IITB-Rocket-Team-Avionics/FLYTE/README.md

# FLYTE
Flight Computer for the IIT Bombay Rocket Team
