IITB-Rocket-Team-Avionics/FLYTE/Software_v2/PAYLOAD/README

# This folder has the libraries for the sensors used in the payload.
