IITB-Rocket-Team-Avionics/FLYTE/Eagle files/FLYTE 2.0/main/FLYTE-v2-obt.png

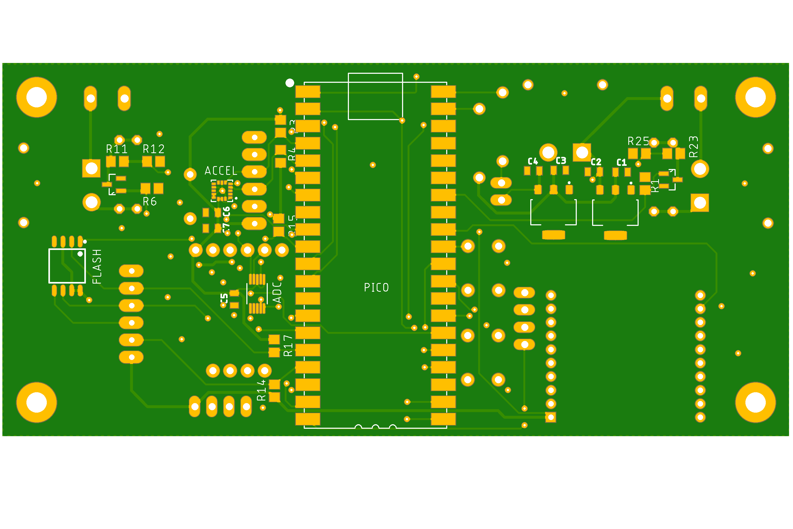
Eagle files/FLYTE 2.0/main/FLYTE-v2-obt.png
