IITB-Rocket-Team-Avionics/FLYTE/Eagle files/FLYTE 2.0/main/FLYTE-v2.png

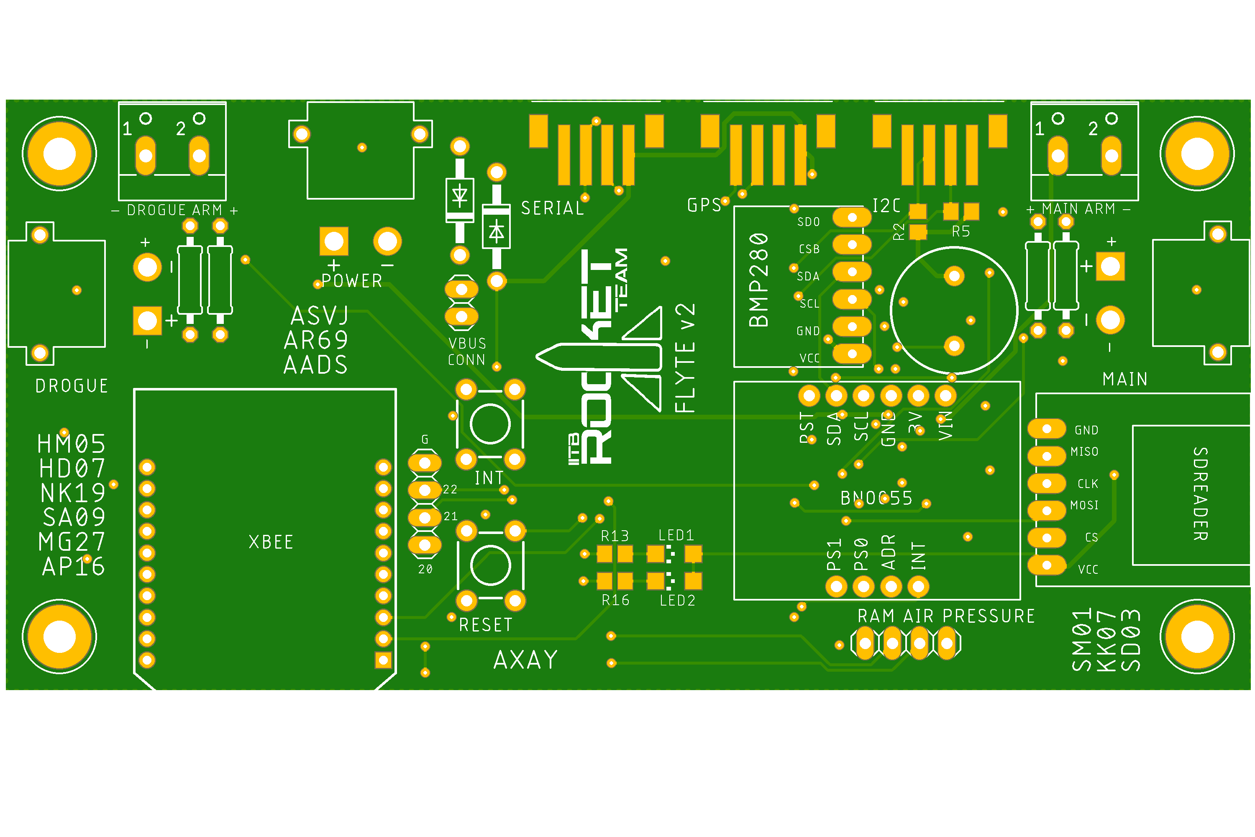
Eagle files/FLYTE 2.0/main/FLYTE-v2.png
