IITB-Rocket-Team-Avionics/FLYTE/Eagle files/FLYTE 2.0/main/motor_controller-BOT.png

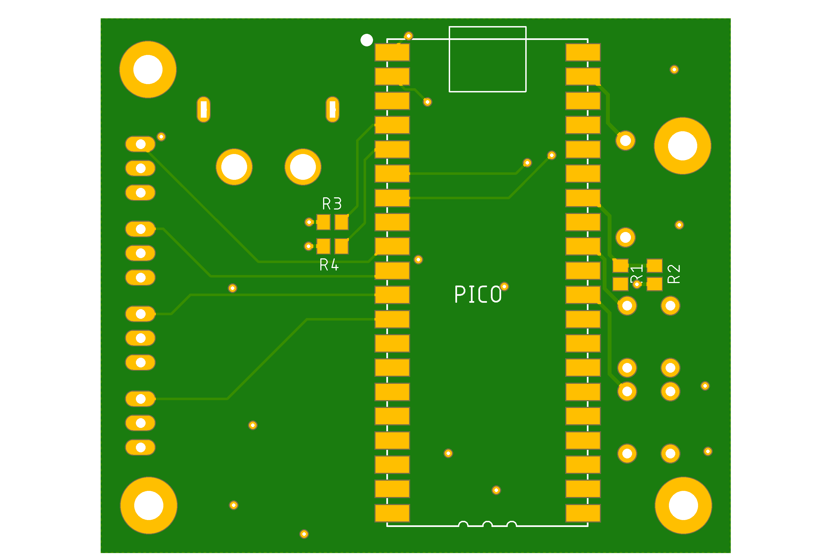
Eagle files/FLYTE 2.0/main/motor_controller-BOT.png
