IITB-Rocket-Team-Avionics/FLYTE/Eagle files/FLYTE 2.0/main/motor_controller.png

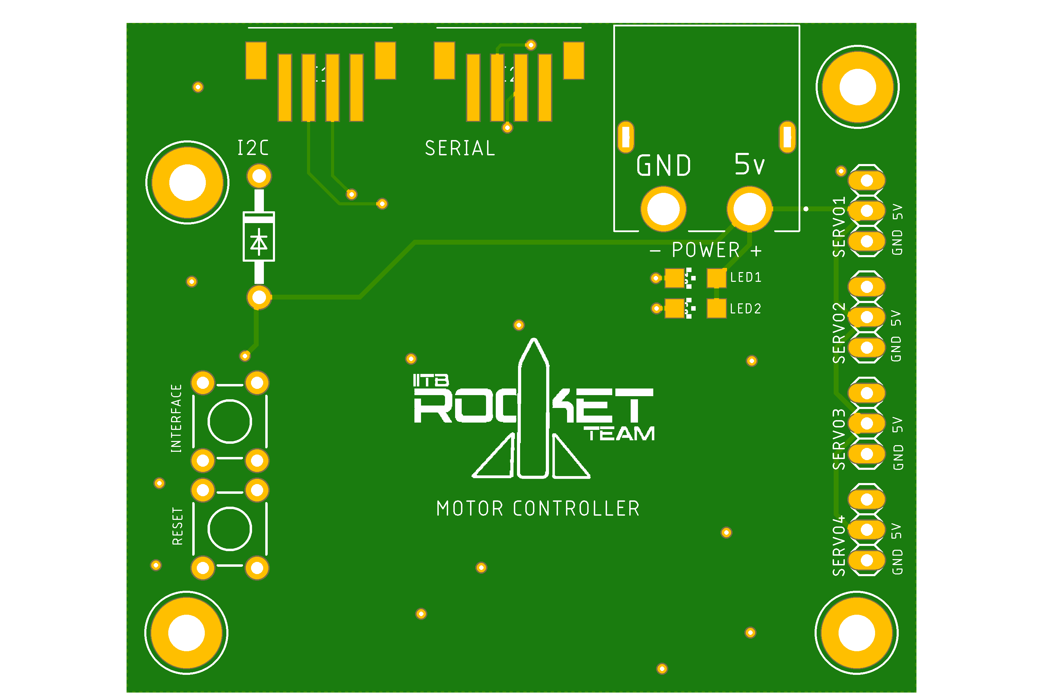
Eagle files/FLYTE 2.0/main/motor_controller.png
