IITB-Rocket-Team-Avionics/FLYTE/Eagle files/FLYTE 2.0/main/reefingBrd-BOT.png

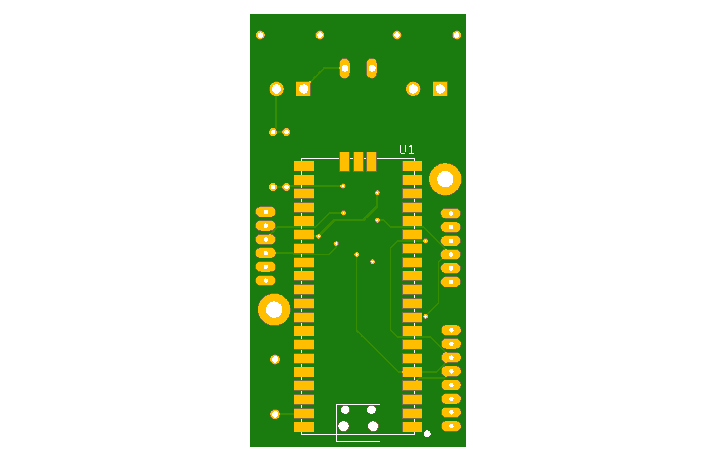
Eagle files/FLYTE 2.0/main/reefingBrd-BOT.png
