IITB-Rocket-Team-Avionics/FLYTE/Eagle files/FLYTE 2.0/Screenshot 2023-12-10 035226.png

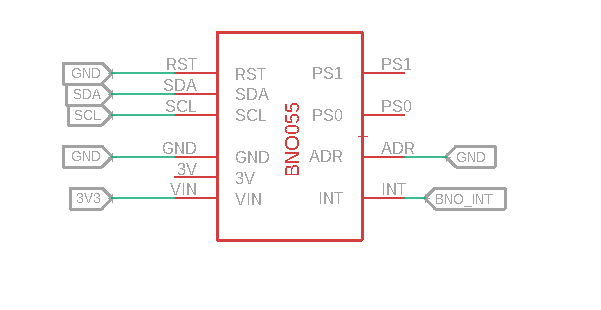
Eagle files/FLYTE 2.0/Screenshot 2023-12-10 035226.png
