IITB-Rocket-Team-Avionics/FLYTE/Eagle files/FLYTE 2.1/images/motor_controller_2_1.png

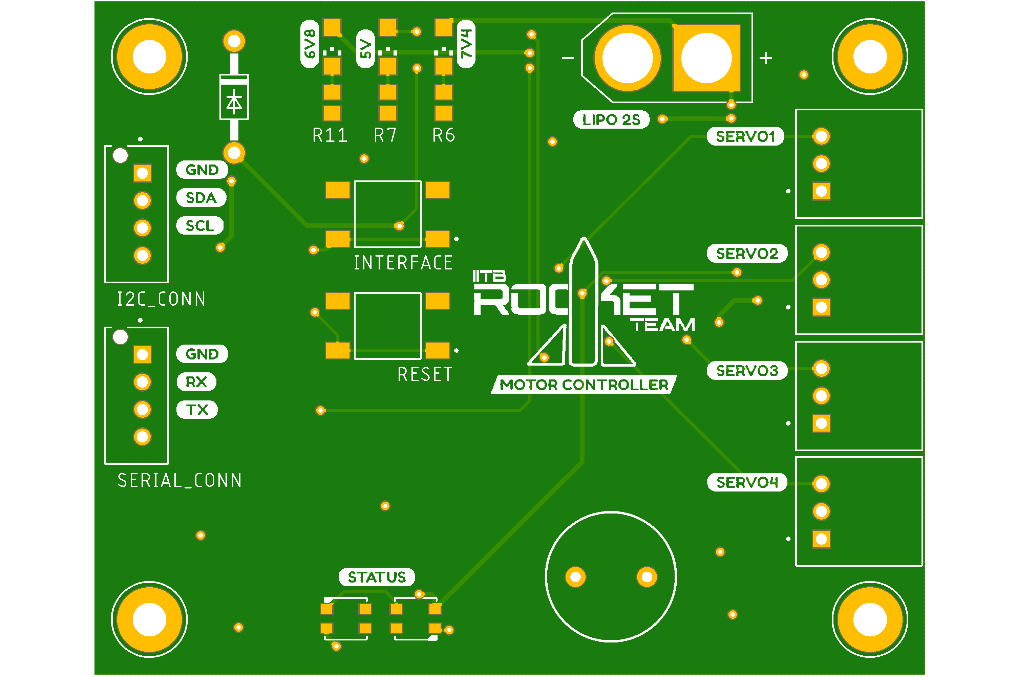
Eagle files/FLYTE 2.1/images/motor_controller_2_1.png
