IITB-Rocket-Team-Avionics/FLYTE/Eagle files/FLYTE 2.1/images/payload2.png

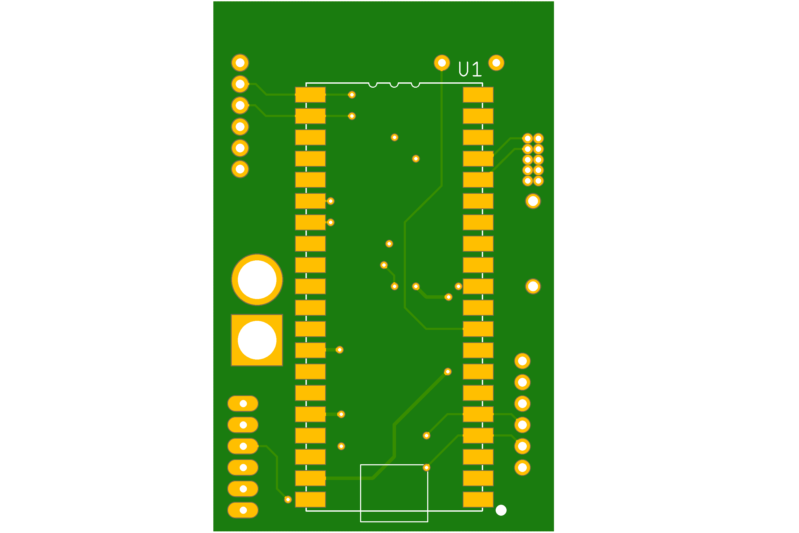
Eagle files/FLYTE 2.1/images/payload2.png
