IITB-Rocket-Team-Avionics/FLYTE/Eagle files/FLYTE 2.1/images/Payload.png

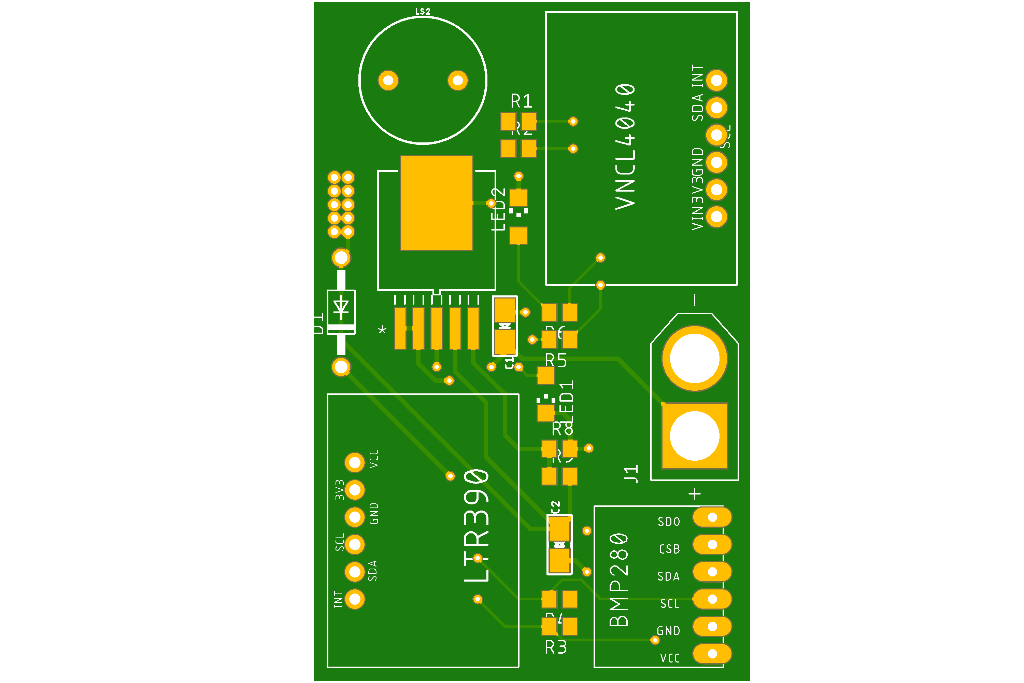
Eagle files/FLYTE 2.1/images/Payload.png
