IITB-Rocket-Team-Avionics/FLYTE/Eagle files/FLYTE 2.1/motor_controller_2_2.png

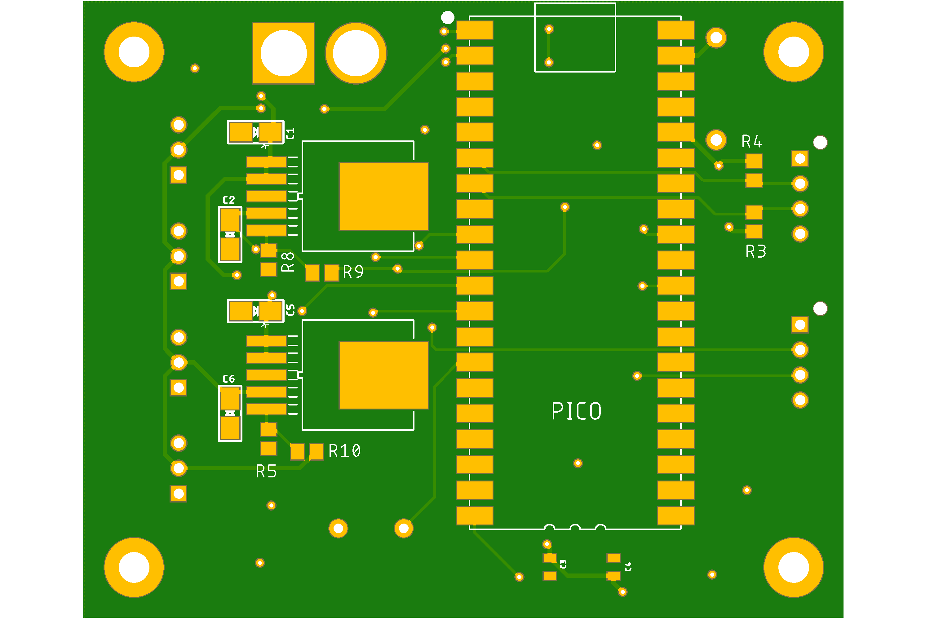
Eagle files/FLYTE 2.1/motor_controller_2_2.png
