IITB-Rocket-Team-Avionics/FLYTE/3D models/pressure_sensor_assy_HX710B.STEP

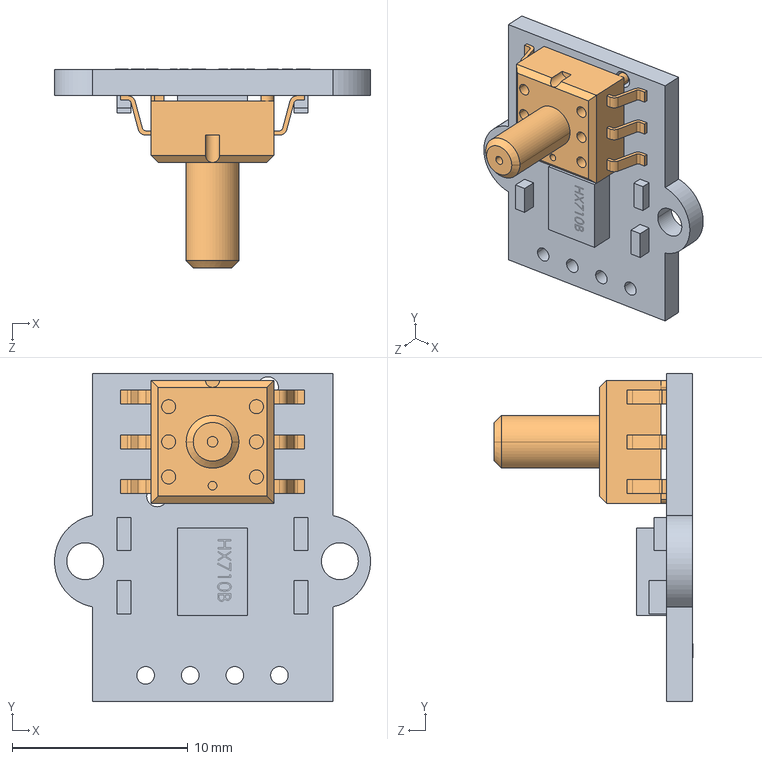
[picture p11: CAD file, 2024-01-20]
3D models/pressure_sensor_assy_HX710B.STEP
18.0 x 18.7 x 11.3 mm
pressure_sensor_pcb_HX710B
MPS-3117_По умолчанию
