IITB-Rocket-Team-Avionics/FLYTE/3D models/B5B-XH-A-LF--SN---3DModel-STEP-418109.STEP

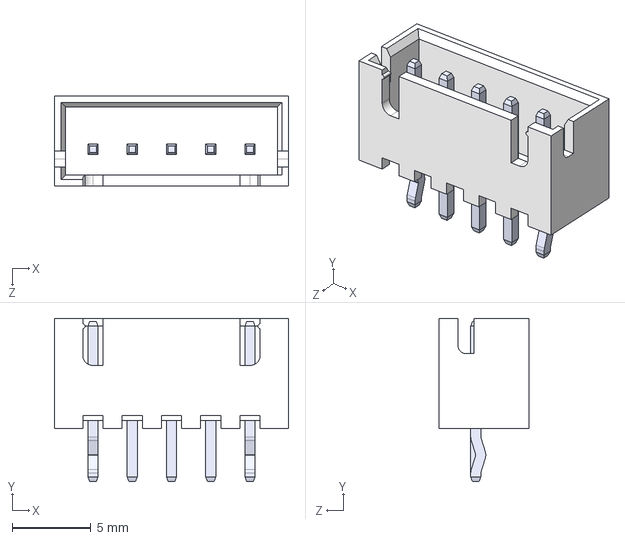
[picture p12: CAD file, 2024-05-10]
3D models/B5B-XH-A-LF--SN---3DModel-STEP-418109.STEP
14.9 x 10.4 x 5.75 mm
