IITB-Rocket-Team-Avionics/FLYTE/Eagle files/Ground-station/nuclear breifcase v4.dxf

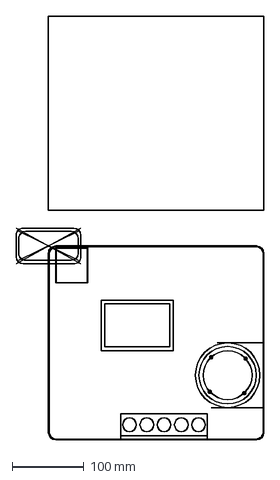
[picture p14: CAD file, 2025-03-29]
Eagle files/Ground-station/nuclear breifcase v4.dxf
345.0 x 590.0 mm
