IITB-Rocket-Team-Avionics/FLYTE/3D models/TAJA_AVX.step

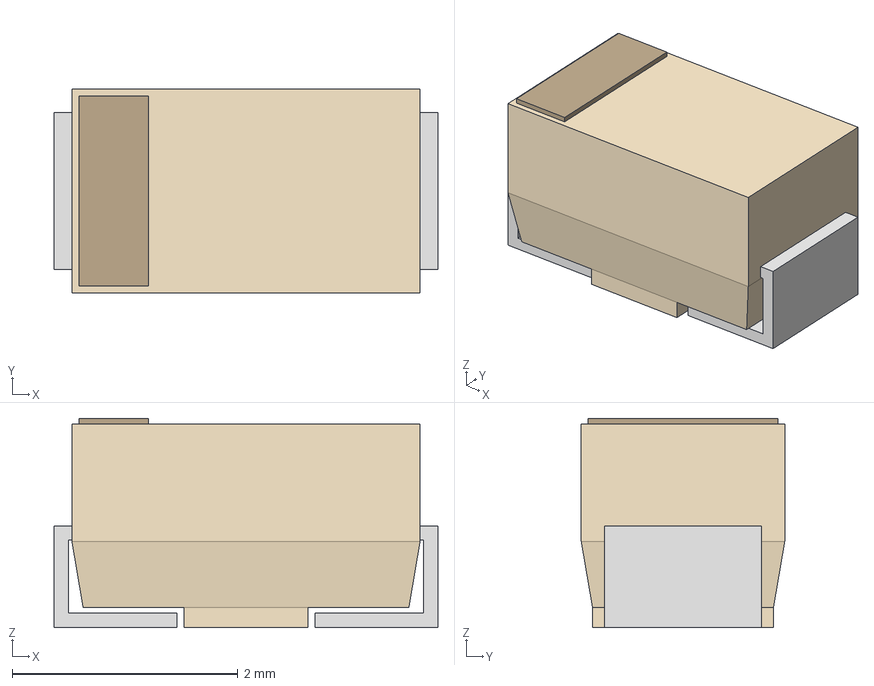
[picture p15: CAD file, 2024-05-10]
3D models/TAJA_AVX.step
3.40 x 1.80 x 1.85 mm
