IITB-Rocket-Team-Avionics/FLYTE/3D models/TO-263-5_MCH.step

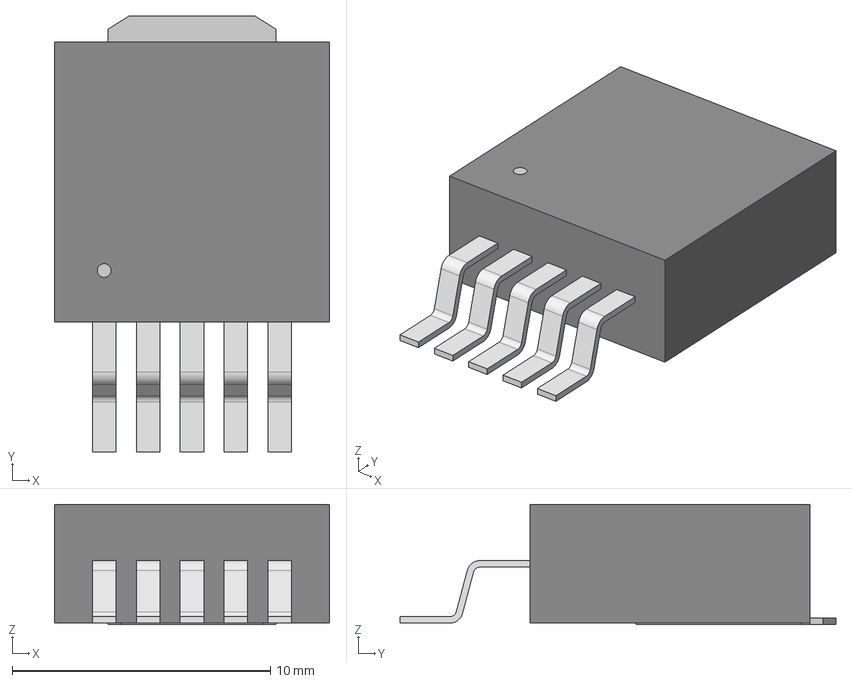
[picture p16: CAD file, 2024-05-10]
3D models/TO-263-5_MCH.step
10.7 x 16.9 x 4.65 mm
