IITB-Rocket-Team-Avionics/FLYTE/3D models/B6B-XH-A-LF--SN---3DModel-STEP-418109.STEP

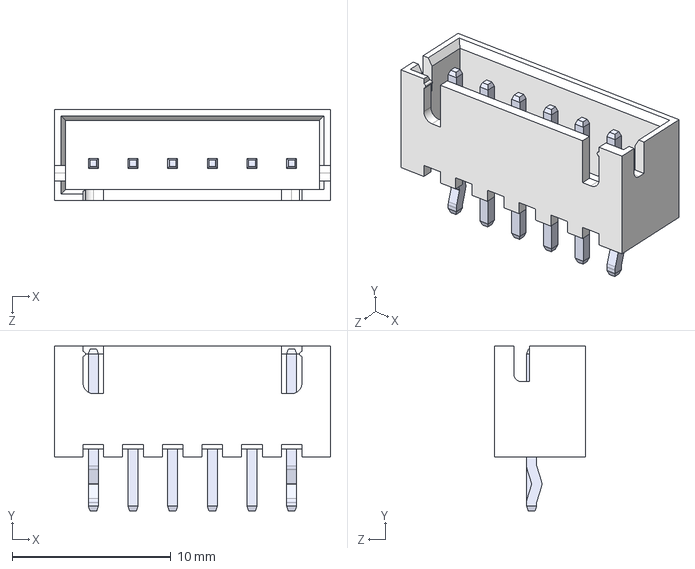
[picture p17: CAD file, 2024-05-09]
3D models/B6B-XH-A-LF--SN---3DModel-STEP-418109.STEP
17.4 x 10.4 x 5.75 mm
