IITB-Rocket-Team-Avionics/FLYTE/3D models/WS2812B--3DModel-STEP-510211.STEP

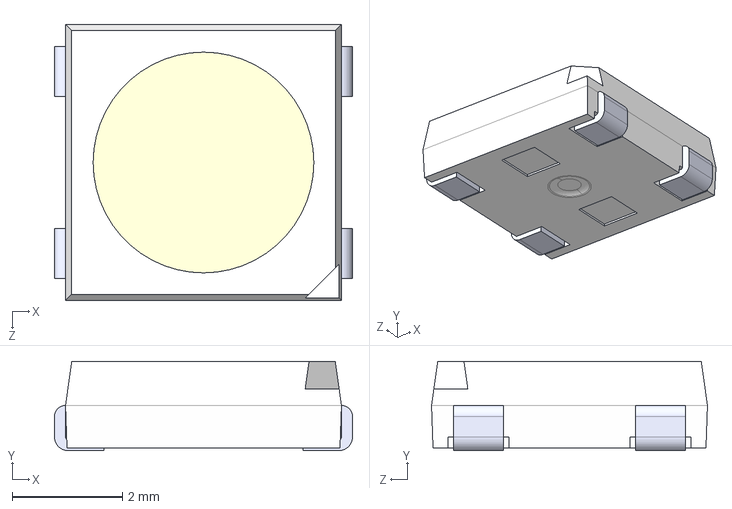
[picture p18: CAD file, 2024-05-08]
3D models/WS2812B--3DModel-STEP-510211.STEP
5.40 x 1.62 x 5.00 mm
