IITB-Rocket-Team-Avionics/FLYTE/3D models/TS04-66-95-BK-100-SMT--3DModel-STEP-56544.STEP

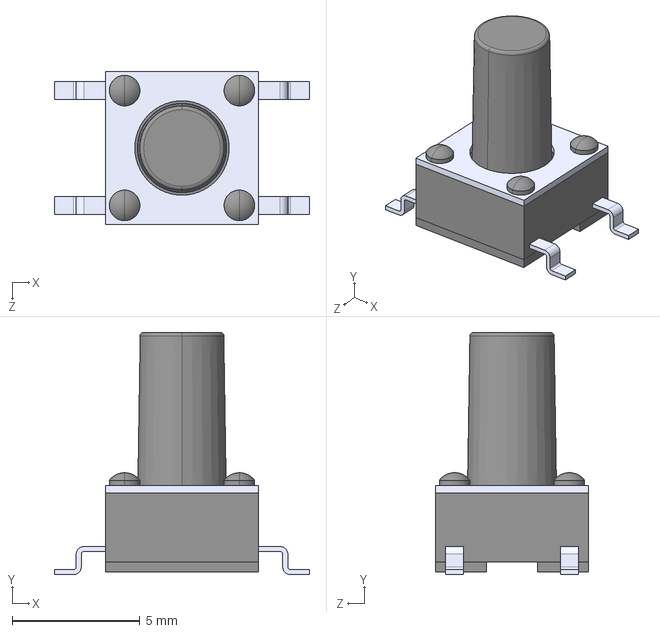
[picture p19: CAD file, 2024-05-08]
3D models/TS04-66-95-BK-100-SMT--3DModel-STEP-56544.STEP
10.0 x 9.50 x 6.00 mm
