IITB-Rocket-Team-Avionics/FLYTE/3D models/B4B-XH-AM -LF--SN---3DModel-STEP-56544.STEP

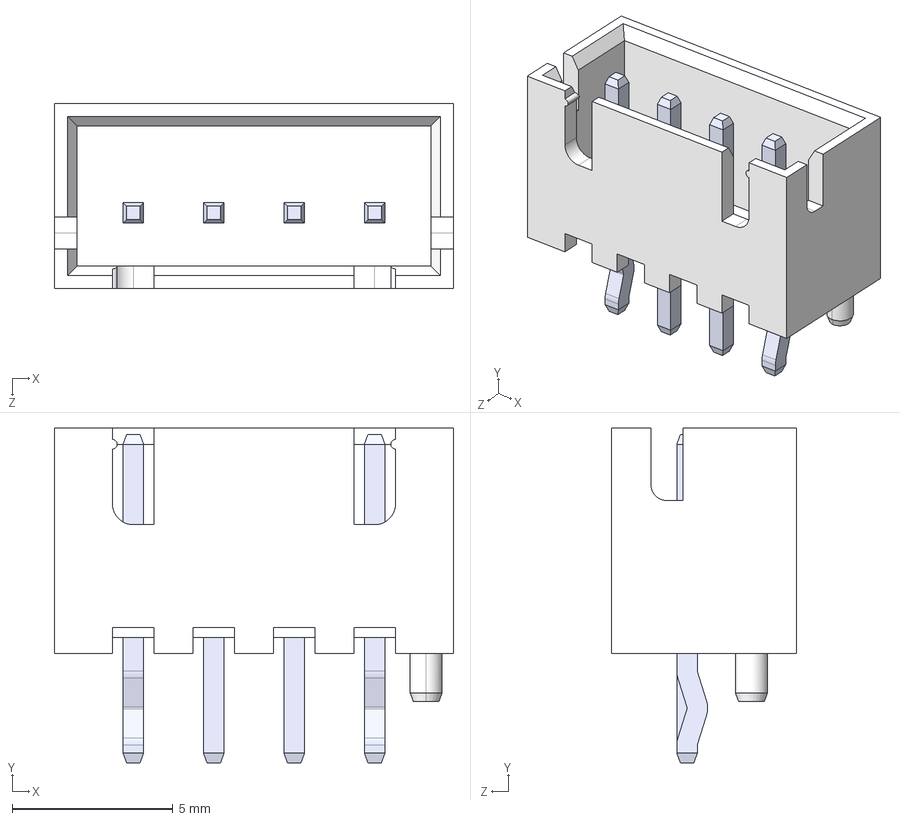
[picture p20: CAD file, 2024-05-08]
3D models/B4B-XH-AM -LF--SN---3DModel-STEP-56544.STEP
12.4 x 10.4 x 5.75 mm
