IITB-Rocket-Team-Avionics/FLYTE/3D models/S3B-XH-A-LF--SN---3DModel-STEP-56544.STEP

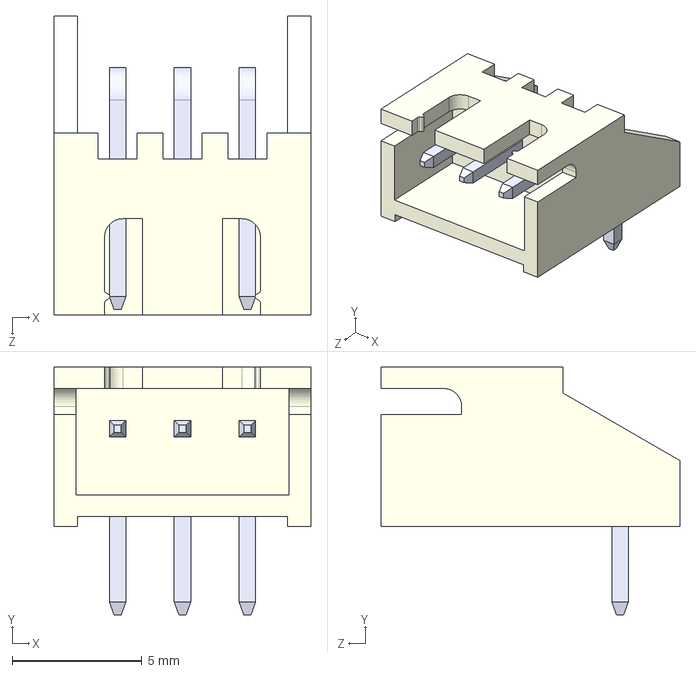
[picture p21: CAD file, 2024-05-08]
3D models/S3B-XH-A-LF--SN---3DModel-STEP-56544.STEP
9.90 x 9.55 x 11.5 mm
