IITB-Rocket-Team-Avionics/FLYTE/3D models/ITG-MPU.STEP

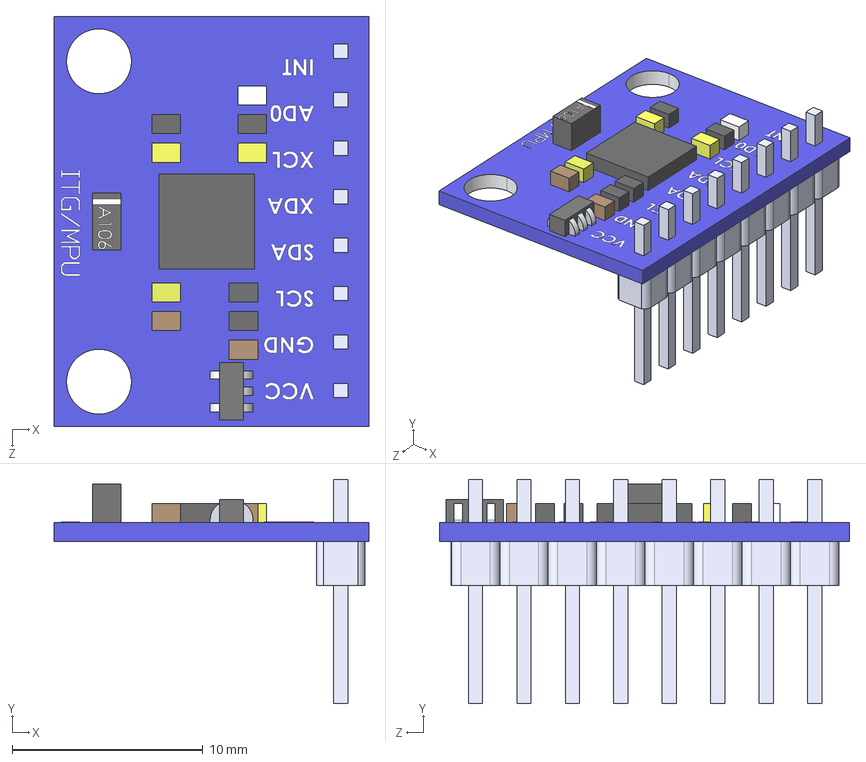
[picture p22: CAD file, 2024-01-25]
3D models/ITG-MPU.STEP
16.5 x 11.8 x 21.5 mm
8 Header-Pin
Placa_Base
