IITB-Rocket-Team-Avionics/FLYTE/3D models/XT60PW-F--3DModel-STEP-510211.STEP

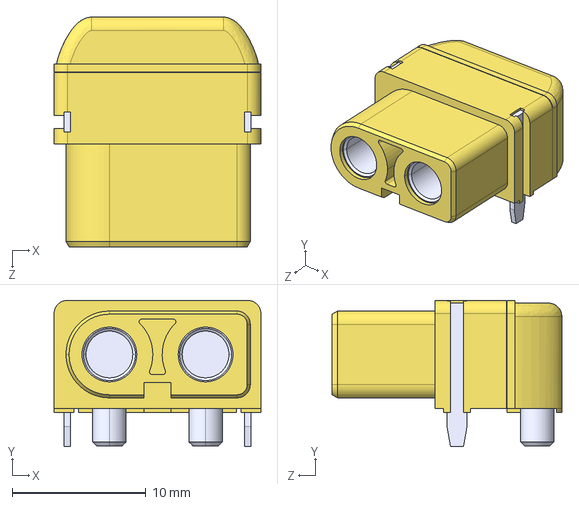
[picture p23: CAD file, 2024-01-20]
3D models/XT60PW-F--3DModel-STEP-510211.STEP
15.5 x 10.9 x 17.2 mm
