IITB-Rocket-Team-Avionics/FLYTE/3D models/XT30PW-M--3DModel-STEP-1.STEP

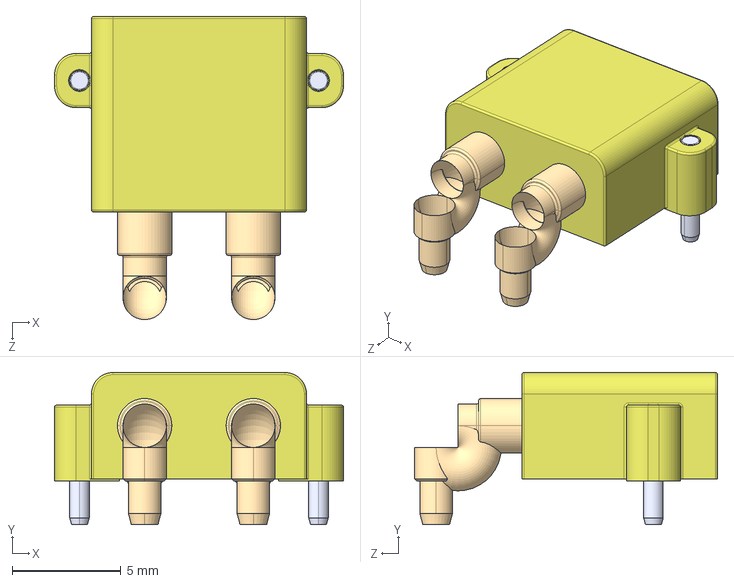
[picture p24: CAD file, 2024-01-20]
3D models/XT30PW-M--3DModel-STEP-1.STEP
13.3 x 7.00 x 14.0 mm
