IITB-Rocket-Team-Avionics/FLYTE/3D models/XBP24BZ7SIT-004-radio.STEP

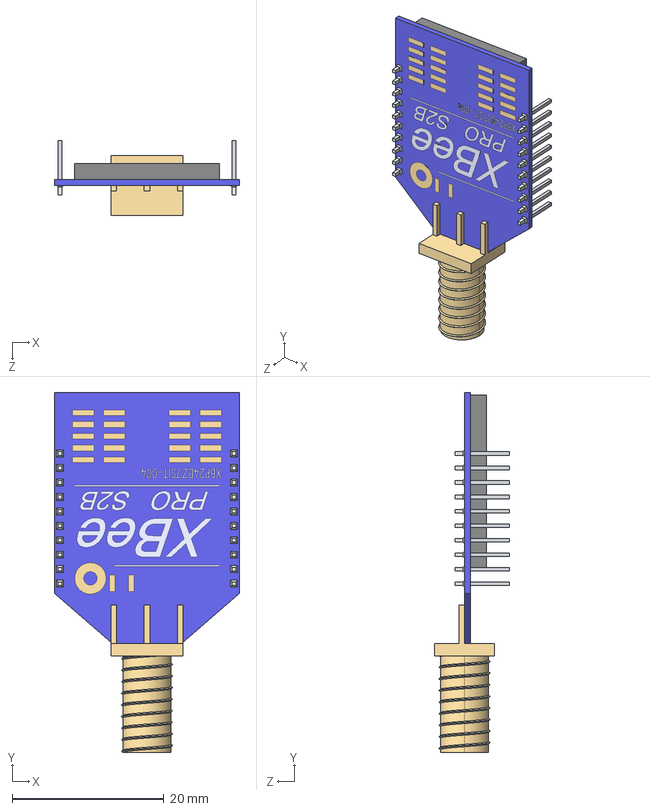
[picture p25: CAD file, 2024-01-20]
3D models/XBP24BZ7SIT-004-radio.STEP
24.4 x 47.4 x 9.88 mm
