IITB-Rocket-Team-Avionics/FLYTE/3D models/XbeePro-SMA.STEP

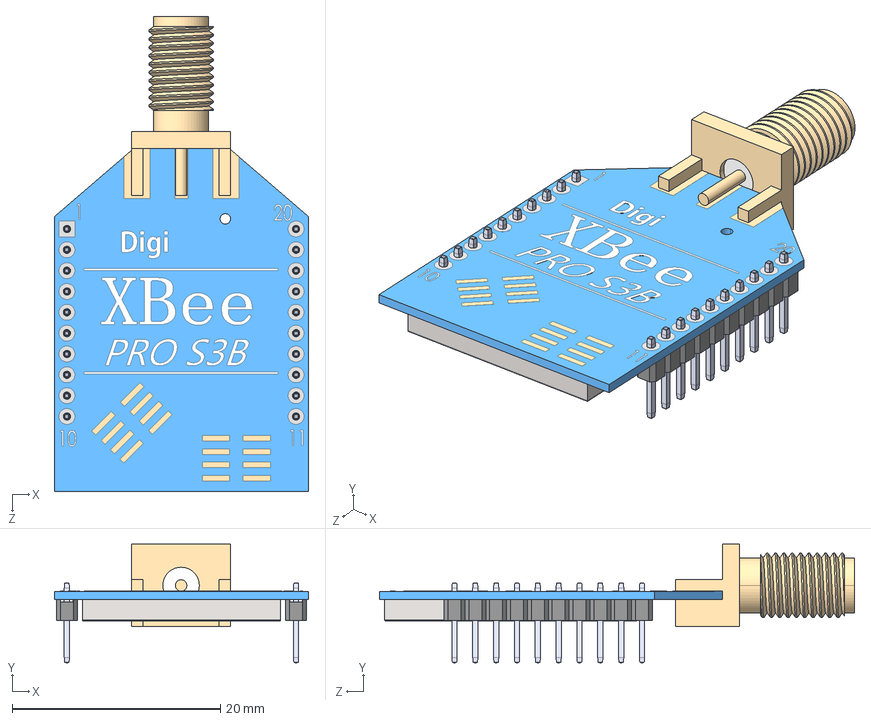
[picture p26: CAD file, 2024-01-20]
3D models/XbeePro-SMA.STEP
24.4 x 11.4 x 45.6 mm
XBP24_with_Pads.STEP
2mmHeaderPin_straight.STEP x 20
XBPro_shield.STEP
SMA-Z.STEP
