IITB-Rocket-Team-Avionics/FLYTE/3D models/Adafruit_BNO055_AP214.STEP

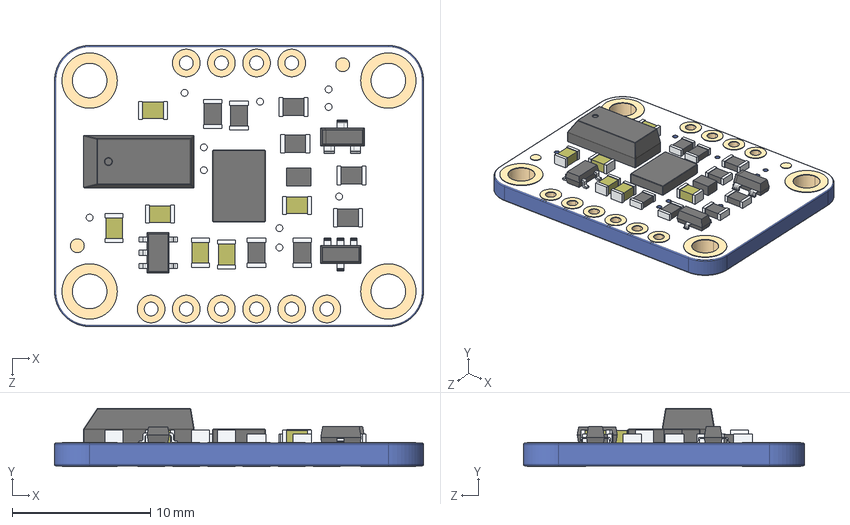
[picture p27: CAD file, 2024-01-20]
3D models/Adafruit_BNO055_AP214.STEP
26.7 x 4.20 x 20.3 mm
