IITB-Rocket-Team-Avionics/FLYTE/3D models/H3LIS200DLTR.STEP

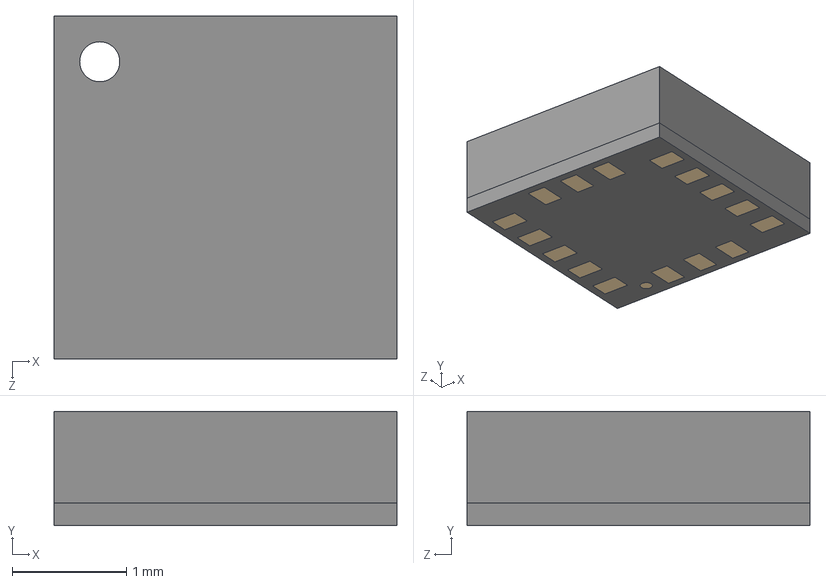
[picture p28: CAD file, 2024-01-20]
3D models/H3LIS200DLTR.STEP
3.00 x 1.00 x 3.00 mm
