IITB-Rocket-Team-Avionics/FLYTE/3D models/S4B-PH-SM4-TB.stp

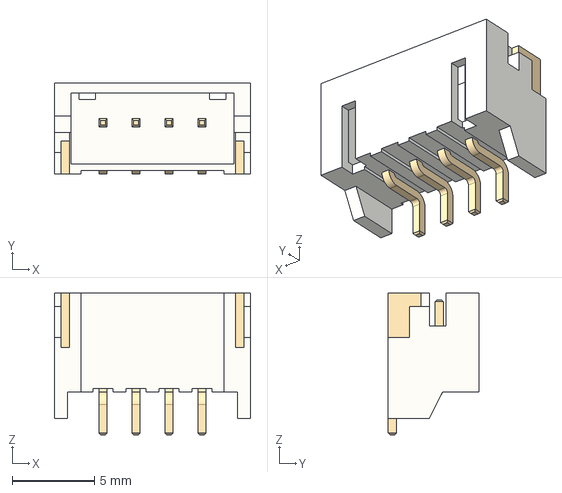
[picture p29: CAD file, 2024-01-20]
3D models/S4B-PH-SM4-TB.stp
11.9 x 5.50 x 8.60 mm
