IITB-Rocket-Team-Avionics/FLYTE/3D models/ADS1115IDGSR.STEP

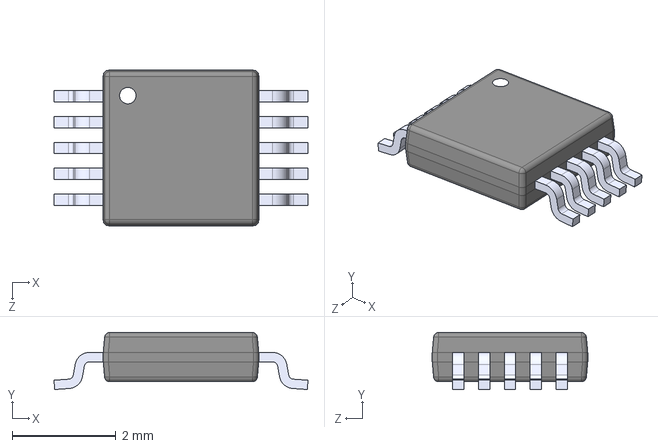
[picture p30: CAD file, 2024-01-20]
3D models/ADS1115IDGSR.STEP
4.90 x 1.10 x 3.00 mm
