IITB-Rocket-Team-Avionics/FLYTE/3D models/SMBJ40CA-HR.stp

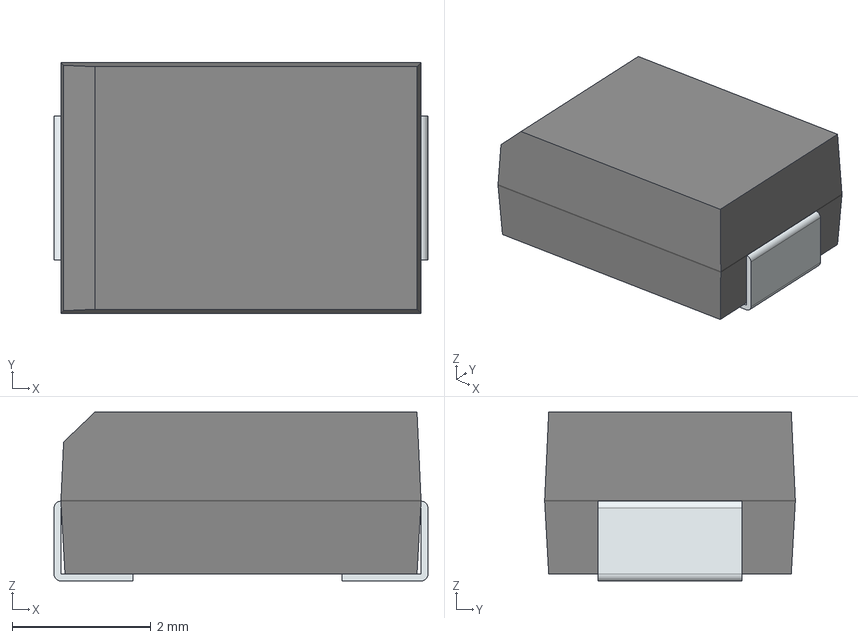
[picture p31: CAD file, 2023-12-21]
3D models/SMBJ40CA-HR.stp
5.40 x 3.62 x 2.44 mm
FilletPin1
FilletPin2
