IITB-Rocket-Team-Avionics/FLYTE/3D models/toggle.STEP

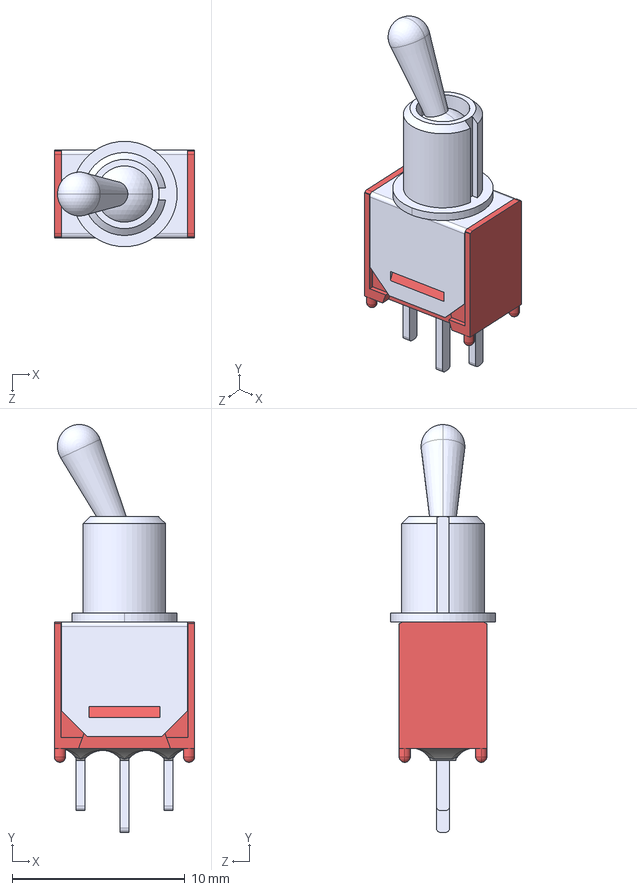
[picture p32: CAD file, 2023-05-24]
3D models/toggle.STEP
8.13 x 23.6 x 6.10 mm
