IITB-Rocket-Team-Avionics/FLYTE/3D models/HX711.step

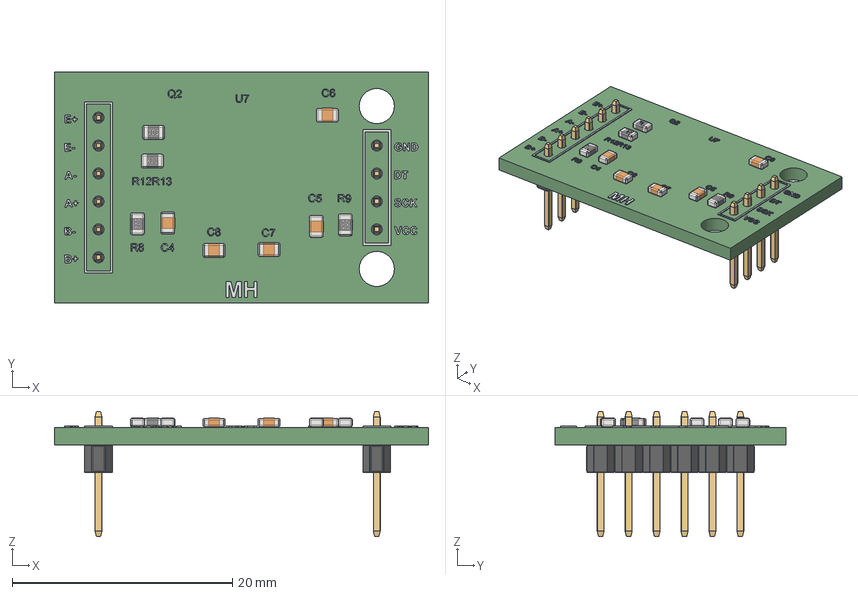
[picture p33: CAD file, 2023-05-24]
3D models/HX711.step
34.0 x 21.0 x 11.4 mm
Valor predeterminado
Valor predeterminado_1
Valor predeterminado_2 x 2
base_HX711-1
pino_HX711-1
pino_HX711-2
pino_HX711-3
pino_HX711-4
pino_HX711-5
pino_HX711-6
pino_HX711-7
pino_HX711-8
pino_HX711-9
pino_HX711-10
pino_HX711-11
pino_HX711-12
pino_HX711-13
pino_HX711-14
pino_HX711-15
pino_HX711-16
TRANSISTOR_SOT23-1
PINO_SOT23-1
PINO_SOT23-2
PINO_SOT23-3
Valor predeterminado_5 x 5
Male Pin Header x 4
Male Pin Header_1 x 6
