IITB-Rocket-Team-Avionics/FLYTE/3D models/XT30-female.stl

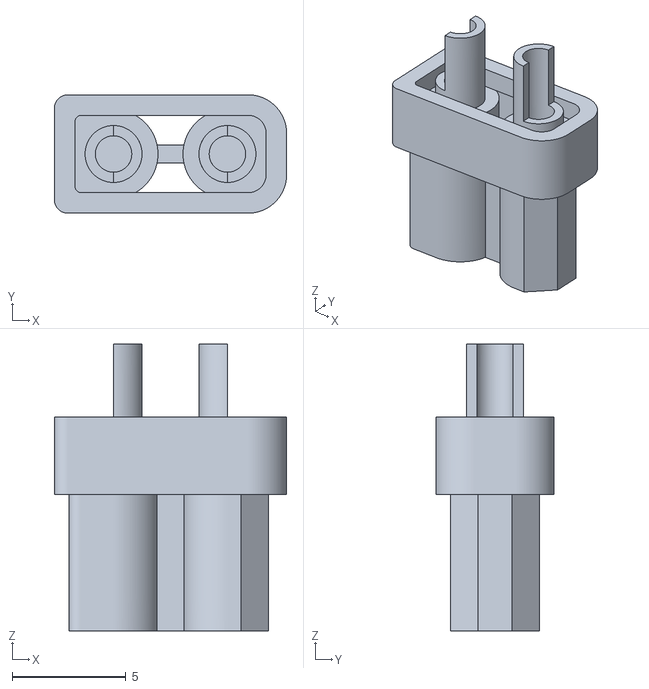
[picture p34: CAD file, 2023-05-14]
3D models/XT30-female.stl
10.2 x 5.20 x 12.6
