IITB-Rocket-Team-Avionics/FLYTE/3D models/MicroSD Card Module - 1.stp

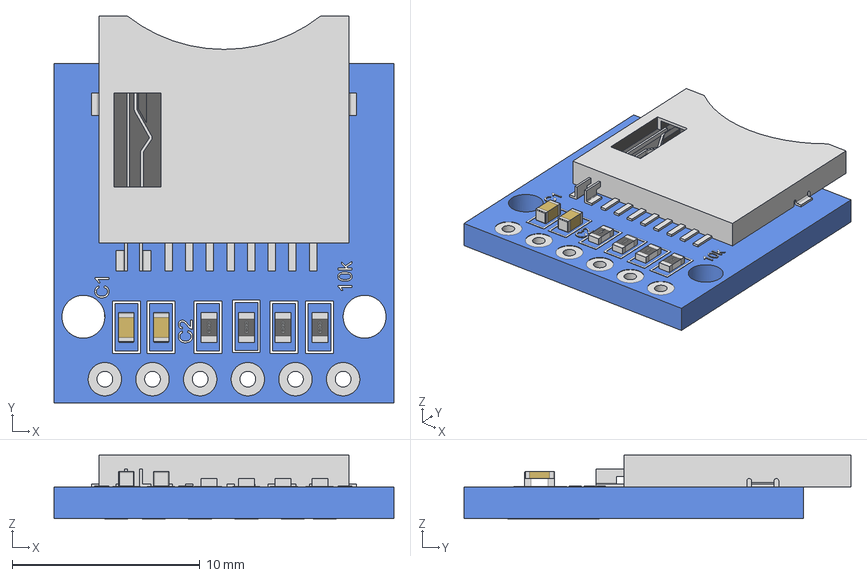
[picture p35: CAD file, 2023-05-14]
3D models/MicroSD Card Module - 1.stp
18.1 x 20.6 x 3.40 mm
Micro SD Module - 1
MicroSD
0603 Capacitor x 2
0603 Resistor x 4
