IITB-Rocket-Team-Avionics/FLYTE/3D models/PLS2-3.step

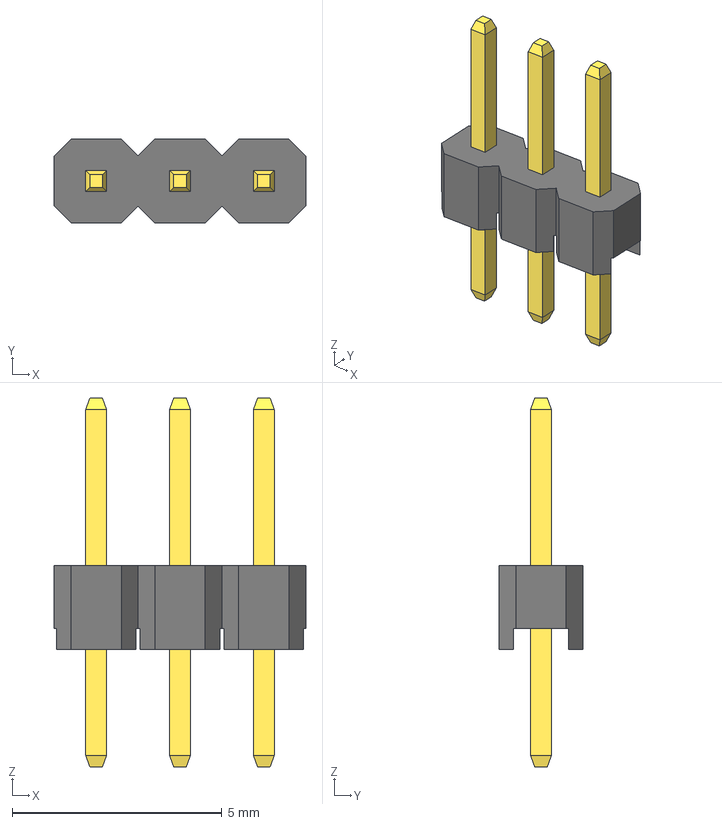
[picture p36: CAD file, 2023-05-14]
3D models/PLS2-3.step
6.00 x 2.00 x 8.80 mm
