IITB-Rocket-Team-Avionics/FLYTE/3D models/XT30-male.stp

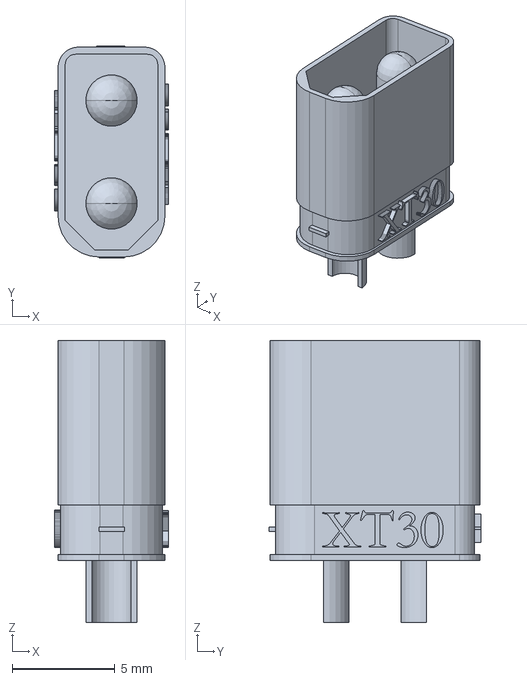
[picture p37: CAD file, 2023-05-14]
3D models/XT30-male.stp
5.54 x 10.3 x 13.7 mm
