IITB-Rocket-Team-Avionics/FLYTE/3D models/GPS_18x18_ant.stp

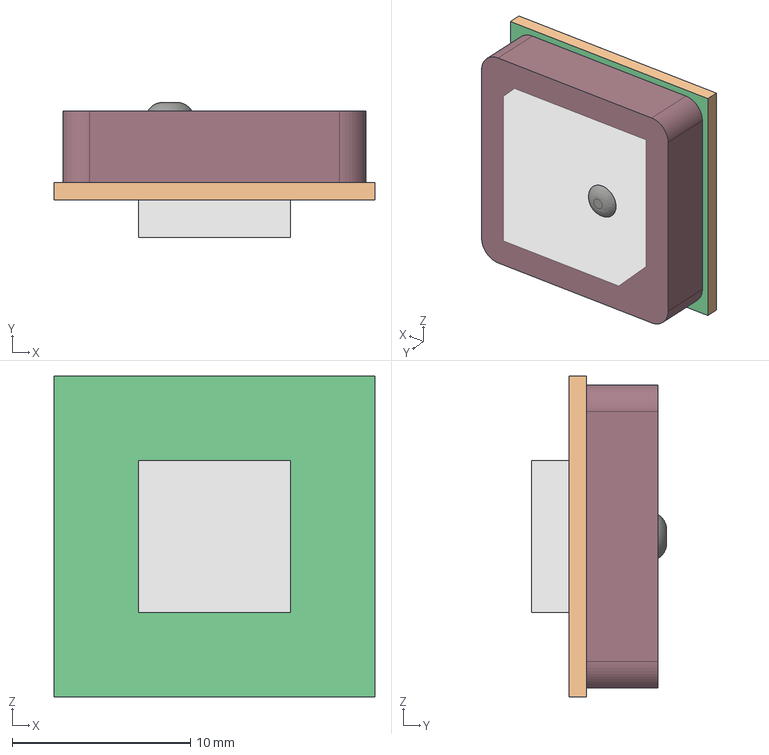
[picture p38: CAD file, 2023-05-13]
3D models/GPS_18x18_ant.stp
18.0 x 7.59 x 18.0 mm
