IITB-Rocket-Team-Avionics/FLYTE/3D models/W25Q32JVSSIQ--3DModel-STEP-269445.STEP

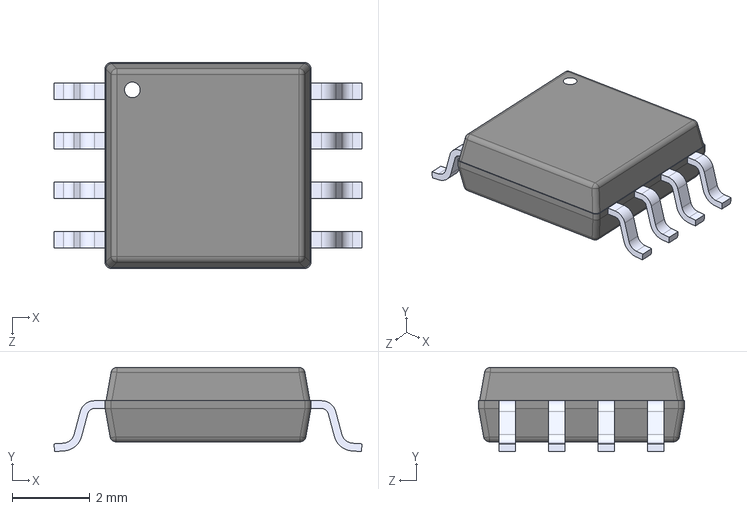
[picture p39: CAD file, 2023-05-13]
3D models/W25Q32JVSSIQ--3DModel-STEP-269445.STEP
7.90 x 2.16 x 5.28 mm
