IITB-Rocket-Team-Avionics/FLYTE/3D models/CONSMA002--3DModel-STEP-1.STEP

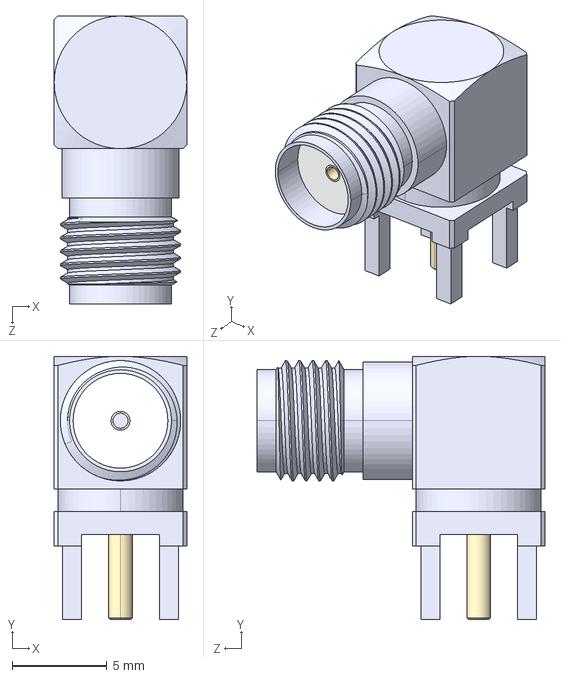
[picture p40: CAD file, 2023-05-13]
3D models/CONSMA002--3DModel-STEP-1.STEP
7.00 x 13.9 x 15.2 mm
