IITB-Rocket-Team-Avionics/FLYTE/3D models/TL1105F160Q--3DModel-STEP-56544.STEP

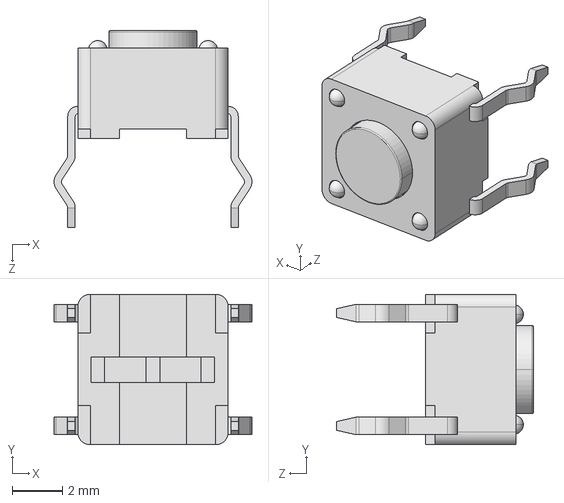
[picture p41: CAD file, 2023-05-13]
3D models/TL1105F160Q--3DModel-STEP-56544.STEP
7.89 x 6.00 x 7.85 mm
