IITB-Rocket-Team-Avionics/FLYTE/3D models/SC0915--3DModel-STEP-56544.STEP

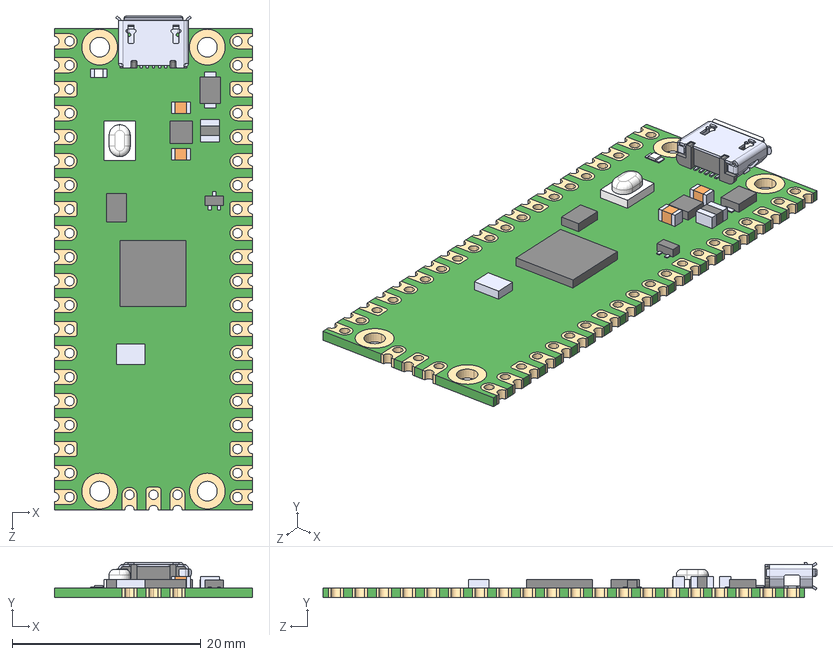
[picture p42: CAD file, 2023-05-13]
3D models/SC0915--3DModel-STEP-56544.STEP
21.0 x 3.73 x 52.3 mm
