IITB-Rocket-Team-Avionics/FLYTE/3D models/XT60-M--3DModel-STEP-56544.STEP

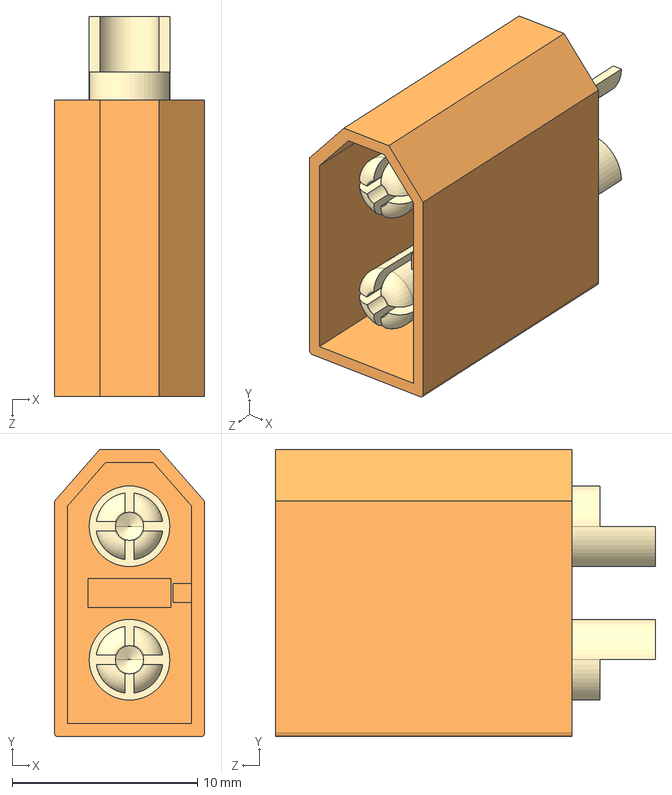
[picture p43: CAD file, 2023-05-10]
3D models/XT60-M--3DModel-STEP-56544.STEP
8.10 x 15.5 x 20.5 mm
