IITB-Rocket-Team-Avionics/FLYTE/3D models/IRF540NPBF.STEP

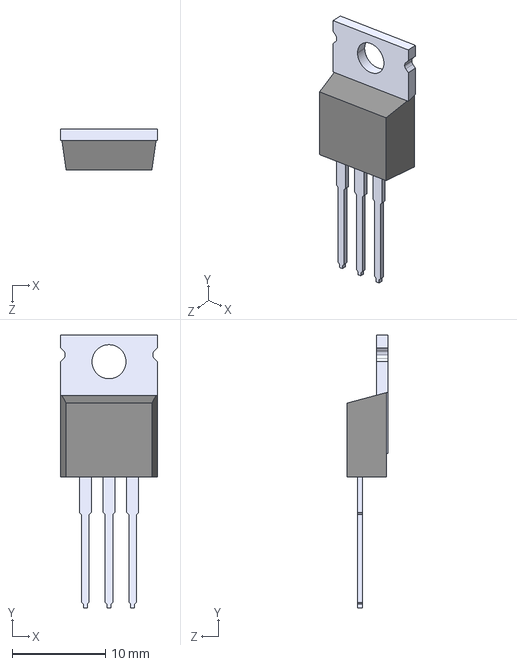
[picture p44: CAD file, 2023-05-10]
3D models/IRF540NPBF.STEP
10.4 x 29.3 x 4.45 mm
