IITB-Rocket-Team-Avionics/FLYTE/3D models/LD051A121KAB2A.STEP

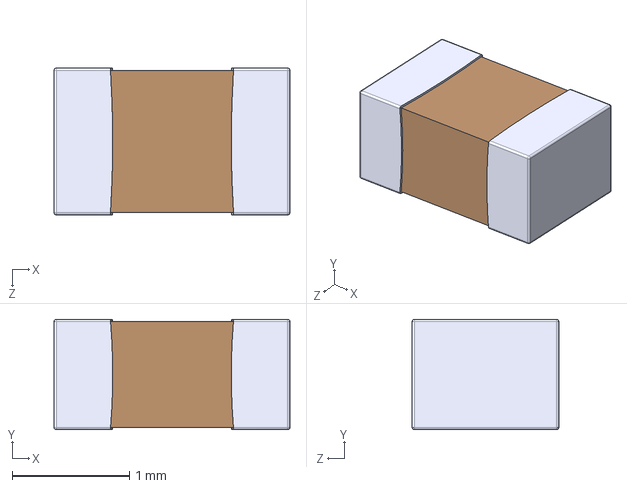
[picture p45: CAD file, 2023-05-10]
3D models/LD051A121KAB2A.STEP
2.01 x 0.94 x 1.25 mm
