IITB-Rocket-Team-Avionics/FLYTE/3D models/ublox NEO-6M.STEP

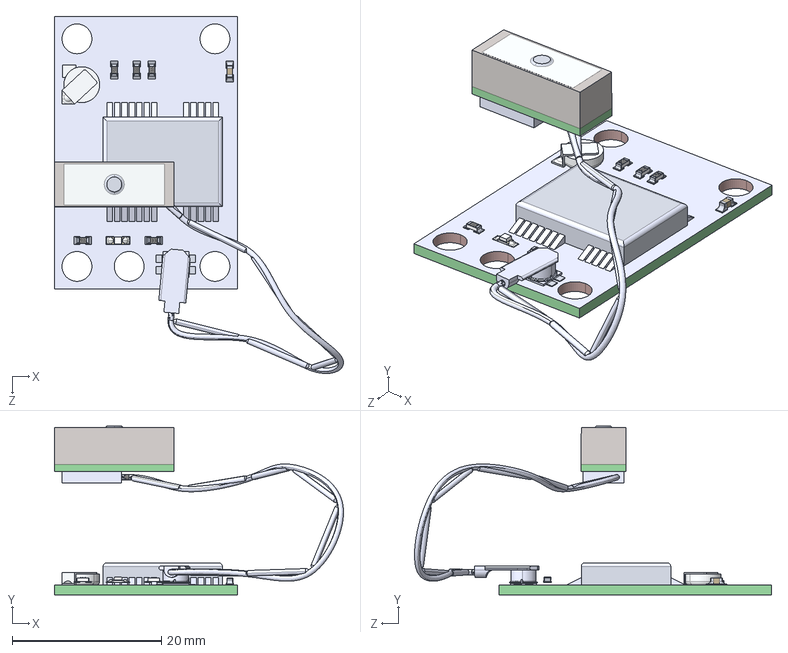
[picture p46: CAD file, 2023-05-07]
3D models/ublox NEO-6M.STEP
38.7 x 22.6 x 47.9 mm
GPS_pcb
GPS_cap
GPS_res221 x 2
GPS_res472 x 2
GPS_battery
GPS_res100
GPS_led
GPS_connector
Antenna_connector
Antenna
Rod x 7
cable
