IITB-Rocket-Team-Avionics/FLYTE/(list of files, cad)

Other CAD files:
3D models/1825159-1.stp
3D models/SIP 100-3 v2.f3d
3D models/Screw Terminal Block 5mm 2-way.step
3D models/SparkFun_IMU_Breakout_ICM-20948 v4.f3d
3D models/m3-washer.STEP
3D models/pressure_sensor_assy_HX710B.IGS
