IITB-Rocket-Team-Avionics/FLYTE/Eagle files/Prototypes/RF Test/SX1272/SX1272 Reference Schematic.pdf

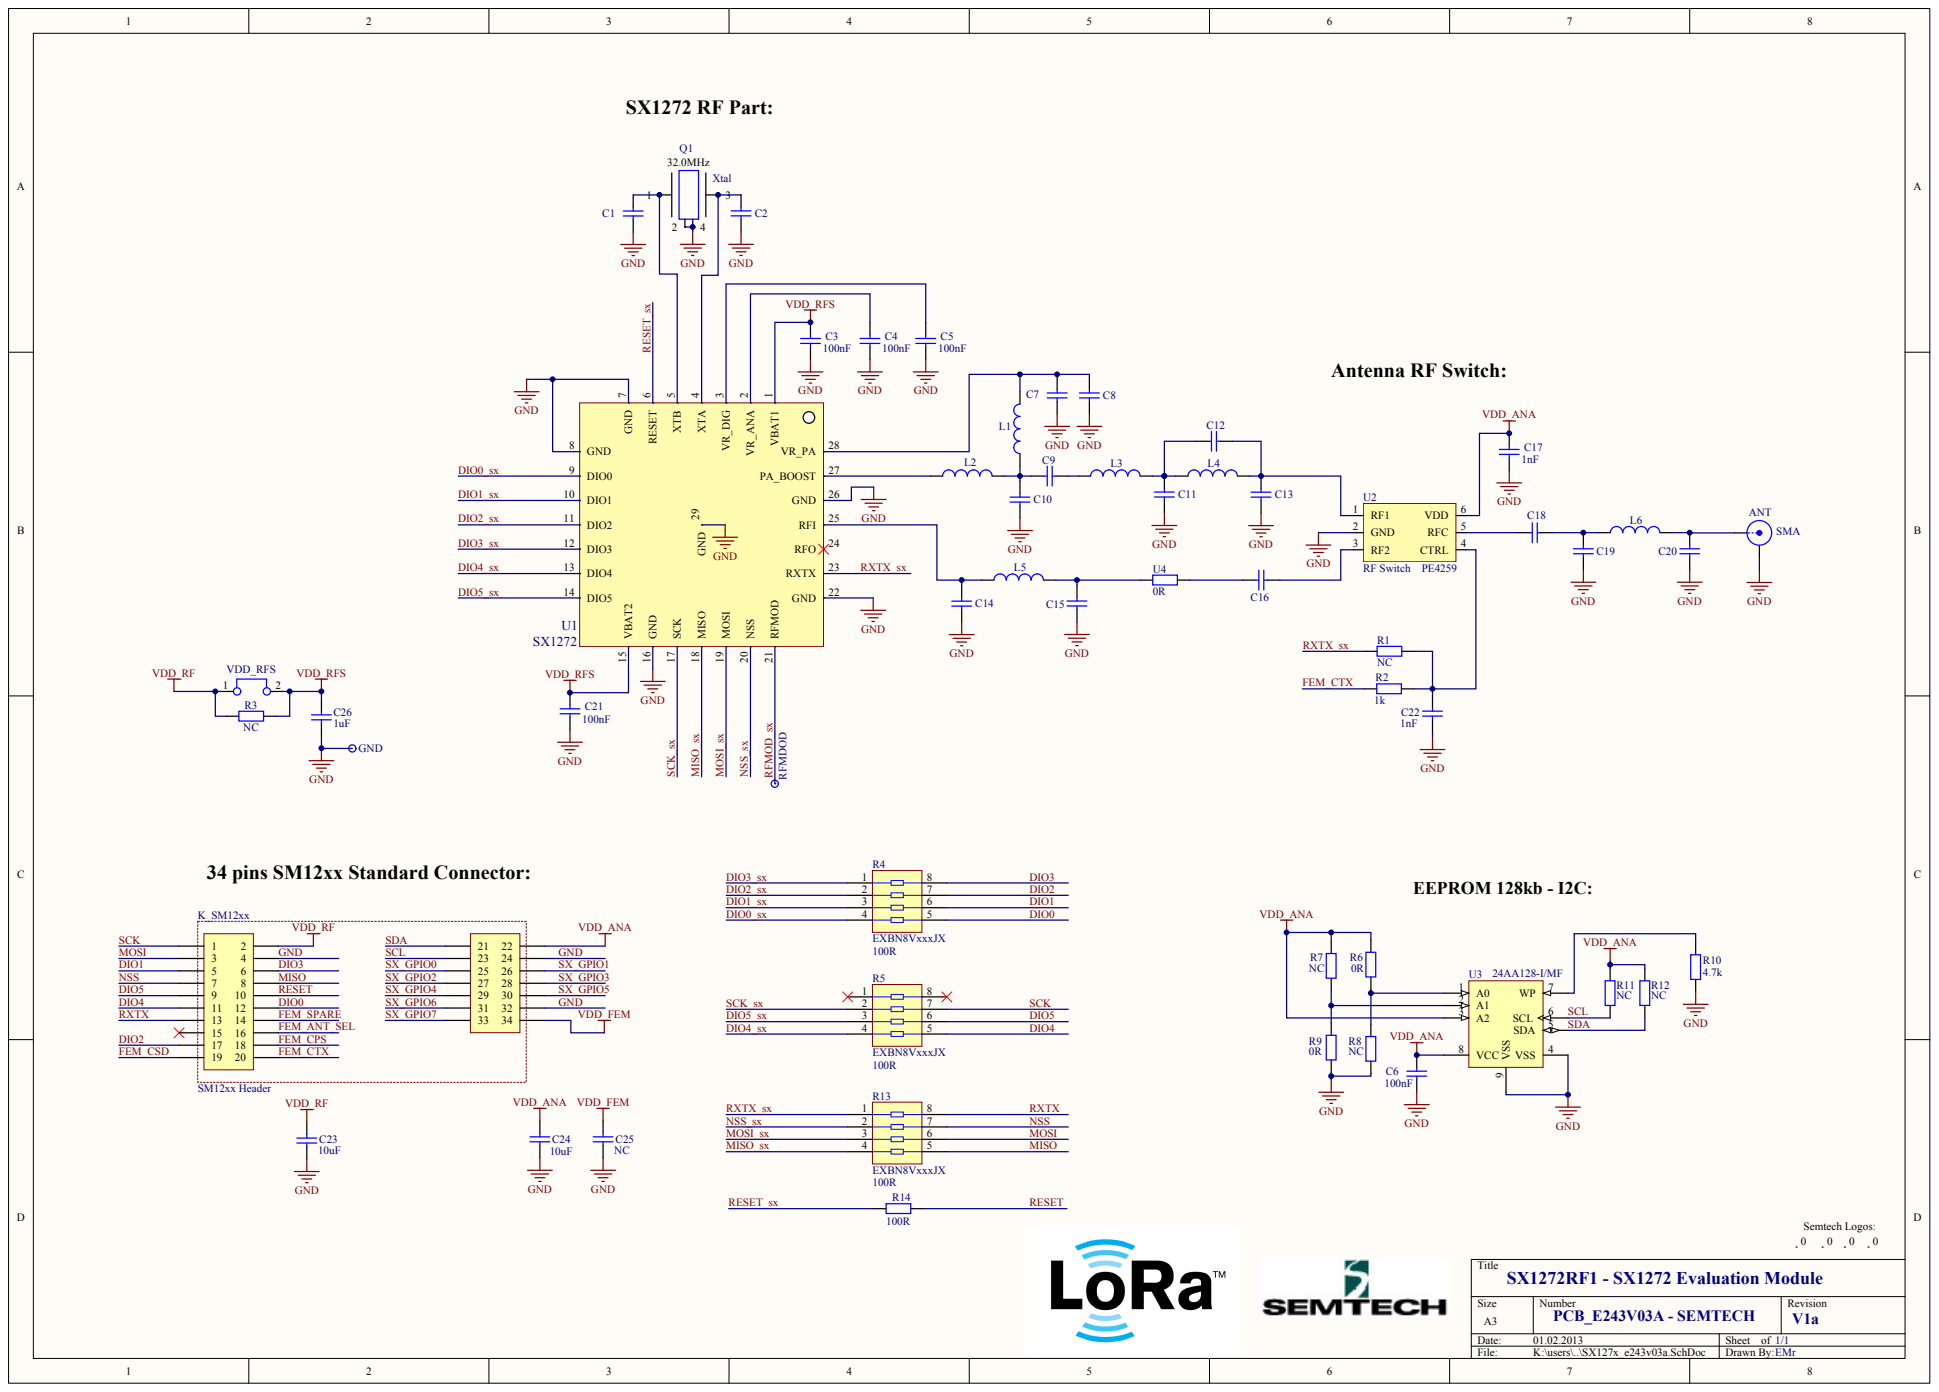
[picture p47: page 1]
