IITB-Rocket-Team-Avionics/FLYTE/Eagle files/Ground-station/GND_STN.brd

## EAGLE design Eagle files/Ground-station/GND_STN.brd (2025-05-17)

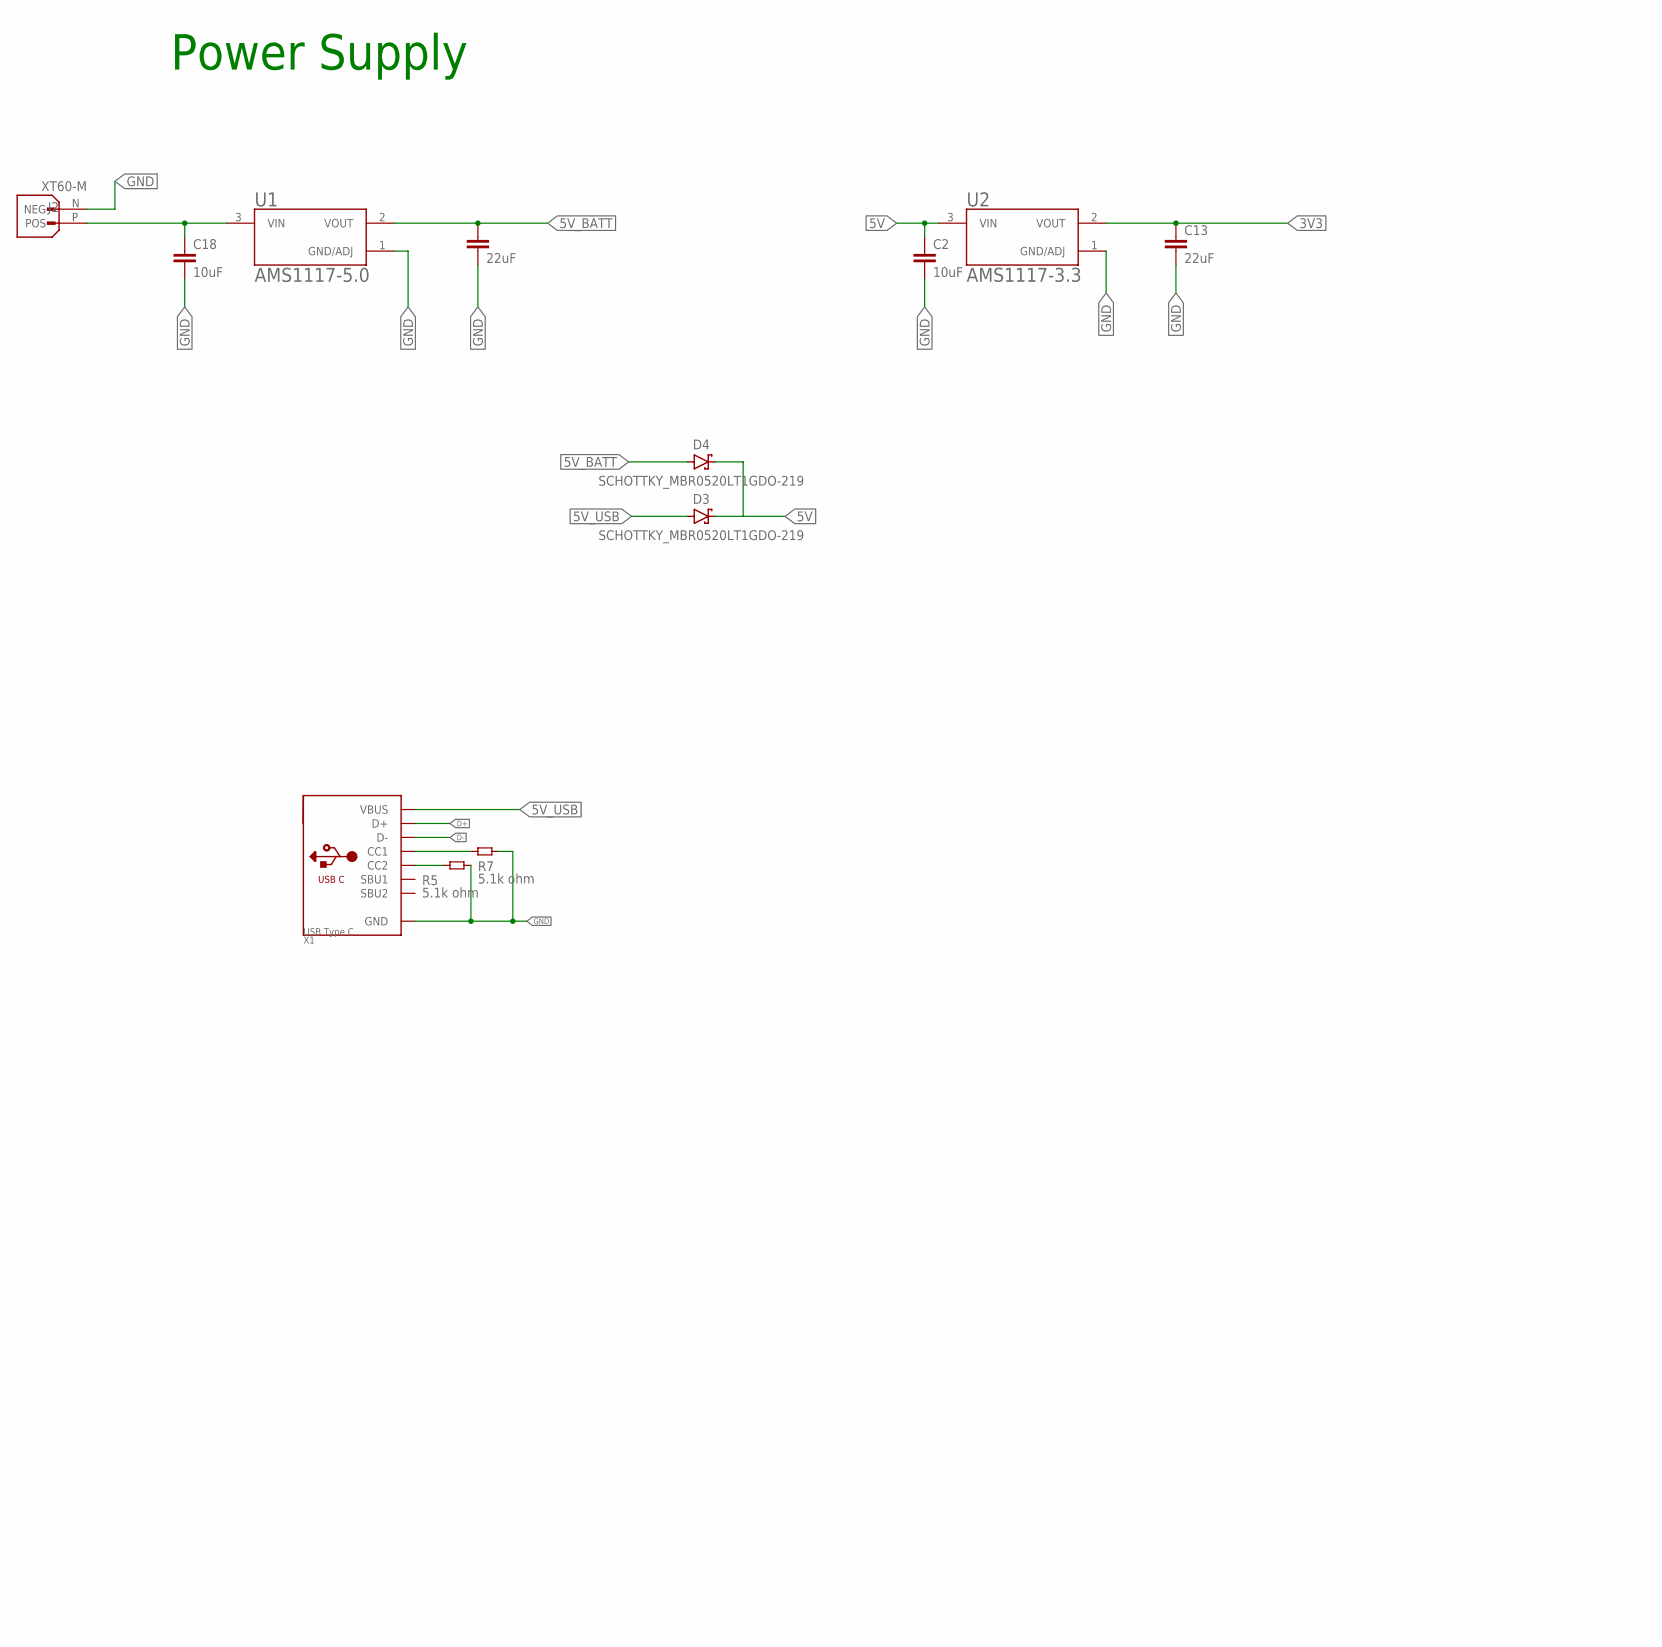
[picture p48: schematic GND_STN.sch, part in row 1, column 1]

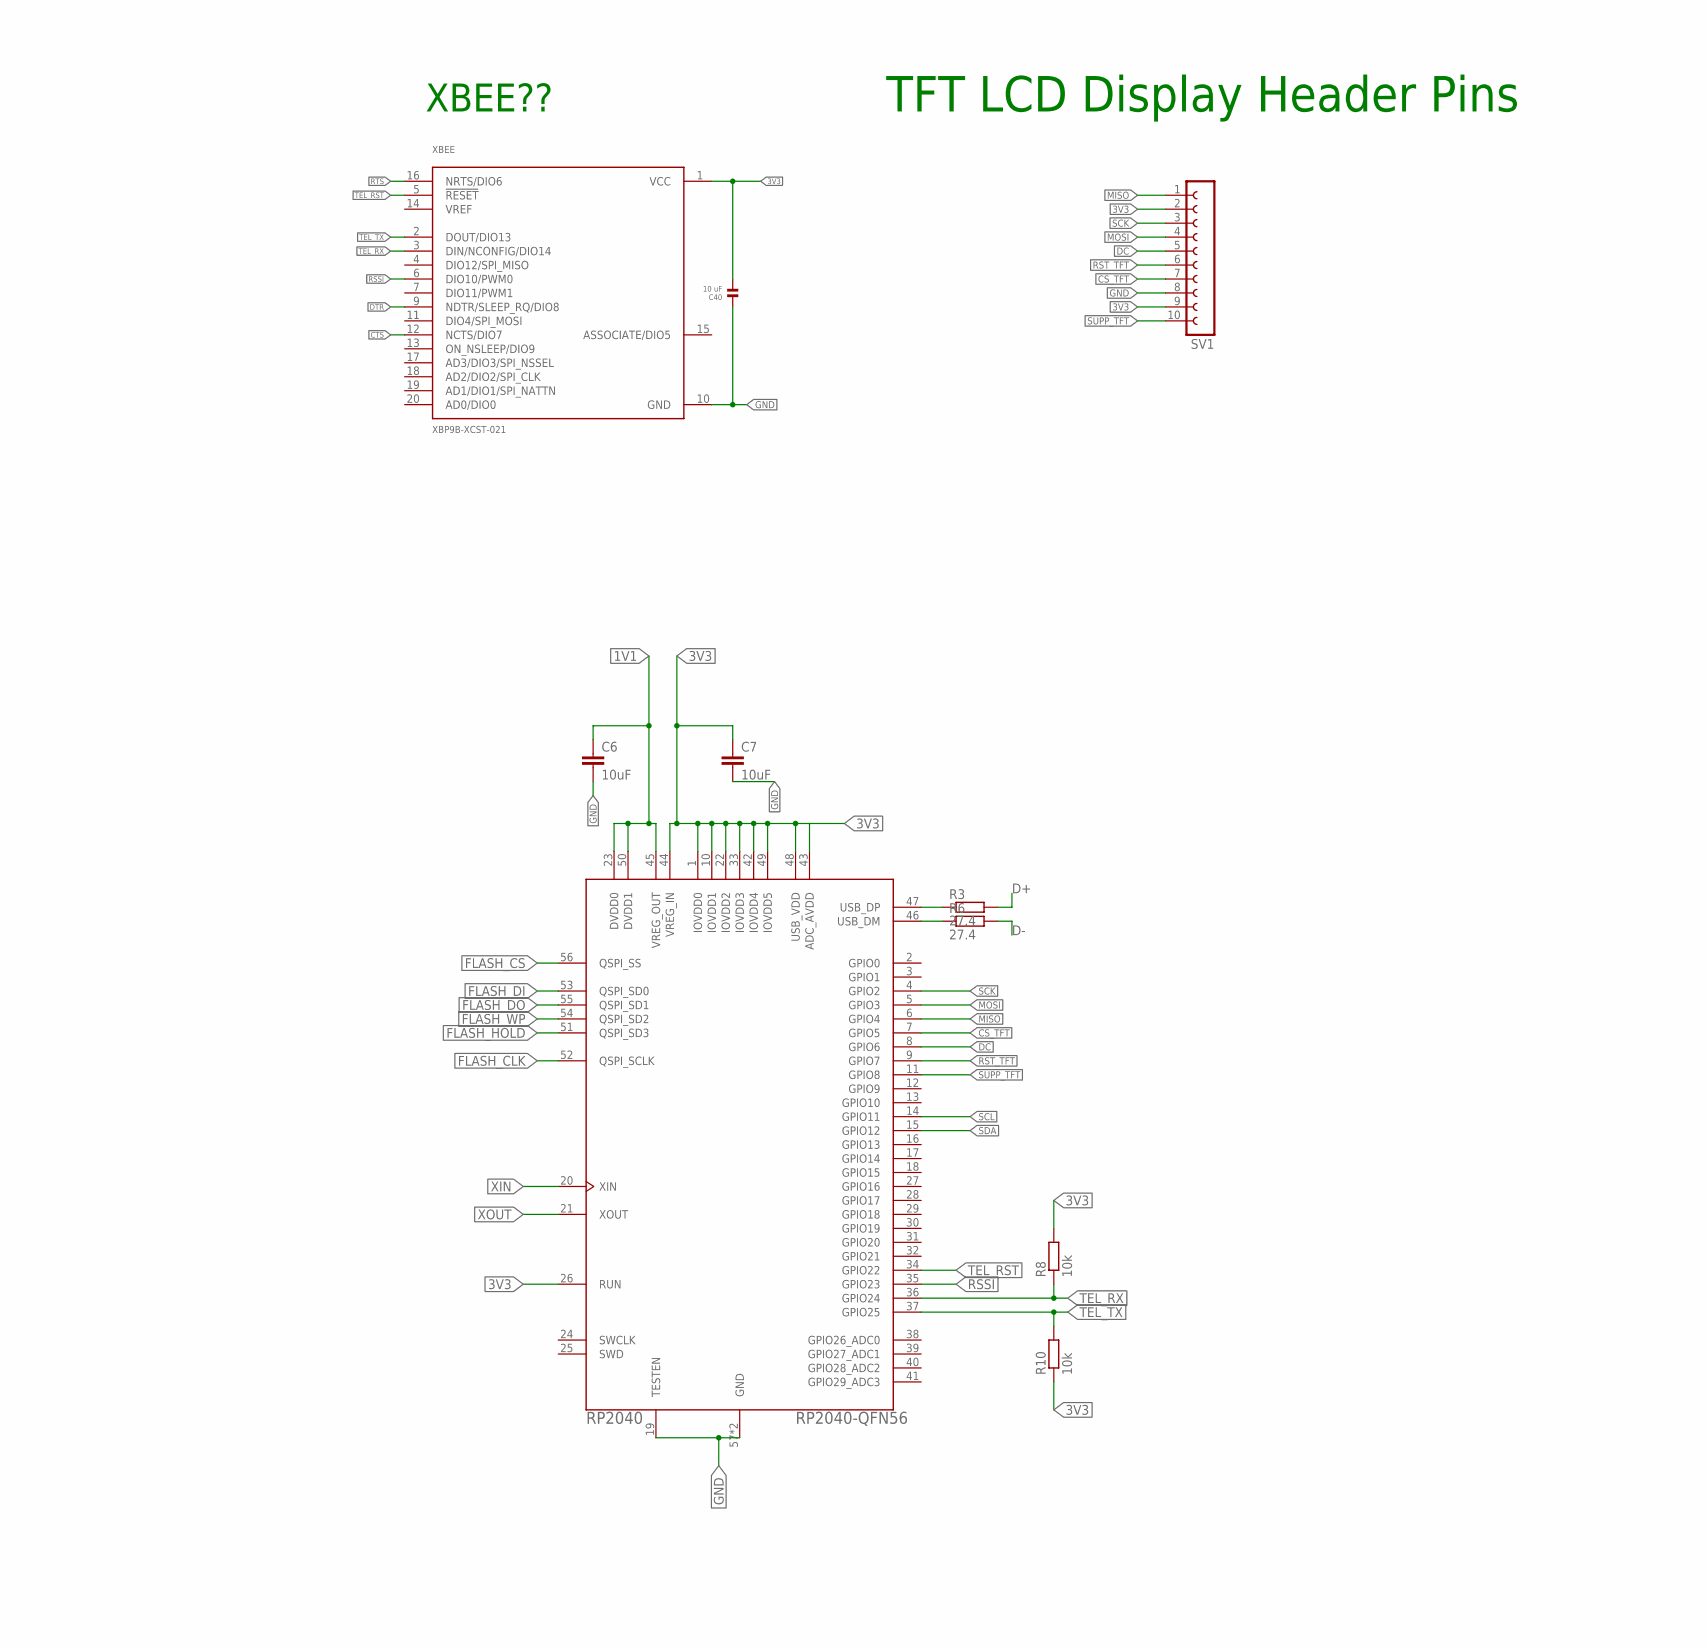
[picture p49: schematic GND_STN.sch, part in row 1, column 2]

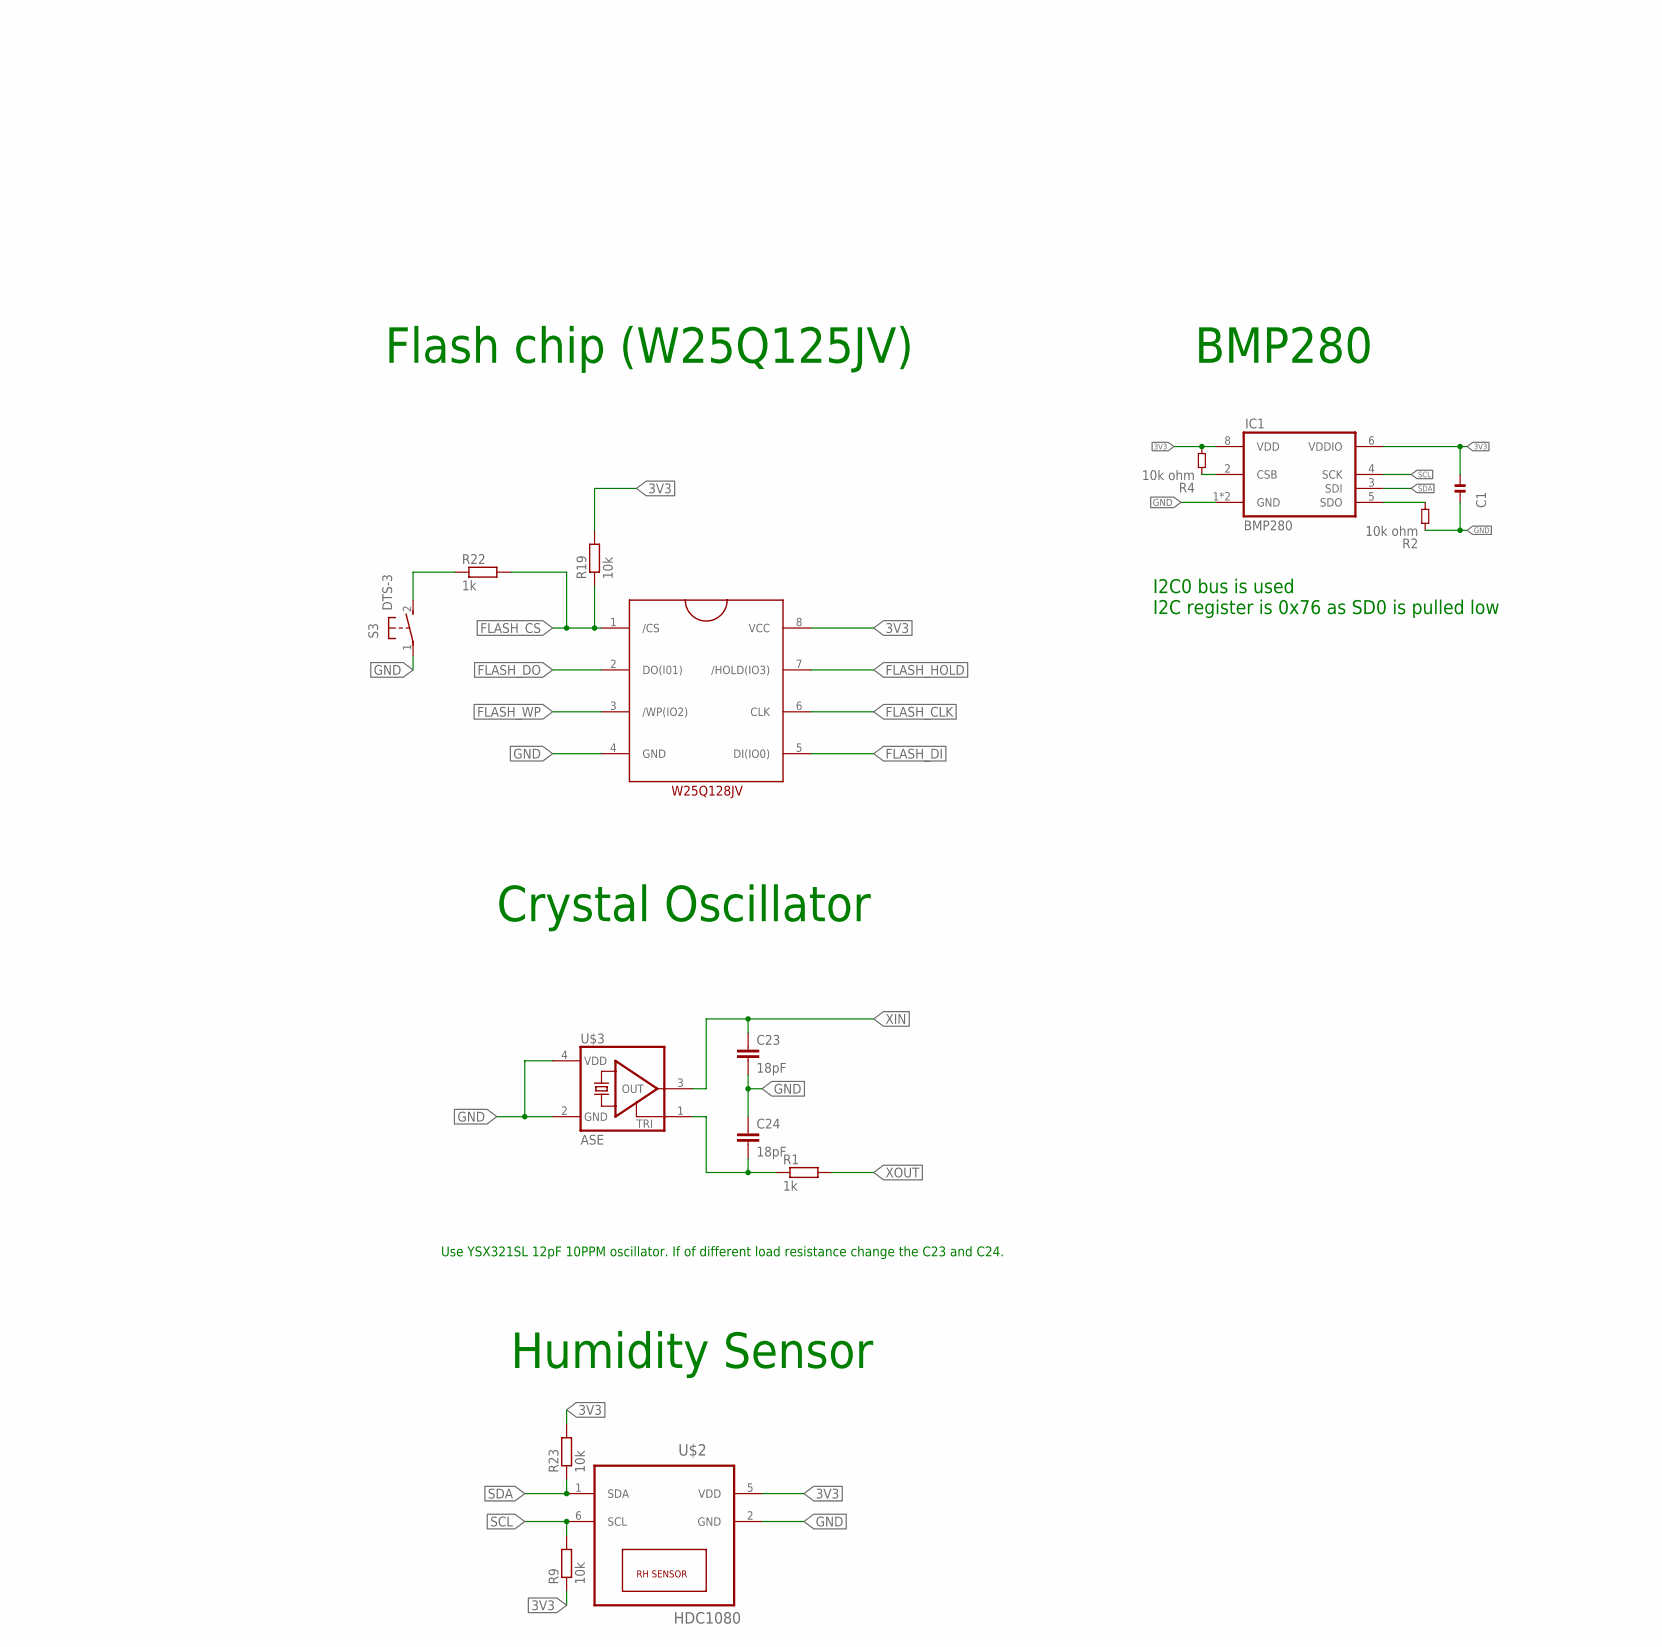
[picture p50: schematic GND_STN.sch, part in row 1, column 3]

Parts:
C1, C40: 10 uF; 0603
C2, C6, C7, C18: 10uF; C0603
C3, C13: 22uF; C0603
C23, C24: 18pF; C0805
D3, D4: SCHOTTKY_MBR0520LT1GDO-219; SODFL3718X115
IC1: BMP280
J2: XT60-M; AMASS_XT60-M
R1: 1k; R0805
R2, R4: 10k ohm; 0603
R3, R6: 27.4; R0603
R5, R7: 5.1k ohm; 0603
R8, R9, R10, R19, R23: 10k; R0603
R22: 1k; R0603
RP2040: RP2040-QFN56; RP2040-QFN-56
S3: DTS-3
SV1: FE10-1; FE10
U1: AMS1117-5.0; SOT229P700X180-4N
U2: AMS1117-3.3; SOT229P700X180-4N
U4: SOIC127P790X216-8NW25Q128JVJSQ; SOIC127P790X216-8N
U$2: HDC1080; TI-S-PWSON-N6
U$3: ASE
X1: USB Type C; USB_C_CUSB31-CFM2AX-01-X
XBEE: XBP9B-XCST-021; DIP2200W51P200L3294H279Q20P

Connections:
1V1: C6.1, RP2040.23 (DVDD0), RP2040.45 (VREG_OUT), RP2040.50 (DVDD1)
3V3: C1.2, C7.1, C13.1, C40.2, IC1.6 (VDDIO), IC1.8 (VDD), R4.2, R8.2, R9.1, R10.1, R19.2, R23.2, RP2040.1 (IOVDD0), RP2040.10 (IOVDD1), RP2040.22 (IOVDD2), RP2040.26 (RUN), RP2040.33 (IOVDD3), RP2040.42 (IOVDD4), RP2040.43 (ADC_AVDD), RP2040.44 (VREG_IN), RP2040.48 (USB_VDD), RP2040.49 (IOVDD5), SV1.2, SV1.9, U2.2 (VOUT), U4.8 (VCC), U$2.5 (VDD), XBEE.1 (VCC)
5V: C2.1, D3.1 (C), D4.1 (C), U2.3 (VIN)
5V_BATT: C3.1, D4.2 (A), U1.2 (VOUT)
5V_USB: D3.2 (A), X1.A4B9 (VBUS), X1.B4A9 (VBUS)
CC3: R5.1, X1.B5 (CC2)
CC4: R7.1, X1.A5 (CC1)
CSB: IC1.2 (CSB), R4.1
CS_TFT: RP2040.7 (GPIO5), SV1.7
CTS: XBEE.12 (NCTS/DIO7)
D+: R3.2, X1.A6 (D+), X1.B6 (D+)
D-: R6.2, X1.A7 (D-), X1.B7 (D-)
DC: RP2040.8 (GPIO6), SV1.5
DTR: XBEE.9 (NDTR/SLEEP_RQ/DIO8)
FLASH_CLK: RP2040.52 (QSPI_SCLK), U4.6 (CLK)
FLASH_CS: R19.1, R22.2, RP2040.56 (QSPI_SS), U4.1 (/CS)
FLASH_DI: RP2040.53 (QSPI_SD0), U4.5 (DI(IO0))
FLASH_DO: RP2040.55 (QSPI_SD1), U4.2 (DO(I01))
FLASH_HOLD: RP2040.51 (QSPI_SD3), U4.7 (/HOLD(IO3))
FLASH_WP: RP2040.54 (QSPI_SD2), U4.3 (/WP(IO2))
GND: C1.1, C2.2, C3.2, C6.2, C7.2, C13.2, C18.2, C23.2, C24.1, C40.1, IC1.1 (GND), IC1.7 (GND), J2.N (NEG), R2.1, R5.2, R7.2, RP2040.19 (TESTEN), RP2040.57 (GND), RP2040.62 (GND), S3.1, SV1.8, U1.1 (GND/ADJ), U2.1 (GND/ADJ), U4.4 (GND), U$2.2 (GND), U$3.2 (GND), U$3.4 (VDD), X1.A1B12 (GND), X1.B1A12 (GND), XBEE.10 (GND)
MISO: RP2040.6 (GPIO4), SV1.1
MOSI: RP2040.5 (GPIO3), SV1.4
unnamed: R22.1, S3.2
unnamed: R3.1, RP2040.47 (USB_DP)
unnamed: R6.1, RP2040.46 (USB_DM)
unnamed: C24.2, R1.1, U$3.1 (TRI)
unnamed: C18.1, J2.P (POS), U1.3 (VIN)
RSSI: RP2040.35 (GPIO23), XBEE.6 (DIO10/PWM0)
RST_TFT: RP2040.9 (GPIO7), SV1.6
RTS: XBEE.16 (NRTS/DIO6)
SCK: RP2040.4 (GPIO2), SV1.3
SCL: IC1.4 (SCK), R9.2, RP2040.14 (GPIO11), U$2.6 (SCL)
SDA: IC1.3 (SDI), R23.1, RP2040.15 (GPIO12), U$2.1 (SDA)
SDO1: IC1.5 (SDO), R2.2
SUPP_TFT: RP2040.11 (GPIO8), SV1.10
TEL_RST: RP2040.34 (GPIO22), XBEE.5 (!RESET)
TEL_RX: R8.1, RP2040.36 (GPIO24), XBEE.3 (DIN/NCONFIG/DIO14)
TEL_TX: R10.2, RP2040.37 (GPIO25), XBEE.2 (DOUT/DIO13)
XIN: C23.1, RP2040.20 (XIN), U$3.3 (OUT)
XOUT: R1.2, RP2040.21 (XOUT)

Notes on the sheet:
Flash chip (W25Q125JV)
Power Supply
Crystal Oscillator
Use YSX321SL 12pF 10PPM oscillator. If of different load resistance change the C23 and C24.
I2C0 bus is used I2C register is 0x76 as SD0 is pulled low
BMP280
Humidity Sensor
TFT LCD Display Header Pins
XBEE??

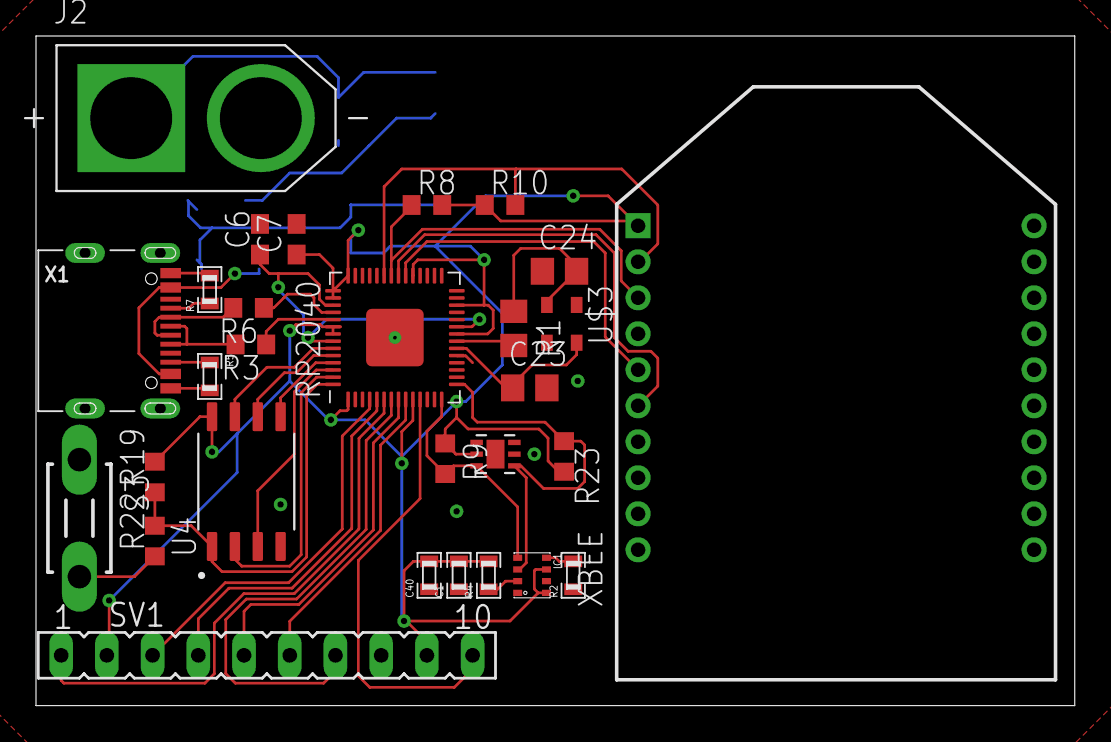
[picture p51: board GND_STN.brd from above]

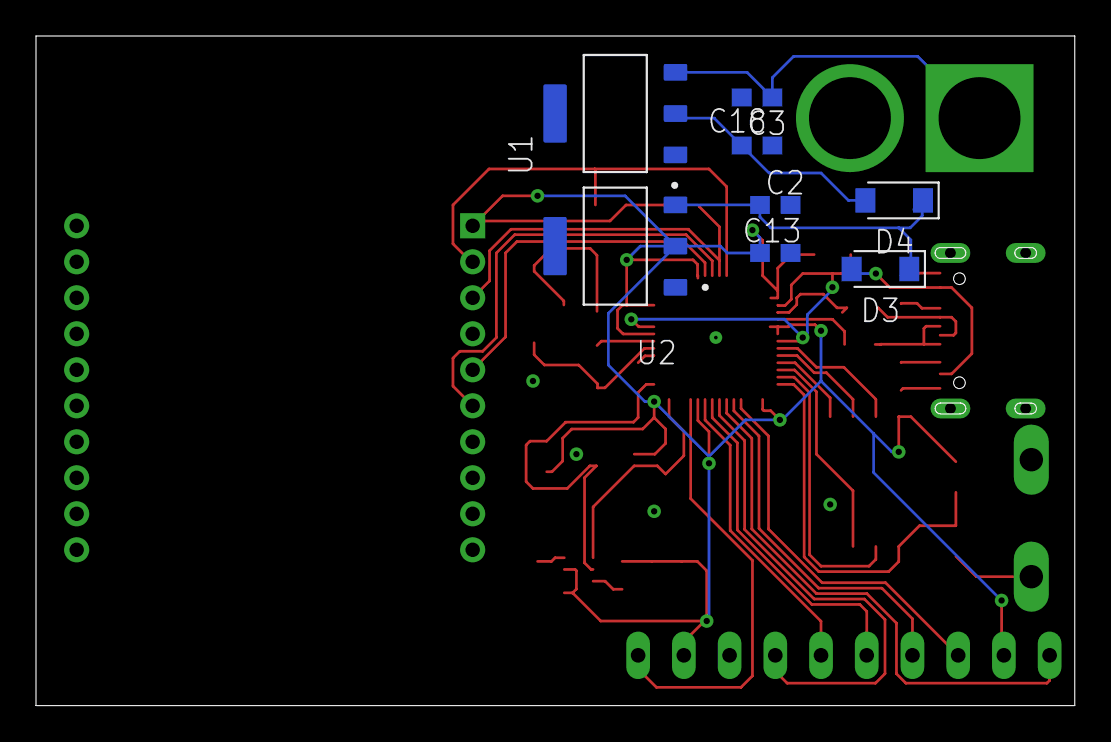
[picture p52: board GND_STN.brd from below]

Board: 2 copper layers, 57.7 x 37.2 mm, 37 parts (8 on the bottom side), 38 nets.
