IITB-Rocket-Team-Avionics/FLYTE/Eagle files/FLYTE 1.0/FLYTE-v1/FLYTE-v1.brd

## EAGLE design Eagle files/FLYTE 1.0/FLYTE-v1/FLYTE-v1.brd (2025-02-02)

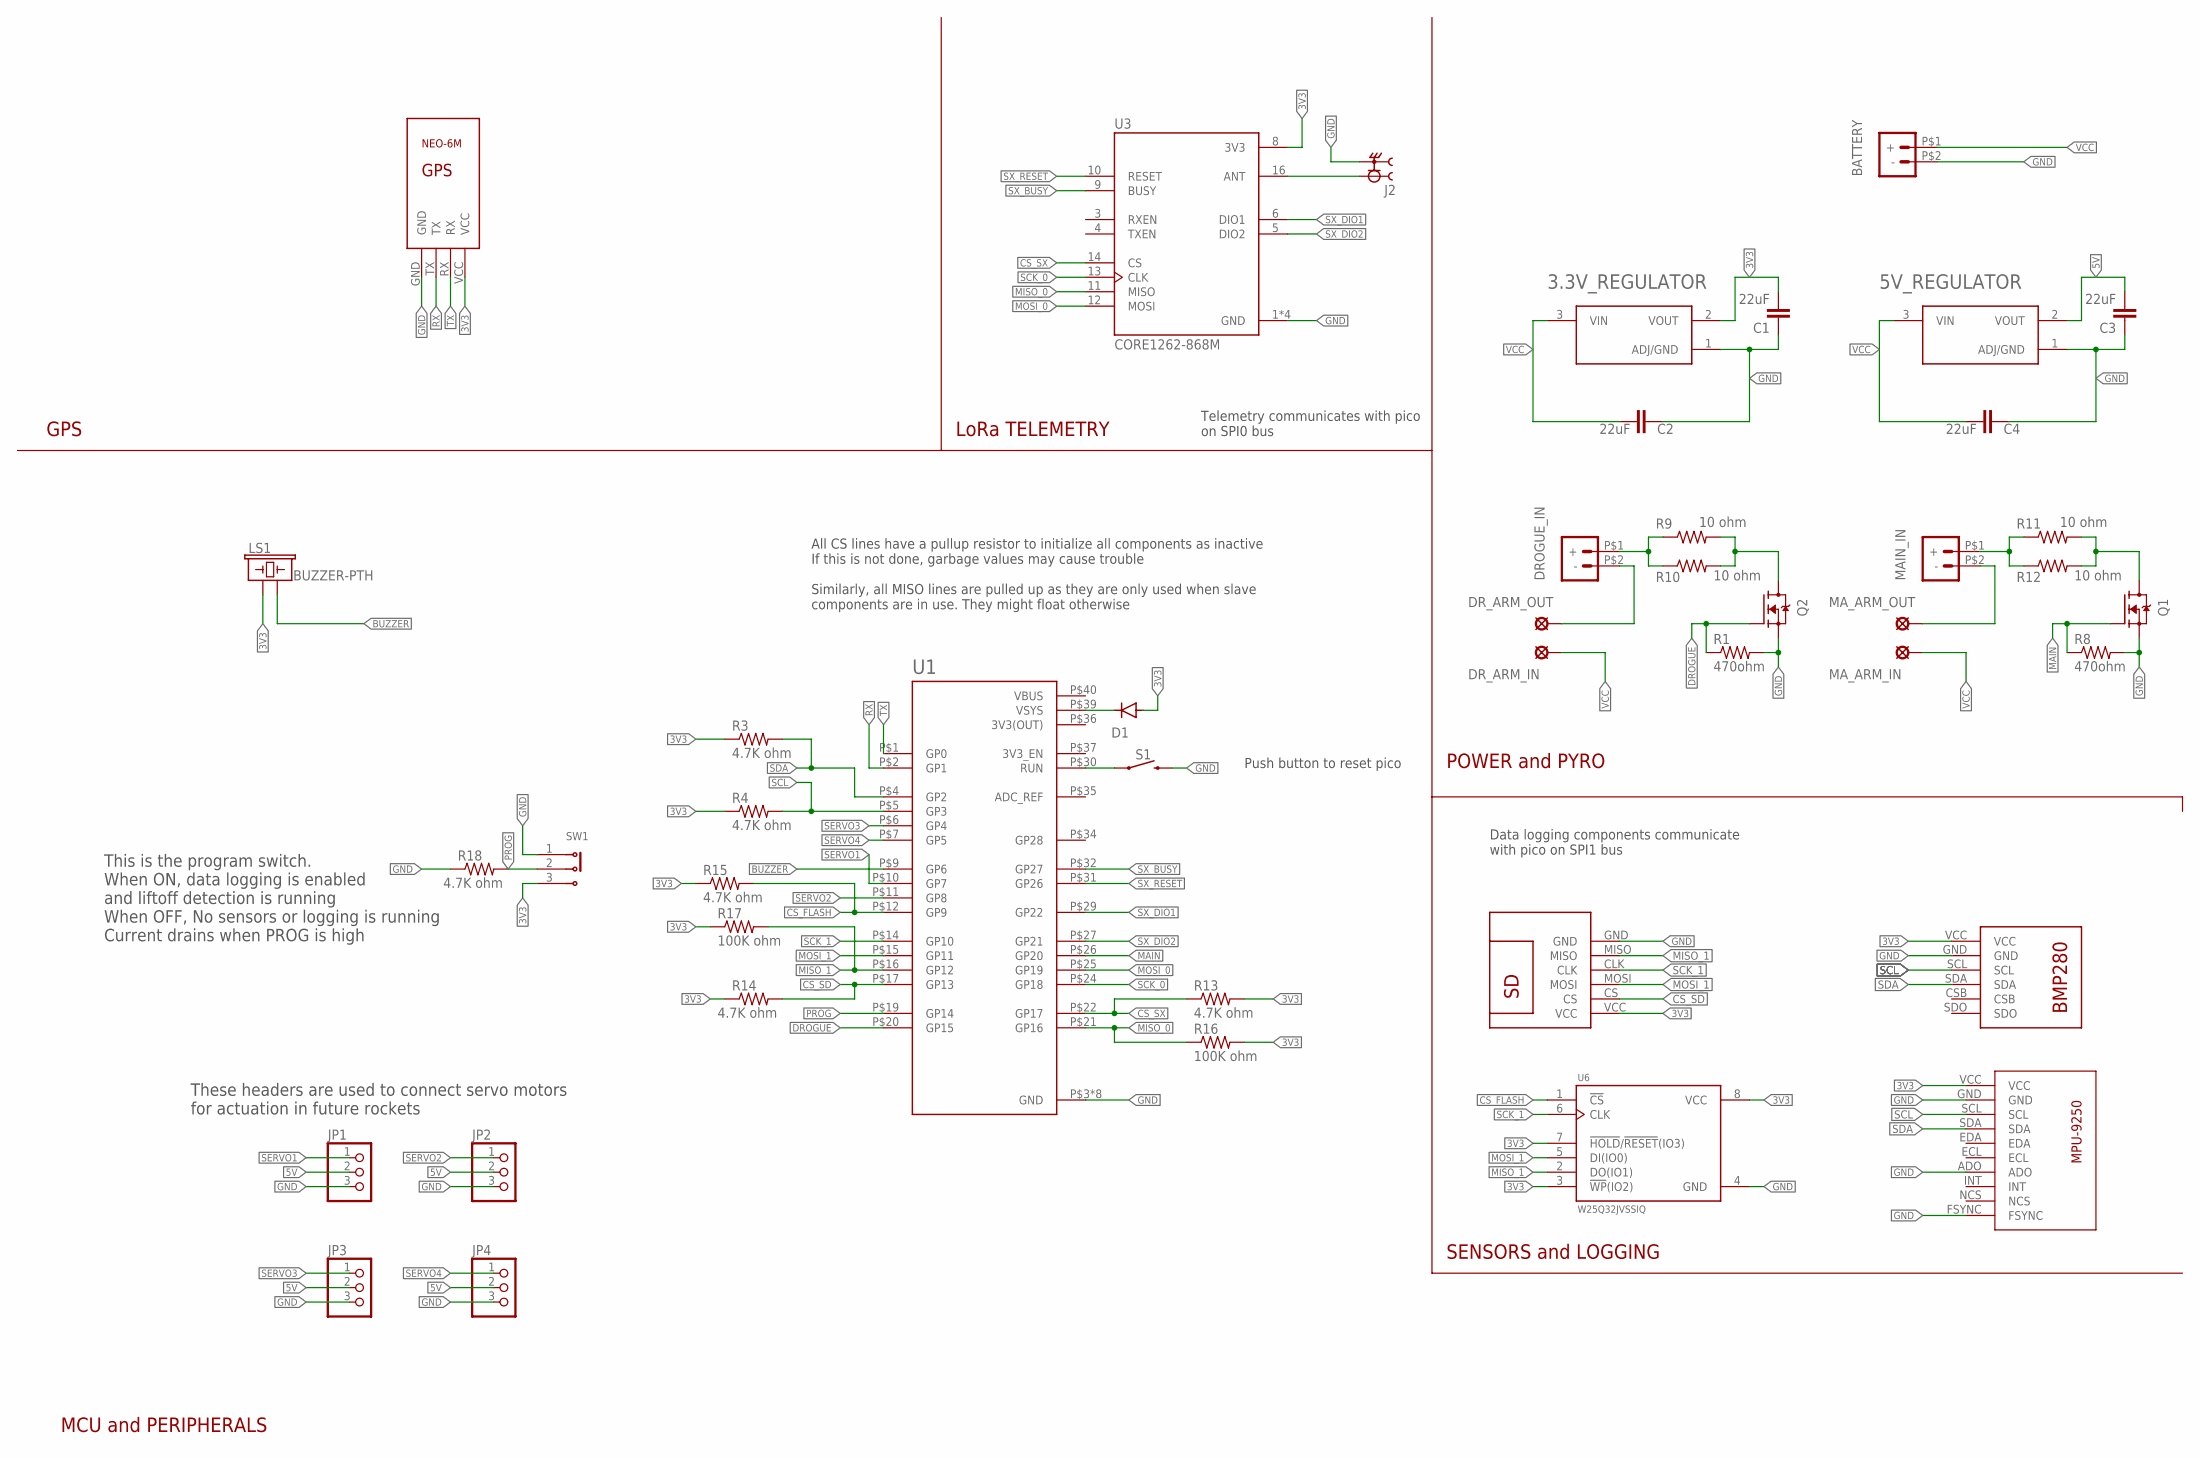
[picture p55: schematic FLYTE-v1.sch]

Parts:
3.3V_REGULATOR, 5V_REGULATOR: AMS1117-3.3; SOT229P700X180-4N
BATTERY: XT30UPB-M
C1, C2, C3, C4: 22uF; 0805
D1: 1N4004; DO41-10
DROGUE_IN: XT30UPB-M
DR_ARM_IN: LSP10
DR_ARM_OUT: LSP10
J2: CONSMA002; LINX_CONSMA002
JP1, JP2, JP3, JP4: PINHD-1X3; 1X03
LS1: BUZZER-PTH; BUZZER-12MM
MAIN_IN: XT30UPB-M
MA_ARM_IN: LSP10
MA_ARM_OUT: LSP10
Q1, Q2: IRF540NPBF; TO254P1054X469X1930-3
R1, R8: 470ohm; R0805
R3, R4, R13, R14, R15, R18: 4.7K ohm; R0805
R9, R10, R11, R12: 10 ohm; 0207/10
R16, R17: 100K ohm; R0805
S1: MOMENTARY-SWITCH-SPST-PTH-6.0MM; TACTILE_SWITCH_PTH_6.0MM
SW1: 1825159-1; SW_1825159-1
U1: RASPBERRY_PICO-NO_DEBUG; PICO-PKG-NO_DEBUG
U3: CORE1262-868M; XCVR_CORE1262-868M
U6: W25Q32JVSSIQ; SOIC127P790X216-8N
U$1: BMP280
U$2: GY-9250
U$3: SDREADER
U$4: NEO-6M

Connections:
3V3: 3.3V_REGULATOR.2 (VOUT), C1.2, D1.A, LS1.+ (1), R3.1, R4.1, R13.2, R14.1, R15.1, R16.2, R17.1, SW1.3, U3.8 (3V3), U6.3 (!WP!(IO2)), U6.7 (!HOLD!/!RESET!(IO3)), U6.8 (VCC), U$1.VCC, U$2.VCC, U$3.VCC, U$4.VCC
3V3(OUT): U1.P$36 (3V3(OUT))
5V: 5V_REGULATOR.2 (VOUT), C3.2, JP1.2, JP2.2, JP3.2, JP4.2
ANT: J2.1, U3.16 (ANT)
BUZZER: LS1.- (2), U1.P$9 (GP6)
CS_FLASH: R15.2, U1.P$12 (GP9), U6.1 (!CS)
CS_SD: R14.2, U1.P$17 (GP13), U$3.CS
CS_SX: R13.1, U1.P$22 (GP17), U3.14 (CS)
DROGUE: Q2.1 (G), R1.1, U1.P$20 (GP15)
GND: 3.3V_REGULATOR.1 (ADJ/GND), 5V_REGULATOR.1 (ADJ/GND), BATTERY.P$2 (-), C1.1, C2.1, C3.1, C4.1, J2.S1 (2), J2.S2 (2), J2.S3 (2), J2.S4 (2), JP1.3, JP2.3, JP3.3, JP4.3, Q1.3 (S), Q2.3 (S), R1.2, R8.2, R18.1, S1.3 (2), SW1.1, U1.P$3 (GND), U1.P$8 (GND), U1.P$13 (GND), U1.P$18 (GND), U1.P$23 (GND), U1.P$28 (GND), U1.P$33 (GND), U1.P$38 (GND), U3.1 (GND), U3.2 (GND), U3.7 (GND), U3.15 (GND), U6.4 (GND), U$1.GND, U$2.ADO, U$2.FSYNC, U$2.GND, U$3.GND, U$4.GND
MAIN: Q1.1 (G), R8.1, U1.P$26 (GP20)
MISO_0: R16.1, U1.P$21 (GP16), U3.11 (MISO)
MISO_1: R17.2, U1.P$16 (GP12), U6.2 (DO(IO1)), U$3.MISO
MOSI_0: U1.P$25 (GP19), U3.12 (MOSI)
MOSI_1: U1.P$15 (GP11), U6.5 (DI(IO0)), U$3.MOSI
unnamed: D1.C, U1.P$39 (VSYS)
unnamed: DROGUE_IN.P$2 (-), DR_ARM_OUT.MP
unnamed: MAIN_IN.P$1 (+), R11.1, R12.1
unnamed: DROGUE_IN.P$1 (+), R9.1, R10.1
unnamed: S1.1, U1.P$30 (RUN)
unnamed: Q2.2 (D), R9.2, R10.2
unnamed: Q1.2 (D), R11.2, R12.2
unnamed: MAIN_IN.P$2 (-), MA_ARM_OUT.MP
PROG: R18.2, SW1.2, U1.P$19 (GP14)
RX: U1.P$2 (GP1), U$4.TX
SCK_0: U1.P$24 (GP18), U3.13 (CLK)
SCK_1: U1.P$14 (GP10), U6.6 (CLK), U$3.CLK
SCL: R4.2, U1.P$5 (GP3), U$1.SCL, U$2.SCL
SDA: R3.2, U1.P$4 (GP2), U$1.SDA, U$2.SDA
SERVO1: JP1.1, U1.P$10 (GP7)
SERVO2: JP2.1, U1.P$11 (GP8)
SERVO3: JP3.1, U1.P$6 (GP4)
SERVO4: JP4.1, U1.P$7 (GP5)
SX_BUSY: U1.P$32 (GP27), U3.9 (BUSY)
SX_DIO1: U1.P$29 (GP22), U3.6 (DIO1)
SX_DIO2: U1.P$27 (GP21), U3.5 (DIO2)
SX_RESET: U1.P$31 (GP26), U3.10 (RESET)
TX: U1.P$1 (GP0), U$4.RX
VBUS: U1.P$40 (VBUS)
VCC: 3.3V_REGULATOR.3 (VIN), 5V_REGULATOR.3 (VIN), BATTERY.P$1 (+), C2.2, C4.2, DR_ARM_IN.MP, MA_ARM_IN.MP

Notes on the sheet:
POWER and PYRO
LoRa TELEMETRY
GPS
SENSORS and LOGGING
This is the program switch. When ON, data logging is enabled and liftoff detection is running When OFF, No sensors or logging is running Current drains when PROG is high
Telemetry communicates with pico on SPI0 bus
Data logging components communicate with pico on SPI1 bus
All CS lines have a pullup resistor to initialize all components as inactive If this is not done, garbage values may cause trouble Similarly, all MISO lines are pulled up as they are only used when slave components are in use. They might float otherwise
Push button to reset pico
These headers are used to connect servo motors for actuation in future rockets
MCU and PERIPHERALS

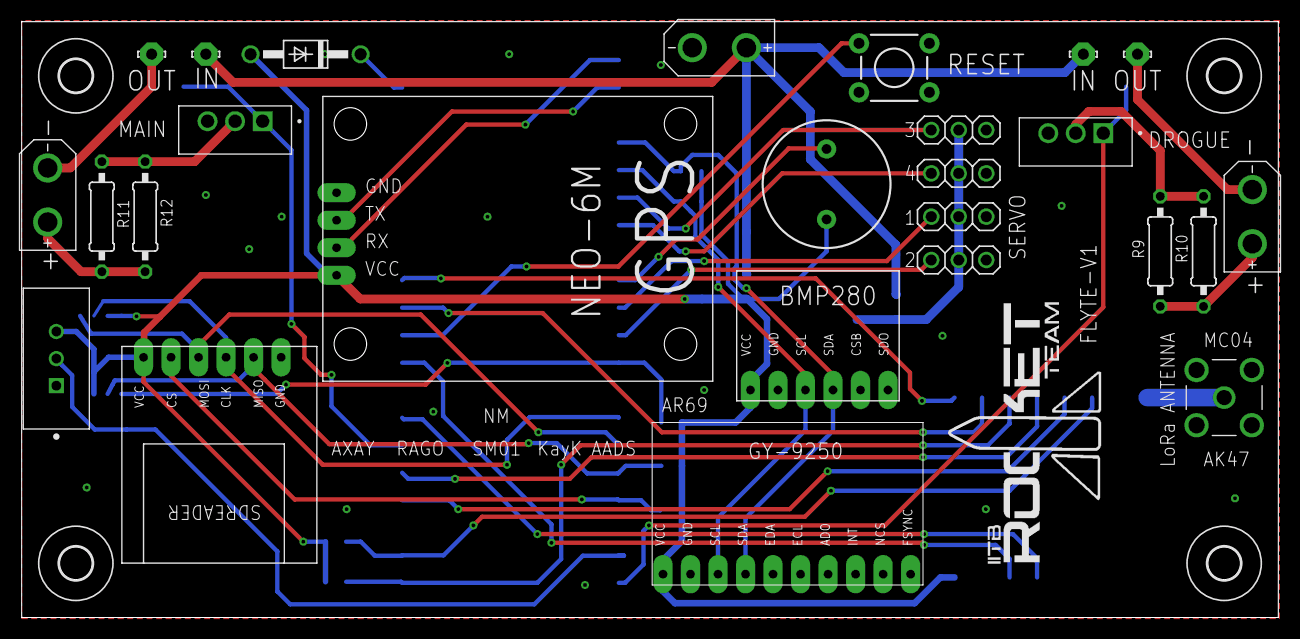
[picture p56: board FLYTE-v1.brd from above]

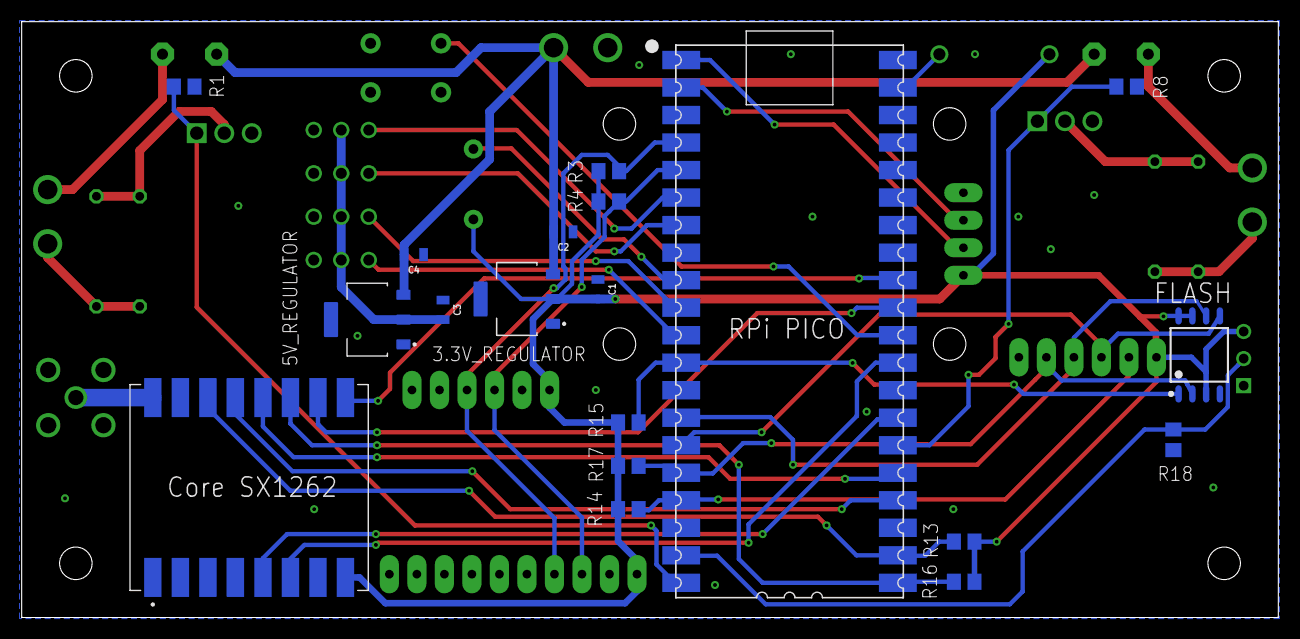
[picture p57: board FLYTE-v1.brd from below]

Board: 2 copper layers, 116.0 x 55.0 mm, 49 parts (19 on the bottom side), 38 nets.

Other parts of the board:
U$5, U$6, U$7, U$8: 3,0
