IITB-Rocket-Team-Avionics/FLYTE/Eagle files/FLYTE 3/FLYTE 3.01/FLYTE 3.01.brd

## EAGLE design Eagle files/FLYTE 3/FLYTE 3.01/FLYTE 3.01.brd (2025-02-02)

Schematic: FLYTE 3.01.sch

Parts:
AC1: KX134-1211; KX1341211
BOOT: DTSM-3
BUZZER: BUZZER; CUI_CMT-8530S-SMT
C1, C4, C35, C38: CAPACITOR.0603; 0603
C2, C3: 24 pF; 0603
C5, C6, C7, C9, C11, C12, C13, C14, C15, C16, C19, C20, C21, C22, C25, C61: 100 nF; 0603
C8, C10, C26, C53, C55, C56, C59, C63, C115: 1 uF; 0603
C17, C29, C30, C31, C50, C51, C101: 0.1 uF; 0603
C18, C41, C43, C45, C47, C99, C100: 10uF; EIA3216-18/A-W
C23, C24: 25 pF; 0603
C27, C32: 10 nF; 0603
C28: 470 pF; 0603
C33, C37: 120 pF; 0603
C34: 47pF; 0603
C36: 1 nF; 0603
C39: 1uF; 0603
C40: 10uF; 0603
C42, C44, C46, C48, C49: 10 uF; EIA3216-18/A-W
C52, C58, C60: 100 uF; 1206
C54: 10 pF; 0603
C57, C62: 4.7 uF; 0603
CHIP_ANT: W3010; XCVR_W3010
D1, D2, D10, D13: RSX501LAM20TR; SODFL4725X105N
D4, D5, D6, D7, D11, D12: LED.0603; 0603.LED
FIN_1, FIN_2, FIN_3, FIN_4: 03-JST-B3B-XH-A; B3B-XH
FLASH: W25Q128JVSIQ; SOIC127P790X216-8N
GNSS: TESEO-LIV3F; SON110P970X1010X230-18N
H2, H3, H4: MOUNT-PAD-ROUND3.0; 3,0-PAD
IC1: BMP280
IC2: MPXV5100DP
IC3: AS179-92LF; SOT65P220X100-6N
IC6: MAX8574EUT+T; SOT95P280X145-6N
IC9: MCP73844-840I_MS; SOP65P490X110-8N
J1, J2, J3, J4, J5, J9, J13: 282834-2; TE_282834-2
J6: 503182-1852; 5031821852
J7: XT60-M; AMASS_XT60-M
J8: SMA_CONNECTOR; LPRS_SMA_CONNECTOR
J10, J11: B2B-XH-A(LF)(SN); JST_B2B-XH-A(LF)(SN)
L1: 33 uH; INDP125125X600N
L6: 27 nH; 0603
L7: 5.6 nH; 0603
L8: 22 uH; 0603
LED: LED.0603; 0603.LED
LNA: BGA725L6; AMP_BGA725L6E6327FTSA1
MOTOR: 03-JST-B3B-XH-A; B3B-XH
Q1: SI7625DN-T1-GE3; SIS862DNT1GE3
Q2, Q3, Q4, Q5: MOSFET-PWIDE; SOT23-WIDE
R0, R9, R10, R13, R15, R20, R21, R26, R36, R43, R70, R72, R73, R80, R81, R82, R83, R84, R85, R93, R94, R95, R96, R101: 10k ohm; 0603
R1, R5: 1k ohm; 0603
R2, R19, R58: 60 ohm; 0603
R3, R4: 27.4 ohm; 0603
R6, R7: 5.1k ohm; 0603
R8: 100 ohm; 0603
R11, R14: 10 kohm; 0603
R12, R18, R22, R28, R31, R33, R53, R55, R57, R61, R65, R66, R68, R71, R75, R77, R79, R87, R89, R91: 100k ohm; 0603
R16: 365k ohm; 0603
R17: 57.6k ohm; 0603
R23, R27, R30, R32, R35: 301k ohm; 0603
R24, R63: 0.1 ohm; 0603
R25, R37, R38, R39, R40, R41, R42, R44, R45, R46, R47, R48, R49, R50, R51, R52: 0.13 ohm; 0603
R29, R59: 315 ohm; 0603
R34, R64: 158 ohm; 0603
R54, R56, R60, R62, R67, R69, R74, R76, R78, R86, R88, R90, R92: 140k ohm; 0603
R97: RESISTOR.0603; 0603
R98, R99, R100: 0 ohm; 0603
R102: RESISTOR.0805; 0805
RP2040: RP2040-QFN56; RP2040-QFN-56
SAW: SAW_FILTER; FIL_AFS14A04-1575.42-T3
U1: BNO055; LGA28R50P4X10_380X520X100
U2, U3, U5, U7: CJ3400; SOT91P240X120-3N
U4, U10: LM1117-3.3; SOT230
U6, U9, U15, U16: ADS1115IDGSR; SOP50P490X110-10N
U8, U11, U12, U13, U14: MIC29302WU-TR; TO-263-5_MCH
U17: CP2102; QFN50P500X500X100-29N
U$1, U$3: SN74LVC1G04DBVR; SOT23-5
VR1: XL6009; DPAK170P1435X465-6N
X6: USB Type C; USB_C_CUSB31-CFM2AX-01-X
XBEE: XBP9B-XCST-021; DIP2200W51P200L3294H279Q20P
XTAL: ASE
Y1: FC-135_32.7680KA-A0; XTAL_FC-135_32.7680KA-A0

Connections:
1V1: C6.2, C7.2, C8.2, RP2040.23 (DVDD0), RP2040.45 (VREG_OUT), RP2040.50 (DVDD1)
3V3: C4.2, C34.2, C39.2, C40.2, J1.1, Q3.2 (S), R93.2, R94.2, U4.2 (VOUT), U4.4 (VOUT_2), XBEE.1 (VCC)
3V3_OP: AC1.1 (SDO/ADDR), AC1.3 (IO_VDD), AC1.7 (VDD), AC1.10 (NCS), C5.1, C9.2, C10.2, C11.2, C12.2, C13.2, C14.2, C15.2, C16.2, C19.2, C20.1, C21.1, C25.1, C30.2, C31.2, C32.2, C61.2, C115.2, FLASH.8 (VCC), IC1.6 (VDDIO), IC1.8 (VDD), J6.4 (VDD), L6.1, Q3.3 (D), R0.2, R10.2, R13.2, R14.1, R43.1, R72.2, R73.2, R80.2, R81.2, R82.2, R83.2, R84.2, R85.2, RP2040.1 (IOVDD0), RP2040.10 (IOVDD1), RP2040.22 (IOVDD2), RP2040.26 (RUN), RP2040.33 (IOVDD3), RP2040.42 (IOVDD4), RP2040.43 (ADC_AVDD), RP2040.44 (VREG_IN), RP2040.48 (USB_VDD), RP2040.49 (IOVDD5), U1.3 (VDD), U1.4 (NBOOT_LOAD_PIN), U1.28 (VDDIO), U16.7 (AIN3), U$1.1 (NC), U$1.5 (VCC)
3V3_SET: C62.1, J1.2, Q3.1 (G), R101.2, U17.6 (VDD)
5V: C17.1, C26.1, C27.1, C29.1, C38.2, C50.1, C51.1, IC2.2 (VS), MOTOR.P$2, U6.8 (VDD), U9.1 (ADDR), U9.8 (VDD), U10.2 (VOUT), U10.4 (VOUT_2), U15.8 (VDD), U16.8 (VDD)
BC: J9.2, Q4.1 (G), R70.2, U$3.2 (A)
BUZZER: BUZZER.P, RP2040.17 (GPIO14)
CAM: D12.P$1 (1), RP2040.11 (GPIO8), U14.1 (EN)
CC1: R7.1, X6.A5 (CC1)
CC2: R6.1, X6.B5 (CC2)
CSB: IC1.2 (CSB), R10.1
CS_SD: J6.2 (CD/DAT3), R43.2, RP2040.3 (GPIO1)
CTRL: D6.P$1 (1), RP2040.12 (GPIO9), U8.1 (EN), U11.1 (EN), U12.1 (EN), U13.1 (EN)
CTS: R98.1, XBEE.12 (NCTS/DIO7)
D1: FIN_1.P$2, R25.2, R37.2, R38.2, R39.2, R55.1
D2: FIN_2.P$2, R45.2, R46.2, R47.2, R48.2, R68.1
D3: FIN_3.P$2, R40.2, R41.2, R42.2, R44.2, R77.1
D4: FIN_4.P$2, R49.2, R50.2, R51.2, R52.2, R89.1
D+: R3.2, R102.1, X6.A6 (D+), X6.B6 (D+)
D+1: R102.2, U17.4 (D+)
D-: R4.2, U17.5 (D-), X6.A7 (D-), X6.B7 (D-)
DROGUE: R15.2, RP2040.32 (GPIO21), U5.1 (G)
DTR: R100.1, XBEE.9 (NDTR/SLEEP_RQ/DIO8)
FB: C54.1, IC6.1 (FB), R18.1, R20.1
FIN_1: FIN_1.P$3, RP2040.6 (GPIO4)
FIN_2: FIN_2.P$3, RP2040.7 (GPIO5)
FIN_3: FIN_3.P$3, RP2040.8 (GPIO6)
FIN_4: FIN_4.P$3, RP2040.9 (GPIO7)
GND: AC1.4 (TRIG), AC1.8 (GND_1), AC1.9 (GND_2), BOOT.1, C1.1, C2.1, C3.1, C4.1, C5.2, C6.1, C7.1, C8.1, C9.1, C10.1, C11.1, C12.1, C13.1, C14.1, C15.1, C16.1, C17.2, C18.-, C19.1, C20.2, C21.2, C22.1, C23.2, C24.2, C25.2, C26.2, C27.2, C28.1, C29.2, C30.1, C31.1, C32.1, C34.1, C35.1, C36.1, C38.1, C39.1, C40.1, C41.-, C42.-, C43.-, C44.-, C45.-, C46.-, C47.-, C48.-, C49.-, C50.2, C51.2, C52.1, C53.1, C55.2, C56.2, C57.2, C58.1, C59.1, C60.1, C61.1, C62.2, C63.2, C99.-, C100.-, C101.1, C115.1, CHIP_ANT.2 (GND), CHIP_ANT.3 (GND), FIN_1.P$1, FIN_2.P$1, FIN_3.P$1, FIN_4.P$1, FLASH.4 (GND), GNSS.1 (GND), GNSS.10 (GND_RF_1), GNSS.12 (GND_RF_2), H2.B3,0, H3.B3,0, H4.B3,0, IC1.1 (GND), IC1.7 (GND), IC2.3 (GND), IC3.2 (GND), IC6.2 (GND), IC9.6 (VSS), J6.6 (VSS), J6.9 (VSS), J6.10 (VSS), J6.11 (VSS), J6.12 (VSS), J6.13 (VSS), J6.14 (VSS), J6.15 (VSS), J7.N (NEG), J8.G1 (2), J8.G2 (2), J8.G3 (2), J8.G4 (2), J9.1, J10.1, J11.1, LNA.1 (GND), LNA.4 (GNDRF), MOTOR.P$1, R2.2, R6.2, R7.2, R8.2, R9.1, R11.1, R12.2, R15.1, R17.2, R19.2, R20.2, R21.1, R22.2, R26.1, R28.2, R29.1, R31.2, R33.2, R34.1, R36.1, R54.2, R56.2, R58.2, R59.2, R60.2, R62.2, R67.2, R69.2, R74.2, R76.2, R78.2, R86.2, R88.2, R90.2, R92.2, R95.1, R97.2, R101.1, RP2040.19 (TESTEN), RP2040.57 (GND), RP2040.58 (GND), RP2040.59 (GND), RP2040.60 (GND), RP2040.61 (GND), RP2040.62 (GND), RP2040.63 (GND), RP2040.64 (GND), RP2040.65 (GND), RP2040.66 (GND), SAW.B (GND), SAW.D (GND), SAW.E (GND), U1.2 (GND), U1.5 (PS1), U1.6 (PS0), U1.10 (PIN10), U1.15 (PIN15), U1.16 (PIN16), U1.18 (COM2), U1.25 (GNDIO), U2.2 (S), U3.2 (S), U4.1 (ADJ/GND), U5.2 (S), U6.1 (ADDR), U6.3 (GND), U7.2 (S), U8.3 (GND), U8.6, U9.3 (GND), U10.1 (ADJ/GND), U11.3 (GND), U11.6, U12.3 (GND), U12.6, U13.3 (GND), U13.6, U14.3 (GND), U14.6, U15.3 (GND), U16.3 (GND), U17.3 (GND), U17.29 (GND), U17.P$1 (GND), U$1.3 (GND), U$3.3 (GND), VR1.1 (GND), X6.A1B12 (GND), X6.B1A12 (GND), XBEE.10 (GND), XTAL.2 (GND), XTAL.4 (VDD)
GPS_RX: GNSS.3 (RX), R81.1, RP2040.15 (GPIO12)
GPS_TX: GNSS.2 (TX), R82.1, RP2040.16 (GPIO13)
IGN1: R36.2, RP2040.29 (GPIO18), U3.1 (G)
IGN2: R26.2, RP2040.30 (GPIO19), U2.1 (G)
LED: LED.P$1 (1), RP2040.18 (GPIO15)
MAIN: R21.2, RP2040.31 (GPIO20), U7.1 (G)
MISO: J6.7 (DAT0), R84.1, RP2040.2 (GPIO0)
MOS: D4.P$1 (1), D13.2 (A), J13.2, Q1.5 (D_1), Q1.6 (D_2), Q1.7 (D_3), Q1.8 (D_4), Q1.9 (D_5), Q1.10 (D_6), Q1.11 (D_7)
MOSI: J6.3 (CMD), R85.1, RP2040.5 (GPIO3)
unnamed: D1.2 (A), IC6.4 (LX), L8.2
unnamed: LED.P$2 (2), R2.1
unnamed: C3.2, R5.1, XTAL.1 (TRI)
unnamed: C33.1, GNSS.11 (RF_IN)
unnamed: R12.1, R27.2, U8.5 (ADJ)
unnamed: BUZZER.N, R8.1
unnamed: D12.P$2 (2), R19.1
unnamed: J6.1 (DATA2), R13.1
unnamed: GNSS.6 (VBATT), GNSS.7 (VCC_IO), GNSS.8 (VCC), L6.2
unnamed: C22.2, U1.9 (CAP)
unnamed: R11.2, U1.17 (COM3)
unnamed: J6.8 (DAT1), R72.1
unnamed: R28.1, R30.2, U11.5 (ADJ)
unnamed: R31.1, R32.2, U12.5 (ADJ)
unnamed: R14.2, U1.11 (NRESET)
unnamed: R22.1, R23.2, U14.5 (ADJ)
unnamed: R33.1, R35.2, U13.5 (ADJ)
unnamed: D10.2 (A), L1.1, VR1.3 (SW), VR1.6 (SW)
unnamed: R16.2, R17.1, VR1.5 (FB)
unnamed: R55.2, R56.1, U6.5 (AIN1)
unnamed: R53.2, R54.1, U6.4 (AIN0)
unnamed: L7.1, LNA.5 (AI)
unnamed: C37.1, L7.2
unnamed: C33.2, SAW.A (OUT)
unnamed: LNA.3 (AO), SAW.C (IN)
unnamed: C37.2, IC3.5 (J1)
unnamed: CHIP_ANT.1 (FEEDING), IC3.1 (J3)
unnamed: IC3.3 (J2), J8.1
unnamed: R57.2, R60.1, U6.6 (AIN2)
unnamed: R61.2, R62.1, U6.7 (AIN3)
unnamed: R66.2, R67.1, U9.4 (AIN0)
unnamed: R68.2, R69.1, U9.5 (AIN1)
unnamed: R71.2, R74.1, U9.6 (AIN2)
unnamed: R75.2, R76.1, U15.4 (AIN0)
unnamed: R77.2, R78.1, U15.5 (AIN1)
unnamed: R79.2, R86.1, U15.6 (AIN2)
unnamed: R87.2, R88.1, U16.4 (AIN0)
unnamed: R89.2, R90.1, U16.5 (AIN1)
unnamed: R91.2, R92.1, U16.6 (AIN2)
unnamed: R96.2, U17.9 (!RST)
unnamed: R97.1, U17.11 (!SUSPEND)
unnamed: R98.2, U17.23 (CTS)
unnamed: R99.2, U17.24 (RTS)
unnamed: IC9.1 (SENSE), Q2.2 (S), R24.1, R63.2
unnamed: R100.2, U17.28 (DTR)
unnamed: C57.1, IC6.5 (SW), L8.1
unnamed: C54.2, C55.1, D1.1 (K), Q1.4 (G), R18.2
unnamed: D4.P$2 (2), R29.2
unnamed: D5.P$2 (2), R34.2
unnamed: D6.P$2 (2), R58.1
unnamed: D7.P$2 (2), R59.1
unnamed: D11.P$2 (2), R64.1
unnamed: IC9.3 (STAT1), R64.2
unnamed: IC9.4 (EN), R65.1
unnamed: IC9.8 (DRV), Q2.1 (G)
unnamed: C101.2, IC9.5 (TIMER)
unnamed: Q5.1 (G), U$3.4 (Y)
N_S: IC3.6 (V2), U$1.4 (Y)
PYRO_DROGUE: J3.2, R71.1, U5.3 (D)
PYRO_IGN1: J4.2, R79.1, U3.3 (D)
PYRO_IGN2: J5.2, R91.1, U2.3 (D)
PYRO_MAIN: J2.2, R57.1, U7.3 (D)
QSPI_SCLK: FLASH.6 (CLK), RP2040.52 (QSPI_SCLK)
QSPI_SD0: FLASH.5 (DI(IO0)), RP2040.53 (QSPI_SD0)
QSPI_SD1: FLASH.2 (DO(IO1)), RP2040.55 (QSPI_SD1)
QSPI_SD2: FLASH.3 (/WP(IO2)), RP2040.54 (QSPI_SD2)
QSPI_SD3: FLASH.7 (/HOLD/RESET(IO3)), RP2040.51 (QSPI_SD3)
QSPI_SS: FLASH.1 (/CS), R0.1, R1.2, RP2040.56 (QSPI_SS)
RSSI: RP2040.35 (GPIO23), XBEE.6 (DIO10/PWM0)
RTS: R99.1, XBEE.16 (NRTS/DIO6)
S: IC3.4 (V1), RP2040.27 (GPIO16), U$1.2 (A)
SCK: J6.5 (CLK), R83.1, RP2040.4 (GPIO2)
SCL: AC1.12 (SCLK/SCL), IC1.4 (SCK), R73.1, RP2040.14 (GPIO11), U1.19 (COM1), U6.10 (SCL), U9.10 (SCL), U15.1 (ADDR), U15.10 (SCL), U16.10 (SCL)
SDA: AC1.2 (SDI/SDA), IC1.3 (SDI), R80.1, RP2040.13 (GPIO10), U1.20 (COM0), U6.9 (SDA), U9.9 (SDA), U15.9 (SDA), U16.1 (ADDR), U16.9 (SDA)
SDO: IC1.5 (SDO), R9.2
TEL_RST: RP2040.34 (GPIO22), XBEE.5 (!RESET)
TEL_RX: R93.1, RP2040.36 (GPIO24), U17.26 (TXD), XBEE.3 (DIN/NCONFIG/DIO14)
TEL_TX: R94.1, RP2040.37 (GPIO25), U17.25 (RXD), XBEE.2 (DOUT/DIO13)
USB+: C56.1, IC6.3 (!SHDN), IC6.6 (VCC), Q4.2 (S), Q5.2 (S), R70.1, U$3.1 (NC), U$3.5 (VCC), X6.A4B9 (VBUS), X6.B4A9 (VBUS)
USB_BOOT: BOOT.2, R1.1
USB_BST: C58.2, C59.2, C60.2, C99.+, D10.1 (K), D11.P$1 (1), IC9.2 (VDD), R16.1, R24.2, R63.1, R65.2
USB_CHG: C52.2, C53.2, L1.2, Q4.3 (D), R95.2, VR1.2 (EN), VR1.4 (VIN)
USB_DM: R4.1, RP2040.46 (USB_DM)
USB_DP: R3.1, RP2040.47 (USB_DP)
VBUS: C63.1, D2.2 (A), D5.P$1 (1), Q5.3 (D), R96.1, U17.7 (REGIN), U17.8 (VBUS)
VCC: C1.2, C18.+, C35.2, D2.1 (K), D13.1 (K), U4.3 (VIN), U10.3 (VIN), U14.2 (IN)
VCC_PYRO: D7.P$1 (1), J2.1, J3.1, J4.1, J5.1, J13.1
VCC_RF: C36.2, GNSS.14 (VCC_RF), LNA.2 (VCC), LNA.6 (PON)
VOLT_DP: C28.2, IC2.4 (VOUT), U9.7 (AIN3)
VOLT_MOTOR: MOTOR.P$3, U15.7 (AIN3)
V_CAM: C49.+, J10.2, J11.2, R23.1, U14.4 (OUT)
V_FIN_1: C42.+, R25.1, R27.1, R37.1, R38.1, R39.1, R53.1, U8.4 (OUT)
V_FIN_2: C44.+, R30.1, R45.1, R46.1, R47.1, R48.1, R66.1, U11.4 (OUT)
V_FIN_3: C46.+, R32.1, R40.1, R41.1, R42.1, R44.1, R75.1, U12.4 (OUT)
V_FIN_4: C48.+, R35.1, R49.1, R50.1, R51.1, R52.1, R87.1, U13.4 (OUT)
XIN: C2.2, RP2040.20 (XIN), XTAL.3 (OUT)
XIN32: C23.1, U1.27 (XIN32), Y1.1
XOUT: R5.2, RP2040.21 (XOUT)
XOUT32: C24.1, U1.26 (XOUT32), Y1.2
XT60+: C41.+, C43.+, C45.+, C47.+, C100.+, IC9.7 (VBAT), J7.P (POS), Q1.1 (S_1), Q1.2 (S_2), Q1.3 (S_3), Q2.3 (D), R61.1, U8.2 (IN), U11.2 (IN), U12.2 (IN), U13.2 (IN)

Notes on the sheet:
FLASH
USB
RP2040
CRYSTAL OSCILLATOR
VBUS : Power from USB D+ : Data line 1 D- : Data line 2 CC1 & CC2 : Not sure what they are for but both must be pulled to GND using 5.1k ohm resistors when using Type-C USB SHLD : Outer covering of female USB connector. Should be grounded GND : Ground Try to route D+ and D- so that the differential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
Power C9-C16 : Decoupling capacitors for RP2040. Must be placed close to the power pins. C8 must be close to Pin 45, C10 must be close to Pin 44, rest can be jumbled around as you may like. There is one decoupling capacitor less than number of power pins. Not sure why, that's just how it is in the 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
Power C5 - Decoupling capacitor for flash. Must pe placed close to the flash. Boot When CS is pulled LOW on startup by pressing the button, the flash boots up as a mass storage device (like an SD Card). This is similar to plugging in a USB cable into a Pico while holding the BOOTSEL button. As a pr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
Purchase Links LED : https://evelta.com/green-led-smd-0603-package/ Buzzer : https://www.sunrom.com/p/electromagnetic-passive-buzzer-3-5v-smd-pcb-mount-mlt-8530
Crystal oscillators need a load capacitance to osciallte at the right frequency. This particular chip needs 12 pF. So, 2 capacitors of 22 pF each are placed to give an equivalent load capacitance of 11 pF. 24 pF capacitors were not available, but these get the job done. 1k ohm resistor to ensure th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
TESEO-LIV3F : GNSS Chip TX & RX : For UART communication SCL & SDA : For I2C communication PPS : Time pulse from GNSS VCC_RF : Power output from chip to active antenna C20 & C22 : Blocks DC voltage C18 & C21 : Decoupling capacitors GNSS_SWITCH : Used to switch between 3 antennae V1 : 0, V2 : 0 - RF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
GNSS
Telemetry communicates with pico on SPI0 bus

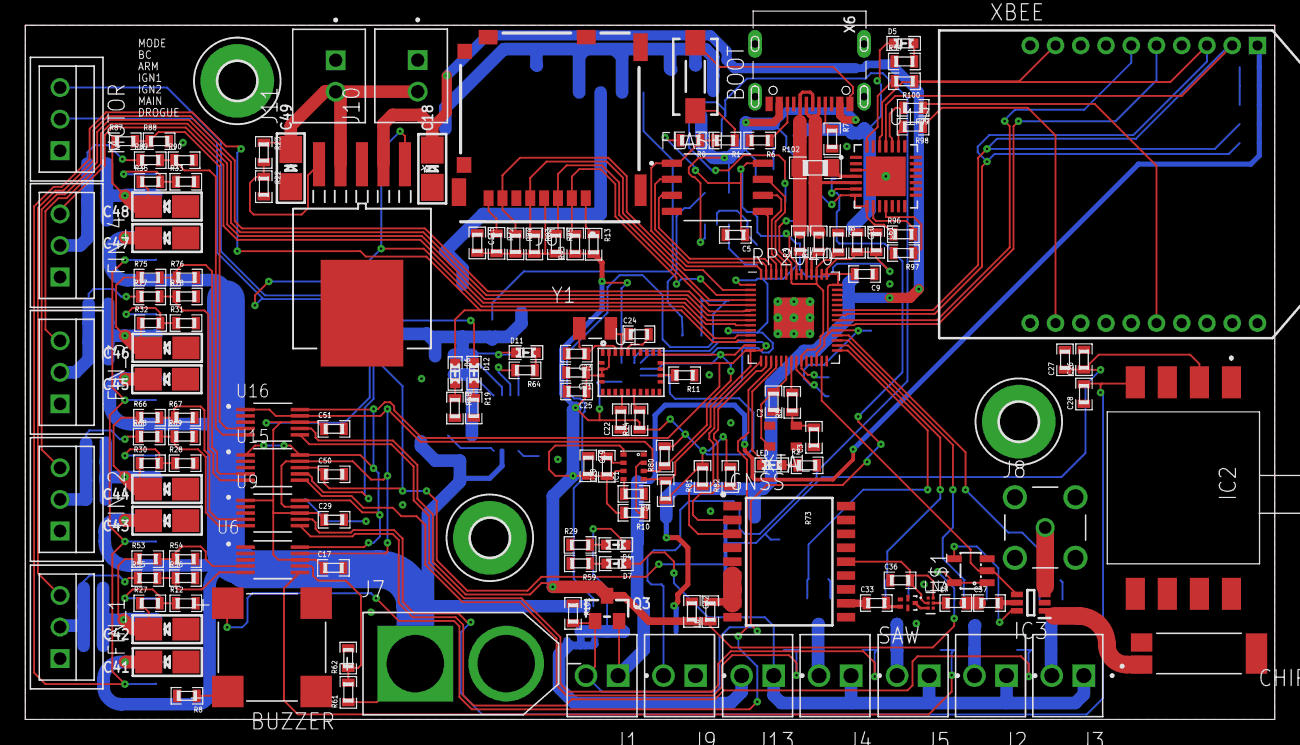
[picture p58: board FLYTE 3.01.brd from above]

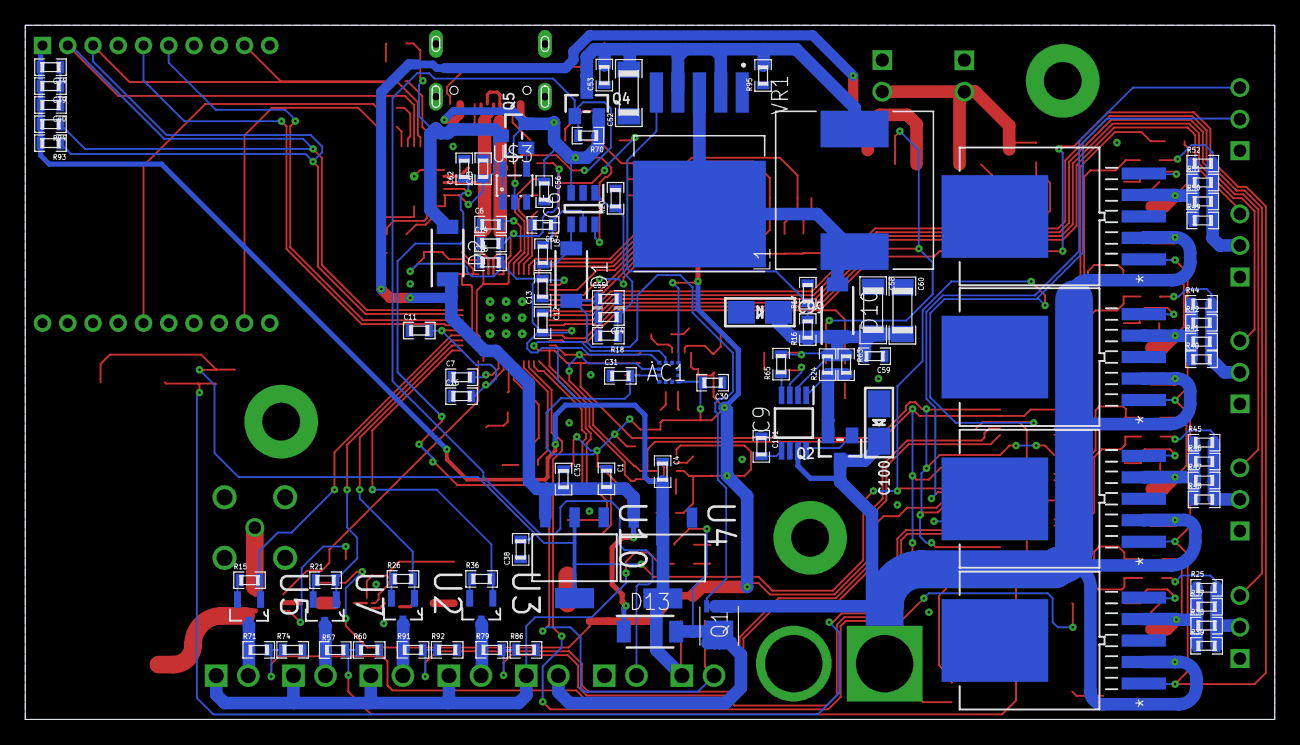
[picture p59: board FLYTE 3.01.brd from below]

Board: 2 copper layers, 99.0 x 55.0 mm, 248 parts (95 on the bottom side), 138 nets.
