IITB-Rocket-Team-Avionics/FLYTE/Eagle files/FLYTE 3/FLYTE 3.00/FLYTE_3.0.brd

## EAGLE design Eagle files/FLYTE 3/FLYTE 3.00/FLYTE_3.0.brd (2024-09-10)

Schematic: FLYTE_3.0.sch

Parts:
1S_POW: V60D60C-M3_I; V60D60CM3I
32XO: ASE
AC1: KX134-1211; KX1341211
AOA: 03-JST-B3B-XH-A; B3B-XH
BOOT: DTSM-3
BUZZER: BUZZER; CUI_CMT-8530S-SMT
C1, C18, C61, C68, C75, C82, C89, C102, C106: 10 uF; 0603
C2, C3, C38, C39: 24 pF; 0603
C4, C57, C62, C69, C76, C83, C90, C103, C109: 4.7 uF; 0603
C5, C6, C7, C9, C11, C12, C13, C14, C15, C16, C19, C20, C21, C22, C25, C40, C41, C42, C43: 100 nF; 0603
C8, C10, C26, C55, C56, C115: 1 uF; 0603
C17, C29, C30, C31, C97, C101: 0.1 uF; 0603
C23, C24: 25 pF; 0603
C27, C32, C51: 10 nF; 0603
C28: 470 pF; 0603
C33, C37: 120 pF; 0603
C34: 3.3 nF; 0603
C35, C64, C71, C78, C85, C92, C105, C111: 22 nF; 0603
C36: 1 nF; 0603
C44, C49: 3.3 pF; 0603
C45, C52, C53: 47 pF; 0603
C46, C48: 8.2 pF; 0603
C47: 22 pF; 0603
C50: 1.5 pF; 0603
C54: 10 pF; 0603
C58: 100 uF; 0805
C59, C60, C66, C67, C73, C74, C80, C81, C87, C88, C94, C95, C107, C108, C113, C114: 0.22 uF; 0603
C63, C70, C77, C84, C91, C110: 1.8 nF; 0603
C65: 220 uF; 1210
C72, C79, C86, C93: 100 uF; 1206
C96, C98, C99, C100: 10uF; EIA3216-18/A-W
C104: 1.2 nF; 0603
C112: 100 uF; 1210
CHG_BST: LT3120JV#PBF; QFN50P400X500X83-29N
CHIP_ANT: W3010; XCVR_W3010
D1, D2, D8, D10, D13: RSX501LAM20TR; SODFL4725X105N
D3, D4, D5, D6, D7, D9, D11, D12: LED.0603; 0603.LED
FIN_1, FIN_2, FIN_3, FIN_4: 03-JST-B3B-XH-A; B3B-XH
FLASH: W25Q128JVSIQ; SOIC127P790X216-8N
GNSS: TESEO-LIV3F; SON110P970X1010X230-18N
H1, H2, H3, H4: MOUNT-PAD-ROUND3.0; 3,0-PAD
IC1: BMP280
IC2: MPXV5100DP
IC3, IC4: AS179-92LF; SOT65P220X100-6N
IC6: MAX8574EUT+T; SOT95P280X145-6N
IC8: MCP73843-420I_MS; SOP65P490X110-8N
IC9: MCP73844-840I_MS; SOP65P490X110-8N
J2, J3, J4, J5, J9, J13: 282834-2; TE_282834-2
J6: 503182-1852; 5031821852
J7: XT60-M; AMASS_XT60-M
J8, J12: CON-SMA-EDGE-S; RFSOLUTIONS_CON-SMA-EDGE-S
J10, J11: B2B-XH-A(LF)(SN); JST_B2B-XH-A(LF)(SN)
L1: 10 nH; 0603
L2: 2.7 nH; 0603
L3, L4, L7: 5.6 nH; 0603
L5: 33 nH; 0603
L6: 27 nH; 0603
L8: 22 uH; 0603
L9, L10, L11, L12, L13, L14, L15, L16: 4.7 uH; 0603
LED: LED.0603; 0603.LED
LNA: BGA725L6; AMP_BGA725L6E6327FTSA1
MOTOR: 03-JST-B3B-XH-A; B3B-XH
Q1, Q6, Q7: SI7625DN-T1-GE3; SIS862DNT1GE3
Q2, Q3, Q4, Q5: MOSFET-PWIDE; SOT23-WIDE
R0, R9, R10, R13, R15, R20, R21, R26, R27, R36, R43, R70, R72, R73, R80, R81, R82, R83, R84, R85: 10k ohm; 0603
R1, R5: 1k ohm; 0603
R2, R19, R58: 60 ohm; 0603
R3, R4: 27.4 ohm; 0603
R6, R7: 5.1k ohm; 0603
R8: 100 ohm; 0603
R11, R14: 10 kohm; 0603
R16: 412k ohm; 0603
R17, R25, R31, R37, R62, R65, R66, R69, R75, R77, R79, R87, R89: 100k ohm; 0603
R18: 137k ohm; 0603
R22, R32, R38, R45, R49, R53: 46.4k ohm; 0603
R23, R33, R39, R42, R46, R50, R54, R67, R86, R88: 158k ohm; 0603
R24, R35: 523k ohm; 0603
R28: 105 ohm; 0603
R29, R59: 315 ohm; 0603
R30: 316k ohm; 0603
R34, R61, R64: 158 ohm; 0603
R40, R47, R51, R55: 402k ohm; 0603
R41: 21k ohm; 0603
R44, R48, R52, R56: 50k ohm; 0603
R60, R63: 0.1 ohm; 0603
R68: 1.3M ohm; 0603
R74: 36.5k ohm; 0603
R76: 43k ohm; 0603
R78: 28k ohm; 0603
REG_3V3, REG_5V: LT3120JV#PBF; QFN50P400X500X83-29N
REG_CAM: LT3120JV#PBF; QFN50P400X500X83-29N
REG_FIN_1, REG_FIN_2: LT3120JV#PBF; QFN50P400X500X83-29N
REG_TVC_1, REG_TVC_2: LT3120JV#PBF; QFN50P400X500X83-29N
RP2040: RP2040-QFN56; RP2040-QFN-56
SAW: SAW_FILTER; FIL_AFS14A04-1575.42-T3
SS: 03-JST-B3B-XH-A; B3B-XH
SX1272: SX1272IMLTRT; QFN65P600X600X100-29N
TVC_1, TVC_2, TVC_3, TVC_4: 03-JST-B3B-XH-A; B3B-XH
U1: BNO055; LGA28R50P4X10_380X520X100
U2, U3, U5, U7: CJ3400; SOT91P240X120-3N
U6, U9: ADS1115IDGSR; SOP50P490X110-10N
U$1, U$2, U$3: SN74LVC1G04DBVR; SOT23-5
U$11: XT30UPB-M
X6: USB Type C; USB_C_CUSB31-CFM2AX-01-X
XTAL: ASE
Y1: FC-135_32.7680KA-A0; XTAL_FC-135_32.7680KA-A0

Connections:
1S_ADC: R78.2, R79.1, U6.5 (AIN1)
1S_POW: 1S_POW.1 (A_1), D3.P$1 (1), Q7.5 (D_1), Q7.6 (D_2), Q7.7 (D_3), Q7.8 (D_4), Q7.9 (D_5), Q7.10 (D_6), Q7.11 (D_7)
1V1: C6.2, C7.2, C8.2, RP2040.23 (DVDD0), RP2040.45 (VREG_OUT), RP2040.50 (DVDD1)
2S_ADC: R16.2, R17.1, U6.4 (AIN0)
2S_POW: 1S_POW.2 (A_2), D4.P$1 (1), Q6.5 (D_1), Q6.6 (D_2), Q6.7 (D_3), Q6.8 (D_4), Q6.9 (D_5), Q6.10 (D_6), Q6.11 (D_7)
3V3: AC1.1 (SDO/ADDR), AC1.3 (IO_VDD), AC1.7 (VDD), AC1.10 (NCS), AOA.P$2, C5.1, C9.2, C10.2, C11.2, C12.2, C13.2, C14.2, C15.2, C16.2, C17.1, C19.2, C20.1, C21.1, C25.1, C29.1, C30.2, C31.2, C32.2, C35.1, C40.2, C41.2, C58.2, C115.2, FLASH.8 (VCC), IC1.6 (VDDIO), IC1.8 (VDD), J6.4 (VDD), L6.1, R0.2, R10.2, R13.2, R14.1, R27.2, R30.2, R43.1, R72.2, R73.2, R80.2, R81.2, R82.2, R83.2, R84.2, R85.2, REG_3V3.2 (PVOUT_1), REG_3V3.4 (PVOUT_2), REG_3V3.5 (ISP), REG_3V3.6 (ISN), RP2040.1 (IOVDD0), RP2040.10 (IOVDD1), RP2040.22 (IOVDD2), RP2040.26 (RUN), RP2040.33 (IOVDD3), RP2040.42 (IOVDD4), RP2040.44 (VREG_IN), RP2040.48 (USB_VDD), RP2040.49 (IOVDD5), SS.P$2, SX1272.1 (VBAT1), SX1272.15 (VBAT2), U1.3 (VDD), U1.4 (NBOOT_LOAD_PIN), U1.28 (VDDIO), U6.8 (VDD), U9.1 (ADDR), U9.8 (VDD), U$1.1 (NC), U$1.5 (VCC), U$2.1 (NC), U$2.5 (VCC)
5V: C26.1, C27.1, C64.1, C65.2, IC2.2 (VS), MOTOR.P$2, R35.2, REG_5V.2 (PVOUT_1), REG_5V.4 (PVOUT_2), REG_5V.5 (ISP), REG_5V.6 (ISN)
ADC_AVDD: RP2040.43 (ADC_AVDD)
AIN2: R88.2, R89.1, U6.6 (AIN2)
AIN3: R86.2, R87.1, U6.7 (AIN3)
AOA_ADC: AOA.P$3, U9.4 (AIN0)
BC: J9.2, Q4.1 (G), R70.2, U$3.1 (NC), U$3.2 (A), U$3.5 (VCC)
BUZZER: BUZZER.P, RP2040.14 (GPIO11)
CAM: D12.P$1 (1), REG_CAM.16 (EN/UVLO), RP2040.35 (GPIO23)
CC1: R7.1, X6.A5 (CC1)
CC2: R6.1, X6.B5 (CC2)
CSB: IC1.2 (CSB), R10.1
CS_SD: J6.2 (CD/DAT3), R43.2, RP2040.7 (GPIO5)
CS_SX: R27.1, RP2040.32 (GPIO21), SX1272.20 (NSS)
CTRL: D6.P$1 (1), REG_FIN_1.16 (EN/UVLO), REG_FIN_2.16 (EN/UVLO), REG_TVC_1.16 (EN/UVLO), REG_TVC_2.16 (EN/UVLO), RP2040.36 (GPIO24)
D+: R3.2, X6.A6 (D+), X6.B6 (D+)
D-: R4.2, X6.A7 (D-), X6.B7 (D-)
DROGUE: R15.2, RP2040.2 (GPIO0), U5.1 (G)
F1: R30.1, R31.2, REG_3V3.9 (FB)
F2: R35.1, R37.2, REG_5V.9 (FB)
F3: R40.1, R44.2, REG_FIN_1.9 (FB)
F4: R47.1, R48.2, REG_FIN_2.9 (FB)
F5: R51.1, R52.2, REG_TVC_1.9 (FB)
F6: R55.1, R56.2, REG_TVC_2.9 (FB)
F7: CHG_BST.9 (FB), R68.1, R69.2
F8: R24.1, R25.2, REG_CAM.9 (FB)
FB: C54.1, IC6.1 (FB), R18.1, R20.1
FIN_1: FIN_1.P$3, RP2040.13 (GPIO10)
FIN_2: FIN_2.P$3, RP2040.15 (GPIO12)
FIN_3: FIN_3.P$3, RP2040.11 (GPIO8)
FIN_4: FIN_4.P$3, RP2040.12 (GPIO9)
GND: 32XO.2 (GND), 32XO.4 (VDD), AC1.4 (TRIG), AC1.8 (GND_1), AC1.9 (GND_2), AOA.P$1, BOOT.1, C1.2, C2.1, C3.1, C4.2, C5.2, C6.1, C7.1, C8.1, C9.1, C10.1, C11.1, C12.1, C13.1, C14.1, C15.1, C16.1, C17.2, C18.2, C19.1, C20.2, C21.2, C22.1, C23.2, C24.2, C25.2, C26.2, C27.2, C28.1, C29.2, C30.1, C31.1, C32.1, C34.1, C36.1, C38.1, C39.1, C40.1, C41.1, C42.1, C43.1, C44.2, C46.2, C48.2, C49.2, C51.2, C52.2, C55.2, C56.2, C57.2, C58.1, C61.2, C62.2, C63.1, C65.1, C68.2, C69.2, C70.1, C72.1, C75.2, C76.2, C77.1, C79.1, C82.2, C83.2, C84.1, C86.1, C89.2, C90.2, C91.1, C93.1, C96.-, C97.1, C98.-, C99.-, C100.-, C101.1, C102.2, C103.2, C104.1, C106.1, C109.2, C110.1, C112.1, C115.1, CHG_BST.3 (GND_1), CHG_BST.11 (GND_2), CHG_BST.15 (SYNC/MODE), CHG_BST.18 (GND_3), CHG_BST.22 (GND_4), CHG_BST.29 (PGND), CHG_BST.P$1 (PGND), CHG_BST.P$2 (PGND), CHG_BST.P$3 (PGND), CHG_BST.P$4 (PGND), CHG_BST.P$5 (PGND), CHG_BST.P$6 (PGND), CHIP_ANT.2 (GND), CHIP_ANT.3 (GND), FIN_1.P$1, FIN_2.P$1, FIN_3.P$1, FIN_4.P$1, FLASH.4 (GND), GNSS.1 (GND), GNSS.10 (GND_RF_1), GNSS.12 (GND_RF_2), H1.B3,0, H2.B3,0, H3.B3,0, H4.B3,0, IC1.1 (GND), IC1.7 (GND), IC2.3 (GND), IC3.2 (GND), IC4.2 (GND), IC6.2 (GND), IC8.6 (VSS), IC9.6 (VSS), J6.6 (VSS), J7.N (NEG), J8.G1 (2), J8.G2 (2), J8.G3 (2), J8.G4 (2), J9.1, J10.1, J11.1, J12.G1 (2), J12.G2 (2), J12.G3 (2), J12.G4 (2), LNA.1 (GND), LNA.4 (GNDRF), MOTOR.P$1, R2.2, R6.2, R7.2, R8.2, R9.1, R11.1, R15.1, R17.2, R19.2, R20.2, R21.1, R23.1, R25.1, R26.1, R28.1, R29.1, R31.1, R33.1, R34.1, R36.1, R37.1, R39.1, R42.1, R44.1, R46.1, R48.1, R50.1, R52.1, R54.1, R56.1, R58.2, R59.2, R67.1, R69.1, R75.2, R77.2, R79.2, R87.2, R89.2, REG_3V3.3 (GND_1), REG_3V3.11 (GND_2), REG_3V3.15 (SYNC/MODE), REG_3V3.18 (GND_3), REG_3V3.22 (GND_4), REG_3V3.29 (PGND), REG_3V3.P$1 (PGND), REG_3V3.P$2 (PGND), REG_3V3.P$3 (PGND), REG_3V3.P$4 (PGND), REG_3V3.P$5 (PGND), REG_3V3.P$6 (PGND), REG_5V.3 (GND_1), REG_5V.11 (GND_2), REG_5V.15 (SYNC/MODE), REG_5V.18 (GND_3), REG_5V.22 (GND_4), REG_5V.29 (PGND), REG_5V.P$1 (PGND), REG_5V.P$2 (PGND), REG_5V.P$3 (PGND), REG_5V.P$4 (PGND), REG_5V.P$5 (PGND), REG_5V.P$6 (PGND), REG_CAM.3 (GND_1), REG_CAM.11 (GND_2), REG_CAM.15 (SYNC/MODE), REG_CAM.18 (GND_3), REG_CAM.22 (GND_4), REG_CAM.29 (PGND), REG_CAM.P$1 (PGND), REG_CAM.P$2 (PGND), REG_CAM.P$3 (PGND), REG_CAM.P$4 (PGND), REG_CAM.P$5 (PGND), REG_CAM.P$6 (PGND), REG_FIN_1.3 (GND_1), REG_FIN_1.11 (GND_2), REG_FIN_1.15 (SYNC/MODE), REG_FIN_1.18 (GND_3), REG_FIN_1.22 (GND_4), REG_FIN_1.29 (PGND), REG_FIN_1.P$1 (PGND), REG_FIN_1.P$2 (PGND), REG_FIN_1.P$3 (PGND), REG_FIN_1.P$4 (PGND), REG_FIN_1.P$5 (PGND), REG_FIN_1.P$6 (PGND), REG_FIN_2.3 (GND_1), REG_FIN_2.11 (GND_2), REG_FIN_2.15 (SYNC/MODE), REG_FIN_2.18 (GND_3), REG_FIN_2.22 (GND_4), REG_FIN_2.29 (PGND), REG_FIN_2.P$1 (PGND), REG_FIN_2.P$2 (PGND), REG_FIN_2.P$3 (PGND), REG_FIN_2.P$4 (PGND), REG_FIN_2.P$5 (PGND), REG_FIN_2.P$6 (PGND), REG_TVC_1.3 (GND_1), REG_TVC_1.11 (GND_2), REG_TVC_1.15 (SYNC/MODE), REG_TVC_1.18 (GND_3), REG_TVC_1.22 (GND_4), REG_TVC_1.29 (PGND), REG_TVC_1.P$1 (PGND), REG_TVC_1.P$2 (PGND), REG_TVC_1.P$3 (PGND), REG_TVC_1.P$4 (PGND), REG_TVC_1.P$5 (PGND), REG_TVC_1.P$6 (PGND), REG_TVC_2.3 (GND_1), REG_TVC_2.11 (GND_2), REG_TVC_2.15 (SYNC/MODE), REG_TVC_2.18 (GND_3), REG_TVC_2.22 (GND_4), REG_TVC_2.29 (PGND), REG_TVC_2.P$1 (PGND), REG_TVC_2.P$2 (PGND), REG_TVC_2.P$3 (PGND), REG_TVC_2.P$4 (PGND), REG_TVC_2.P$5 (PGND), REG_TVC_2.P$6 (PGND), RP2040.19 (TESTEN), RP2040.57 (GND), RP2040.58 (GND), RP2040.59 (GND), RP2040.60 (GND), RP2040.61 (GND), RP2040.62 (GND), RP2040.63 (GND), RP2040.64 (GND), RP2040.65 (GND), RP2040.66 (GND), SAW.B (GND), SAW.D (GND), SAW.E (GND), SS.P$1, SX1272.16 (GND), SX1272.22 (GND), SX1272.26 (GND), SX1272.29 (GND), SX1272.P$1 (GND), SX1272.P$2 (GND), SX1272.P$3 (GND), SX1272.P$4 (GND), SX1272.P$5 (GND), SX1272.P$6 (GND), SX1272.P$7 (GND), SX1272.P$8 (GND), SX1272.P$9 (GND), TVC_1.P$1, TVC_2.P$1, TVC_3.P$1, TVC_4.P$1, U1.2 (GND), U1.5 (PS1), U1.6 (PS0), U1.10 (PIN10), U1.15 (PIN15), U1.16 (PIN16), U1.18 (COM2), U1.25 (GNDIO), U2.2 (S), U3.2 (S), U5.2 (S), U6.1 (ADDR), U6.3 (GND), U7.2 (S), U9.3 (GND), U$1.3 (GND), U$2.3 (GND), U$3.3 (GND), U$11.P$2 (-), X6.A1B12 (GND), X6.B1A12 (GND), XTAL.2 (GND), XTAL.4 (VDD)
GPS_RX: GNSS.3 (RX), R81.1, RP2040.27 (GPIO16)
GPS_TX: GNSS.2 (TX), R82.1, RP2040.28 (GPIO17)
IGN1: R36.2, RP2040.5 (GPIO3), U3.1 (G)
IGN2: R26.2, RP2040.4 (GPIO2), U2.1 (G)
LED: LED.P$1 (1), RP2040.37 (GPIO25)
MAIN: R21.2, RP2040.3 (GPIO1), U7.1 (G)
MISO: J6.7 (DAT0), R84.1, RP2040.31 (GPIO20), SX1272.18 (MISO)
MOS: D13.2 (A), J13.2, Q1.5 (D_1), Q1.6 (D_2), Q1.7 (D_3), Q1.8 (D_4), Q1.9 (D_5), Q1.10 (D_6), Q1.11 (D_7)
MOSI: J6.3 (CMD), R85.1, RP2040.30 (GPIO19), SX1272.19 (MOSI)
unnamed: D1.2 (A), IC6.4 (LX), L8.2
unnamed: LED.P$2 (2), R2.1
unnamed: C3.2, R5.1, XTAL.1 (TRI)
unnamed: C33.1, GNSS.11 (RF_IN)
unnamed: BUZZER.N, R8.1
unnamed: D12.P$2 (2), R19.1
unnamed: J6.1 (DATA2), R13.1
unnamed: GNSS.6 (VBATT), GNSS.7 (VCC_IO), GNSS.8 (VCC), L6.2
unnamed: C22.2, U1.9 (CAP)
unnamed: R11.2, U1.17 (COM3)
unnamed: J6.8 (DAT1), R72.1
unnamed: R74.2, R75.1, U9.6 (AIN2)
unnamed: R14.2, U1.11 (NRESET)
unnamed: R22.2, REG_CAM.10 (VC)
unnamed: R76.2, R77.1, U9.7 (AIN3)
unnamed: C110.2, R22.1
unnamed: C59.2, L9.1, REG_3V3.26 (SW2_1), REG_3V3.27 (SW2_2)
unnamed: L7.1, LNA.5 (AI)
unnamed: C37.1, L7.2
unnamed: C33.2, SAW.A (OUT)
unnamed: LNA.3 (AO), SAW.C (IN)
unnamed: C37.2, IC3.5 (J1)
unnamed: CHIP_ANT.1 (FEEDING), IC3.1 (J3)
unnamed: IC3.3 (J2), J8.1
unnamed: C42.2, SX1272.2 (VR_ANA)
unnamed: C43.2, SX1272.3 (VR_DIG)
unnamed: C44.1, C45.2, L1.2
unnamed: C45.1, IC4.3 (J2)
unnamed: L2.1, SX1272.27 (PA_BOOST)
unnamed: L1.1, SX1272.25 (RFI)
unnamed: C46.1, C47.2, L2.2, L5.2
unnamed: C47.1, L3.1
unnamed: C48.1, C50.2, L3.2, L4.1
unnamed: C49.1, C50.1, IC4.1 (J3), L4.2
unnamed: C51.1, C52.1, L5.1, SX1272.28 (VR_PA)
unnamed: C53.2, IC4.5 (J1)
unnamed: C53.1, J12.1
unnamed: C99.+, D10.1 (K), D11.P$1 (1), IC9.2 (VDD), R63.1, R65.2
unnamed: R41.2, REG_3V3.10 (VC)
unnamed: IC9.1 (SENSE), Q2.2 (S), R63.2
unnamed: C34.2, R41.1
unnamed: R42.2, REG_3V3.14 (RT)
unnamed: C35.2, REG_3V3.1 (BST3)
unnamed: C60.1, L9.2, REG_3V3.24 (SW1_1), REG_3V3.25 (SW1_2)
unnamed: C59.1, REG_3V3.28 (BST2)
unnamed: C57.1, IC6.5 (SW), L8.1
unnamed: D3.P$2 (2), R28.2
unnamed: C54.2, C55.1, D1.1 (K), Q1.4 (G), R18.2
unnamed: D4.P$2 (2), R29.2
unnamed: D5.P$2 (2), R34.2
unnamed: C60.2, REG_3V3.23 (BST1)
unnamed: R32.2, REG_5V.10 (VC)
unnamed: C63.2, R32.1
unnamed: R33.2, REG_5V.14 (RT)
unnamed: C64.2, REG_5V.1 (BST3)
unnamed: C66.2, L10.1, REG_5V.26 (SW2_1), REG_5V.27 (SW2_2)
unnamed: C67.1, L10.2, REG_5V.24 (SW1_1), REG_5V.25 (SW1_2)
unnamed: C66.1, REG_5V.28 (BST2)
unnamed: C67.2, REG_5V.23 (BST1)
unnamed: R38.2, REG_FIN_1.10 (VC)
unnamed: C70.2, R38.1
unnamed: R39.2, REG_FIN_1.14 (RT)
unnamed: C71.2, REG_FIN_1.1 (BST3)
unnamed: C73.2, L11.1, REG_FIN_1.26 (SW2_1), REG_FIN_1.27 (SW2_2)
unnamed: C74.1, L11.2, REG_FIN_1.24 (SW1_1), REG_FIN_1.25 (SW1_2)
unnamed: C73.1, REG_FIN_1.28 (BST2)
unnamed: C74.2, REG_FIN_1.23 (BST1)
unnamed: R45.2, REG_FIN_2.10 (VC)
unnamed: C77.2, R45.1
unnamed: R46.2, REG_FIN_2.14 (RT)
unnamed: C78.2, REG_FIN_2.1 (BST3)
unnamed: C80.2, L12.1, REG_FIN_2.26 (SW2_1), REG_FIN_2.27 (SW2_2)
unnamed: C81.1, L12.2, REG_FIN_2.24 (SW1_1), REG_FIN_2.25 (SW1_2)
unnamed: C80.1, REG_FIN_2.28 (BST2)
unnamed: C81.2, REG_FIN_2.23 (BST1)
unnamed: R49.2, REG_TVC_1.10 (VC)
unnamed: C84.2, R49.1
unnamed: R50.2, REG_TVC_1.14 (RT)
unnamed: C85.2, REG_TVC_1.1 (BST3)
unnamed: C87.2, L13.1, REG_TVC_1.26 (SW2_1), REG_TVC_1.27 (SW2_2)
unnamed: C88.1, L13.2, REG_TVC_1.24 (SW1_1), REG_TVC_1.25 (SW1_2)
unnamed: C87.1, REG_TVC_1.28 (BST2)
unnamed: C88.2, REG_TVC_1.23 (BST1)
unnamed: R53.2, REG_TVC_2.10 (VC)
unnamed: C91.2, R53.1
unnamed: R54.2, REG_TVC_2.14 (RT)
unnamed: C92.2, REG_TVC_2.1 (BST3)
unnamed: C94.2, L14.1, REG_TVC_2.26 (SW2_1), REG_TVC_2.27 (SW2_2)
unnamed: C95.1, L14.2, REG_TVC_2.24 (SW1_1), REG_TVC_2.25 (SW1_2)
unnamed: C94.1, REG_TVC_2.28 (BST2)
unnamed: C95.2, REG_TVC_2.23 (BST1)
unnamed: D6.P$2 (2), R58.1
unnamed: D7.P$2 (2), R59.1
unnamed: C96.+, D8.1 (K), D9.P$1 (1), IC8.2 (VDD), R60.1, R62.2
unnamed: IC8.1 (SENSE), Q3.2 (S), R60.2
unnamed: D9.P$2 (2), R61.1
unnamed: IC8.3 (STAT1), R61.2
unnamed: IC8.4 (EN), R62.1
unnamed: IC8.8 (DRV), Q3.1 (G)
unnamed: D11.P$2 (2), R64.1
unnamed: C97.2, IC8.5 (TIMER)
unnamed: IC9.3 (STAT1), R64.2
unnamed: IC9.4 (EN), R65.1
unnamed: IC9.8 (DRV), Q2.1 (G)
unnamed: C101.2, IC9.5 (TIMER)
unnamed: CHG_BST.10 (VC), R66.2
unnamed: C104.2, R66.1
unnamed: CHG_BST.14 (RT), R67.2
unnamed: C105.2, CHG_BST.1 (BST3)
unnamed: C107.2, CHG_BST.26 (SW2_1), CHG_BST.27 (SW2_2), L15.1
unnamed: C108.1, CHG_BST.24 (SW1_1), CHG_BST.25 (SW1_2), L15.2
unnamed: C107.1, CHG_BST.28 (BST2)
unnamed: C108.2, CHG_BST.23 (BST1)
unnamed: R23.2, REG_CAM.14 (RT)
unnamed: C111.2, REG_CAM.1 (BST3)
unnamed: Q5.1 (G), U$3.4 (Y)
unnamed: C113.2, L16.1, REG_CAM.26 (SW2_1), REG_CAM.27 (SW2_2)
unnamed: C114.1, L16.2, REG_CAM.24 (SW1_1), REG_CAM.25 (SW1_2)
unnamed: C113.1, REG_CAM.28 (BST2)
unnamed: C114.2, REG_CAM.23 (BST1)
N_RXTX: IC4.6 (V2), U$2.4 (Y)
N_S: IC3.6 (V2), U$1.4 (Y)
P1: C4.1, REG_3V3.8 (PROG), REG_3V3.12 (MPPC), REG_3V3.13 (VCC)
P2: C62.1, REG_5V.8 (PROG), REG_5V.12 (MPPC), REG_5V.13 (VCC)
P3: C69.1, REG_FIN_1.8 (PROG), REG_FIN_1.12 (MPPC), REG_FIN_1.13 (VCC)
P4: C76.1, REG_FIN_2.8 (PROG), REG_FIN_2.12 (MPPC), REG_FIN_2.13 (VCC)
P5: C83.1, REG_TVC_1.8 (PROG), REG_TVC_1.12 (MPPC), REG_TVC_1.13 (VCC)
P6: C90.1, REG_TVC_2.8 (PROG), REG_TVC_2.12 (MPPC), REG_TVC_2.13 (VCC)
P7: C103.1, CHG_BST.8 (PROG), CHG_BST.12 (MPPC), CHG_BST.13 (VCC)
P8: C109.1, REG_CAM.8 (PROG), REG_CAM.12 (MPPC), REG_CAM.13 (VCC)
PYRO_DROGUE: J3.2, U5.3 (D)
PYRO_IGN1: J4.2, U3.3 (D)
PYRO_IGN2: J5.2, U2.3 (D)
PYRO_MAIN: J2.2, U7.3 (D)
QSPI_SCLK: FLASH.6 (CLK), RP2040.52 (QSPI_SCLK)
QSPI_SD0: FLASH.5 (DI(IO0)), RP2040.53 (QSPI_SD0)
QSPI_SD1: FLASH.2 (DO(IO1)), RP2040.55 (QSPI_SD1)
QSPI_SD2: FLASH.3 (/WP(IO2)), RP2040.54 (QSPI_SD2)
QSPI_SD3: FLASH.7 (/HOLD/RESET(IO3)), RP2040.51 (QSPI_SD3)
QSPI_SS: FLASH.1 (/CS), R0.1, R1.2, RP2040.56 (QSPI_SS)
RXTX: IC4.4 (V1), SX1272.23 (RXTX), U$2.2 (A)
S: IC3.4 (V1), RP2040.34 (GPIO22), U$1.2 (A)
SCK: J6.5 (CLK), R83.1, RP2040.29 (GPIO18), SX1272.17 (SCK)
SCL: AC1.12 (SCLK/SCL), IC1.4 (SCK), R73.1, RP2040.18 (GPIO15), U1.19 (COM1), U6.10 (SCL), U9.10 (SCL)
SDA: AC1.2 (SDI/SDA), IC1.3 (SDI), R80.1, RP2040.17 (GPIO14), U1.20 (COM0), U6.9 (SDA), U9.9 (SDA)
SDO: IC1.5 (SDO), R9.2
SS_ADC: SS.P$3, U9.5 (AIN1)
TVC_1: RP2040.9 (GPIO7), TVC_1.P$3
TVC_2: RP2040.8 (GPIO6), TVC_2.P$3
TVC_3: RP2040.16 (GPIO13), TVC_3.P$3
TVC_4: RP2040.6 (GPIO4), TVC_4.P$3
USB+: Q4.2 (S), Q5.2 (S), R70.1, X6.A4B9 (VBUS), X6.B4A9 (VBUS)
USB_BOOT: BOOT.2, R1.1
USB_BST: C105.1, C106.2, CHG_BST.2 (PVOUT_1), CHG_BST.4 (PVOUT_2), CHG_BST.5 (ISP), CHG_BST.6 (ISN), D8.2 (A), D10.2 (A), Q6.4 (G), Q7.4 (G), R68.2
USB_CHG: C102.1, CHG_BST.16 (EN/UVLO), CHG_BST.17 (VIN), CHG_BST.19 (PVIN_1), CHG_BST.20 (PVIN_2), CHG_BST.21 (PVIN_3), Q4.3 (D)
USB_DM: R4.1, RP2040.46 (USB_DM)
USB_DP: R3.1, RP2040.47 (USB_DP)
VBUS: C56.1, D2.2 (A), D5.P$1 (1), IC6.3 (!SHDN), IC6.6 (VCC), Q5.3 (D)
VCC: C1.1, C18.1, C61.1, D2.1 (K), D13.1 (K), REG_3V3.16 (EN/UVLO), REG_3V3.17 (VIN), REG_3V3.19 (PVIN_1), REG_3V3.20 (PVIN_2), REG_3V3.21 (PVIN_3), REG_5V.16 (EN/UVLO), REG_5V.17 (VIN), REG_5V.19 (PVIN_1), REG_5V.20 (PVIN_2), REG_5V.21 (PVIN_3), REG_CAM.17 (VIN), REG_CAM.19 (PVIN_1), REG_CAM.20 (PVIN_2), REG_CAM.21 (PVIN_3)
VCC_CTRL: 1S_POW.3 (COMMON_K), C68.1, C75.1, C82.1, C89.1, Q1.1 (S_1), Q1.2 (S_2), Q1.3 (S_3), REG_FIN_1.17 (VIN), REG_FIN_1.19 (PVIN_1), REG_FIN_1.20 (PVIN_2), REG_FIN_1.21 (PVIN_3), REG_FIN_2.17 (VIN), REG_FIN_2.19 (PVIN_1), REG_FIN_2.20 (PVIN_2), REG_FIN_2.21 (PVIN_3), REG_TVC_1.17 (VIN), REG_TVC_1.19 (PVIN_1), REG_TVC_1.20 (PVIN_2), REG_TVC_1.21 (PVIN_3), REG_TVC_2.17 (VIN), REG_TVC_2.19 (PVIN_1), REG_TVC_2.20 (PVIN_2), REG_TVC_2.21 (PVIN_3)
VCC_PYRO: D7.P$1 (1), J2.1, J3.1, J4.1, J5.1, J13.1
VCC_RF: C36.2, GNSS.14 (VCC_RF), LNA.2 (VCC), LNA.6 (PON)
VOLT_DP: C28.2, IC2.4 (VOUT), R74.1
VOLT_MOTOR: MOTOR.P$3, R76.1
V_CAM: C111.1, C112.2, J10.2, J11.2, R24.2, REG_CAM.2 (PVOUT_1), REG_CAM.4 (PVOUT_2), REG_CAM.5 (ISP), REG_CAM.6 (ISN)
V_FIN_1: C71.1, C72.2, FIN_1.P$2, FIN_2.P$2, R40.2, REG_FIN_1.2 (PVOUT_1), REG_FIN_1.4 (PVOUT_2), REG_FIN_1.5 (ISP), REG_FIN_1.6 (ISN)
V_FIN_2: C78.1, C79.2, FIN_3.P$2, FIN_4.P$2, R47.2, R88.1, REG_FIN_2.2 (PVOUT_1), REG_FIN_2.4 (PVOUT_2), REG_FIN_2.5 (ISP), REG_FIN_2.6 (ISN)
V_TVC_1: C85.1, C86.2, R51.2, R86.1, REG_TVC_1.2 (PVOUT_1), REG_TVC_1.4 (PVOUT_2), REG_TVC_1.5 (ISP), REG_TVC_1.6 (ISN), TVC_1.P$2, TVC_2.P$2
V_TVC_2: C92.1, C93.2, R55.2, REG_TVC_2.2 (PVOUT_1), REG_TVC_2.4 (PVOUT_2), REG_TVC_2.5 (ISP), REG_TVC_2.6 (ISN), TVC_3.P$2, TVC_4.P$2
XIN: C2.2, RP2040.20 (XIN), XTAL.3 (OUT)
XIN1: 32XO.3 (OUT), C38.2, SX1272.4 (XTA)
XIN32: C23.1, U1.27 (XIN32), Y1.1
XOUT: R5.2, RP2040.21 (XOUT)
XOUT1: 32XO.1 (TRI), C39.2, SX1272.5 (XTB)
XOUT32: C24.1, U1.26 (XOUT32), Y1.2
XT30+: C98.+, IC8.7 (VBAT), Q3.3 (D), Q7.1 (S_1), Q7.2 (S_2), Q7.3 (S_3), R78.1, U$11.P$1 (+)
XT60+: C100.+, IC9.7 (VBAT), J7.P (POS), Q2.3 (D), Q6.1 (S_1), Q6.2 (S_2), Q6.3 (S_3), R16.1

Notes on the sheet:
FLASH
USB
RP2040
CRYSTAL OSCILLATOR
VBUS : Power from USB D+ : Data line 1 D- : Data line 2 CC1 & CC2 : Not sure what they are for but both must be pulled to GND using 5.1k ohm resistors when using Type-C USB SHLD : Outer covering of female USB connector. Should be grounded GND : Ground Try to route D+ and D- so that the differential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
Power C9-C16 : Decoupling capacitors for RP2040. Must be placed close to the power pins. C8 must be close to Pin 45, C10 must be close to Pin 44, rest can be jumbled around as you may like. There is one decoupling capacitor less than number of power pins. Not sure why, that's just how it is in the 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
Power C5 - Decoupling capacitor for flash. Must pe placed close to the flash. Boot When CS is pulled LOW on startup by pressing the button, the flash boots up as a mass storage device (like an SD Card). This is similar to plugging in a USB cable into a Pico while holding the BOOTSEL button. As a pr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
Purchase Links LED : https://evelta.com/green-led-smd-0603-package/ Buzzer : https://www.sunrom.com/p/electromagnetic-passive-buzzer-3-5v-smd-pcb-mount-mlt-8530
Crystal oscillators need a load capacitance to osciallte at the right frequency. This particular chip needs 12 pF. So, 2 capacitors of 22 pF each are placed to give an equivalent load capacitance of 11 pF. 24 pF capacitors were not available, but these get the job done. 1k ohm resistor to ensure th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
TESEO-LIV3F : GNSS Chip TX & RX : For UART communication SCL & SDA : For I2C communication PPS : Time pulse from GNSS VCC_RF : Power output from chip to active antenna C20 & C22 : Blocks DC voltage C18 & C21 : Decoupling capacitors GNSS_SWITCH : Used to switch between 3 antennae V1 : 0, V2 : 0 - RF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
GNSS
SX1272

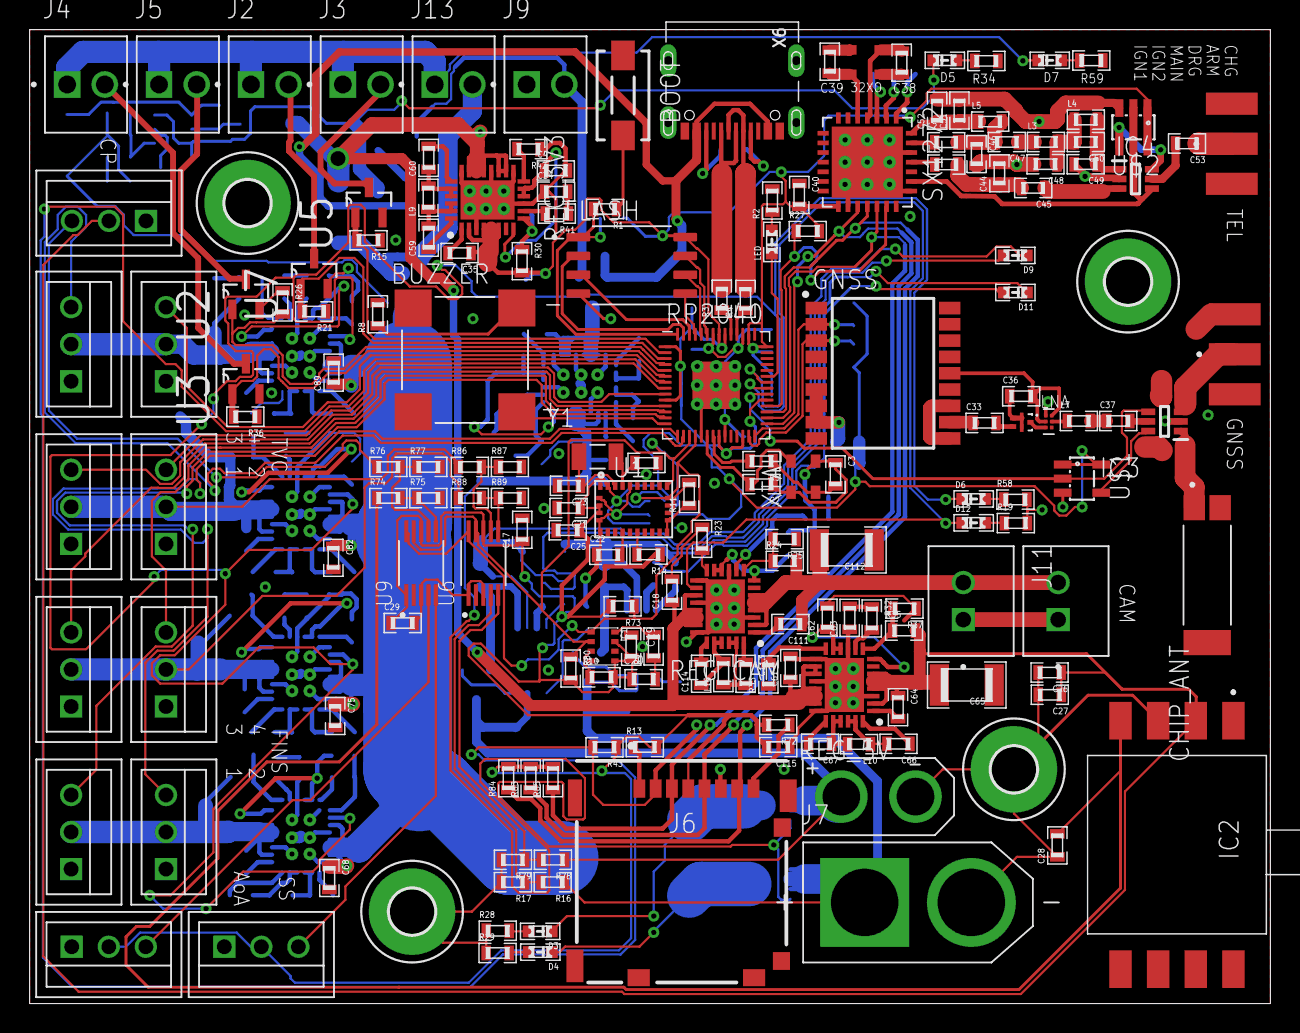
[picture p60: board FLYTE_3.0.brd from above]

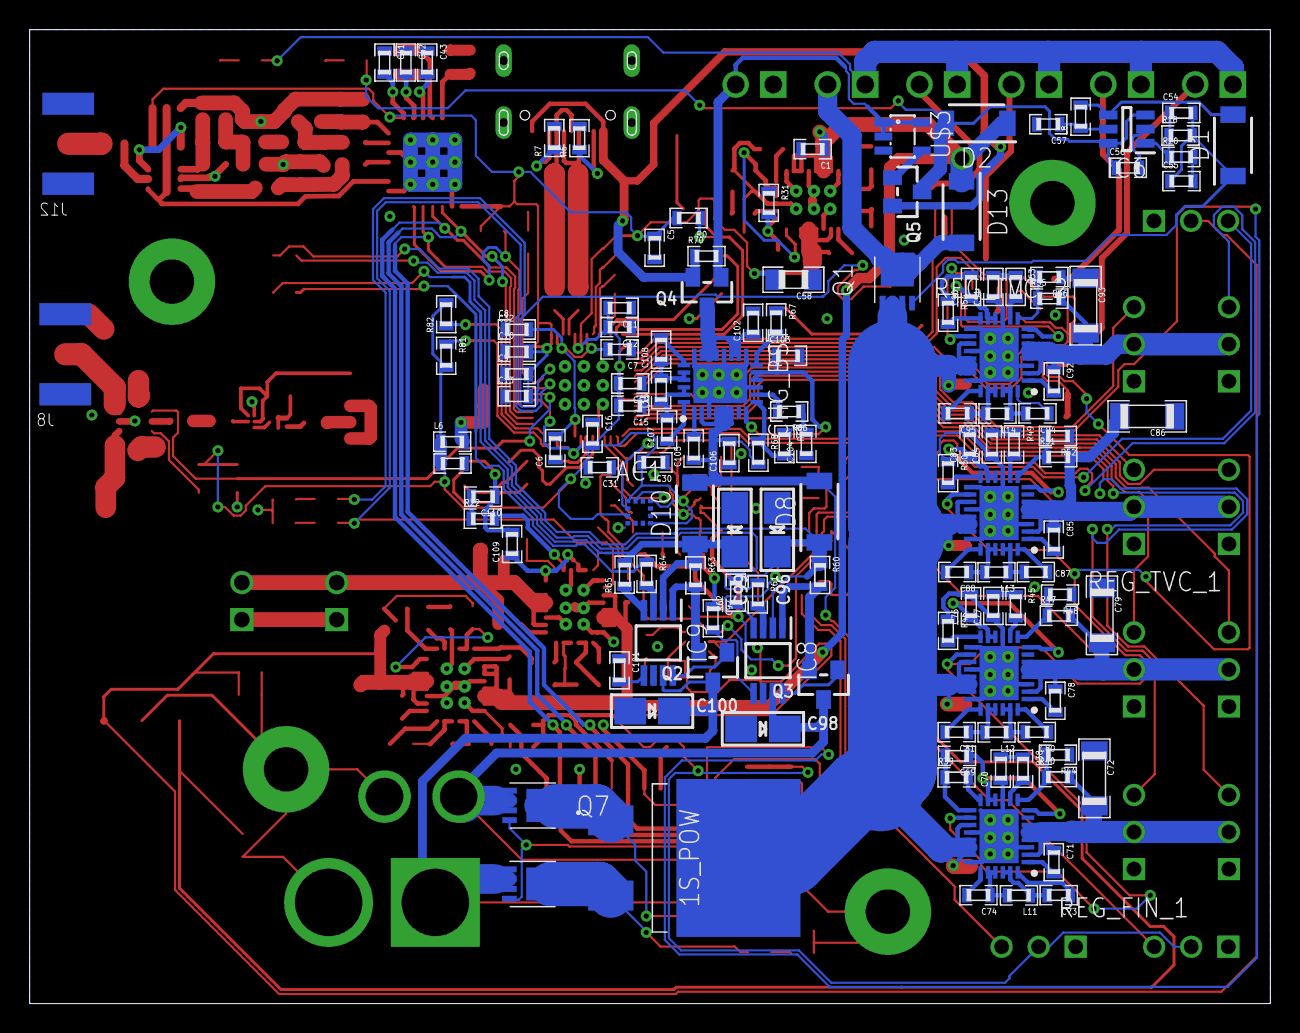
[picture p61: board FLYTE_3.0.brd from below]

Board: 2 copper layers, 83.7 x 65.7 mm, 307 parts (129 on the bottom side), 222 nets.
