IITB-Rocket-Team-Avionics/FLYTE/Eagle files/Prototypes/RF Test/RF_Test.brd

## EAGLE design Eagle files/Prototypes/RF Test/RF_Test.brd (2024-08-08)

Schematic: RF_Test.sch

Parts:
<-D: B5819WS; SOD2512X116N
AP2112: AP2112K-3.3TRG1; SOT95P282X130-5N
C1, C4, C5, C6: 100 nF; CAPC1608X90
C2, C3, C10: 22 pF; CAPC1608X90
C7, C12: 3.3 pF; CAPC1608X90
C8, C15, C16: 47 pF; CAPC1608X90
C9, C11: 8.2 pF; CAPC1608X90
C13: 1.5 pF; CAPC1608X90
C14, C18: 10 nF; CAPC1608X90
C17, C21: 1 nF; CAPC1608X90
C19, C23: 1 uF; CAPC1608X90
C20, C22: 120 pF; CAPC1608X90
CHIP: LED.0603; 0603.LED
CHIP_ANT: W3010; XCVR_W3010
D->: B5819WS; SOD2512X116N
EXT: LED.0603; 0603.LED
GNSS: TESEO-LIV3F; SON110P970X1010X230-18N
GNSS_EXT: CON-SMA-EDGE-S; RFSOLUTIONS_CON-SMA-EDGE-S
GNSS_SWITCH: RF_SWITCH; BGS13SN8E6327XTSA1
L1: 10 nH; INDC1608X90N
L2: 2.7 nH; INDC1608X90N
L3, L4, L7: 5.6 nH; INDC1608X90N
L5: 33 nH; INDC1608X90N
L6: 27 nH; INDC1608X90N
LNA: BGA725L6; AMP_BGA725L6E6327FTSA1
PATCH: LED.0603; 0603.LED
PICO: RASPBERRY_PICO-NO_DEBUG; PICO-PKG-NO_DEBUG
R1: LED_PATCH; RESC1608X50N
R2: LED_CHIP; RESC1608X50N
R3: LED_EXT; RESC1608X50N
R14: 10k ohm; RESC1608X50N
S: RF_SWITCH; SW_BGS12P2L6E6327XTSA1
SAW: SAW_FILTER; FIL_AFS14A04-1575.42-T3
SX1272: SX1272IMLTRT; QFN65P600X600X100-29N
SX_ANT: CON-SMA-EDGE-S; RFSOLUTIONS_CON-SMA-EDGE-S
XTAL: ASE

Connections:
3V3: AP2112.5 (VOUT), C1.2, C4.2, C18.2, C23.1, D->.A, GNSS_SWITCH.1 (VDD), L6.1, S.4 (VDD), SX1272.1 (VBAT1), SX1272.15 (VBAT2)
3V3(OUT): PICO.P$36 (3V3(OUT))
ANT_OFF: GNSS.13 (ANT_OFF), LNA.6 (PON), R14.1
CS: PICO.P$7 (GP5), SX1272.20 (NSS)
DIO0: PICO.P$9 (GP6), SX1272.9 (DIO0)
DIO1: PICO.P$10 (GP7), SX1272.10 (DIO1/DCLK)
DIO2: PICO.P$11 (GP8), SX1272.11 (DIO2/DATA)
DIO3: PICO.P$29 (GP22), SX1272.12 (DIO3)
DIO4: PICO.P$31 (GP26), SX1272.13 (DIO4)
DIO5: PICO.P$32 (GP27), SX1272.14 (DIO5)
GND: AP2112.2 (GND), C1.1, C2.1, C3.1, C4.1, C5.1, C6.1, C7.2, C9.2, C11.2, C12.2, C14.2, C15.2, C17.1, C18.1, C19.2, C21.1, C23.2, CHIP_ANT.2 (GND), CHIP_ANT.3 (GND), GNSS.1 (GND), GNSS.10 (GND_RF_1), GNSS.12 (GND_RF_2), GNSS_EXT.G1 (2), GNSS_EXT.G2 (2), GNSS_EXT.G3 (2), GNSS_EXT.G4 (2), GNSS_SWITCH.8 (DGND), LNA.1 (GND), LNA.4 (GNDRF), PICO.P$3 (GND), PICO.P$8 (GND), PICO.P$13 (GND), PICO.P$18 (GND), PICO.P$23 (GND), PICO.P$28 (GND), PICO.P$33 (GND), PICO.P$38 (GND), R1.1, R2.1, R3.1, R14.2, S.2 (GND), SAW.B (GND), SAW.D (GND), SAW.E (GND), SX1272.16 (GND), SX1272.22 (GND), SX1272.26 (GND), SX1272.29 (GND), SX_ANT.G1 (2), SX_ANT.G2 (2), SX_ANT.G3 (2), SX_ANT.G4 (2), XTAL.2 (GND), XTAL.4 (VDD)
GPS_RX: GNSS.3 (RX), PICO.P$21 (GP16)
GPS_SCL: GNSS.17 (SCL), PICO.P$25 (GP19)
GPS_SDA: GNSS.16 (SDA), PICO.P$24 (GP18)
GPS_TX: GNSS.2 (TX), PICO.P$22 (GP17)
MISO: PICO.P$6 (GP4), SX1272.18 (MISO)
MOSI: PICO.P$5 (GP3), SX1272.19 (MOSI)
unnamed: C22.2, GNSS_SWITCH.6 (RFIN)
unnamed: PATCH.P$1 (1), PICO.P$17 (GP13)
unnamed: CHIP_ANT.1 (FEEDING), GNSS_SWITCH.5 (RF1)
unnamed: C5.2, SX1272.2 (VR_ANA)
unnamed: C6.2, SX1272.3 (VR_DIG)
unnamed: L1.1, SX1272.25 (RFI)
unnamed: C7.1, C8.2, L1.2
unnamed: C8.1, S.3 (RF1)
unnamed: L2.1, SX1272.27 (PA_BOOST)
unnamed: C9.1, C10.2, L2.2, L5.2
unnamed: C10.1, L3.1
unnamed: C11.1, C13.2, L3.2, L4.1
unnamed: C12.1, C13.1, L4.2, S.1 (RF2)
unnamed: C14.1, C15.1, L5.1, SX1272.28 (VR_PA)
unnamed: C16.2, S.5 (RFIN)
unnamed: C16.1, SX_ANT.1
unnamed: GNSS.6 (VBATT), GNSS.7 (VCC_IO), GNSS.8 (VCC), L6.2
unnamed: C20.2, SAW.A (OUT)
unnamed: L7.1, LNA.5 (AI)
unnamed: C22.1, L7.2
unnamed: LNA.3 (AO), SAW.C (IN)
unnamed: D->.K, PICO.P$39 (VSYS)
unnamed: <-D.A, PICO.P$40 (VBUS)
unnamed: GNSS_EXT.1, GNSS_SWITCH.4 (RF3)
unnamed: PATCH.P$2 (2), R1.2
unnamed: CHIP.P$1 (1), PICO.P$16 (GP12)
unnamed: CHIP.P$2 (2), R2.2
unnamed: EXT.P$1 (1), PICO.P$15 (GP11)
unnamed: EXT.P$2 (2), R3.2
PATCH: GNSS_SWITCH.7 (RF2)
PPS: GNSS.4 (1PPS), PICO.P$34 (GP28)
RF_IN: C20.1, GNSS.11 (RF_IN)
RXTX: C17.2, S.6 (CTRL), SX1272.23 (RXTX)
S1: GNSS_SWITCH.3 (V1), PICO.P$20 (GP15)
S2: GNSS_SWITCH.2 (V2), PICO.P$19 (GP14)
SCK: PICO.P$4 (GP2), SX1272.17 (SCK)
VBUS: <-D.K, AP2112.1 (VIN), AP2112.3 (EN), C19.1
VCC_RF: C21.2, GNSS.14 (VCC_RF), LNA.2 (VCC)
XIN: C2.2, SX1272.4 (XTA), XTAL.3 (OUT)
XOUT: C3.2, SX1272.5 (XTB), XTAL.1 (TRI)

Notes on the sheet:
TESEO-LIV3F : GNSS Chip TX & RX : For UART communication SCL & SDA : For I2C communication PPS : Time pulse from GNSS VCC_RF : Power output from chip to active antenna C20 & C22 : Blocks DC voltage C18 & C21 : Decoupling capacitors GNSS_SWITCH : Used to switch between 3 antennae V1 : 0, V2 : 0 - RF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
GNSS
AP2112K-3.3TRG1 : 3.3V regulator C19 & C23 : Decoupling capacitors for regulator (from datasheet). Must be placed close to the regulator Purchase Links 1 uF Capacitors : https://evelta.com/1-uf-25v-0603-smd-multi-layer-ceramic-capacitor-0603x105k250ct-walsin/ AP2112K-3.3TRG1 : https://robu.in/produ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
POWER
PICO
SX1272 : Radio Chip SCK, CS, MOSI, MISO : SPI communication lines XTA, XTB : Connect to external 32 MHz crystal oscillator VBAT1, VBAT2, VR_ANA, VR_DIG : Power pins, only connect external power to VBAT1 & VBAT2 PA_BOOST : RF output in high-power mode VR_PA : Regulated power supply from chip while u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
SX1272

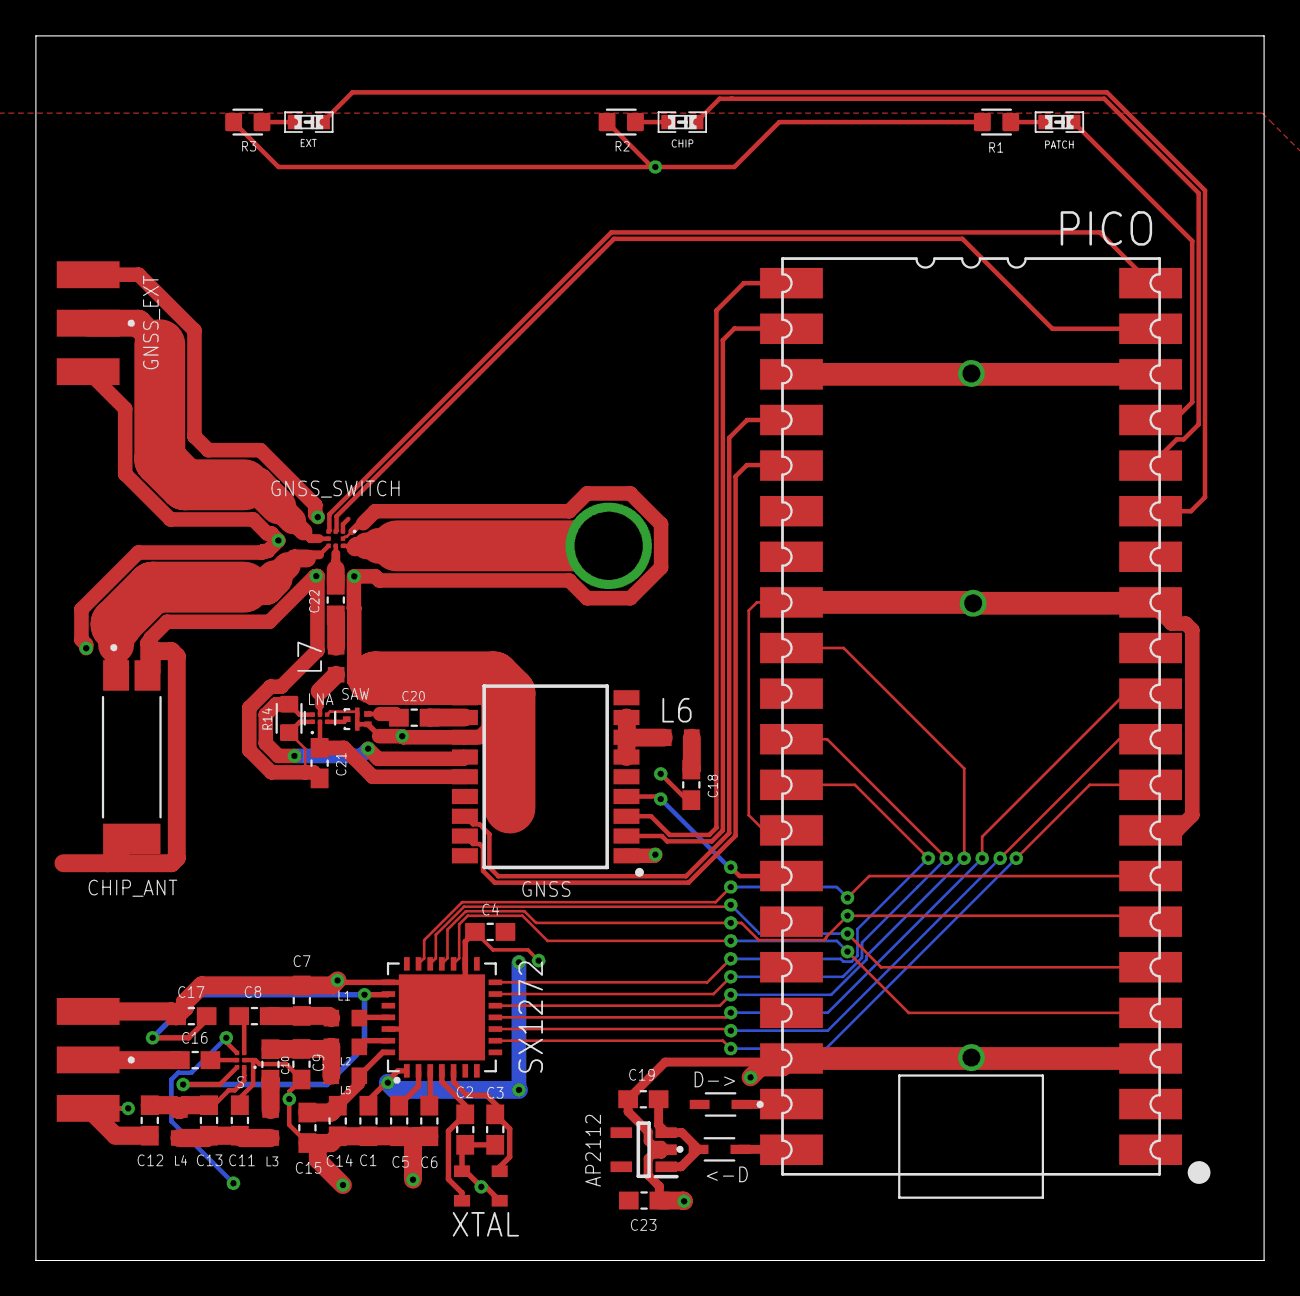
[picture p62: board RF_Test.brd from above]

Board: 2 copper layers, 68.4 x 68.2 mm, 51 parts (0 on the bottom side), 55 nets.
