IITB-Rocket-Team-Avionics/FLYTE/Eagle files/FLYTE 2.1/motor_controller_2_1.brd

## EAGLE design Eagle files/FLYTE 2.1/motor_controller_2_1.brd (2024-05-11)

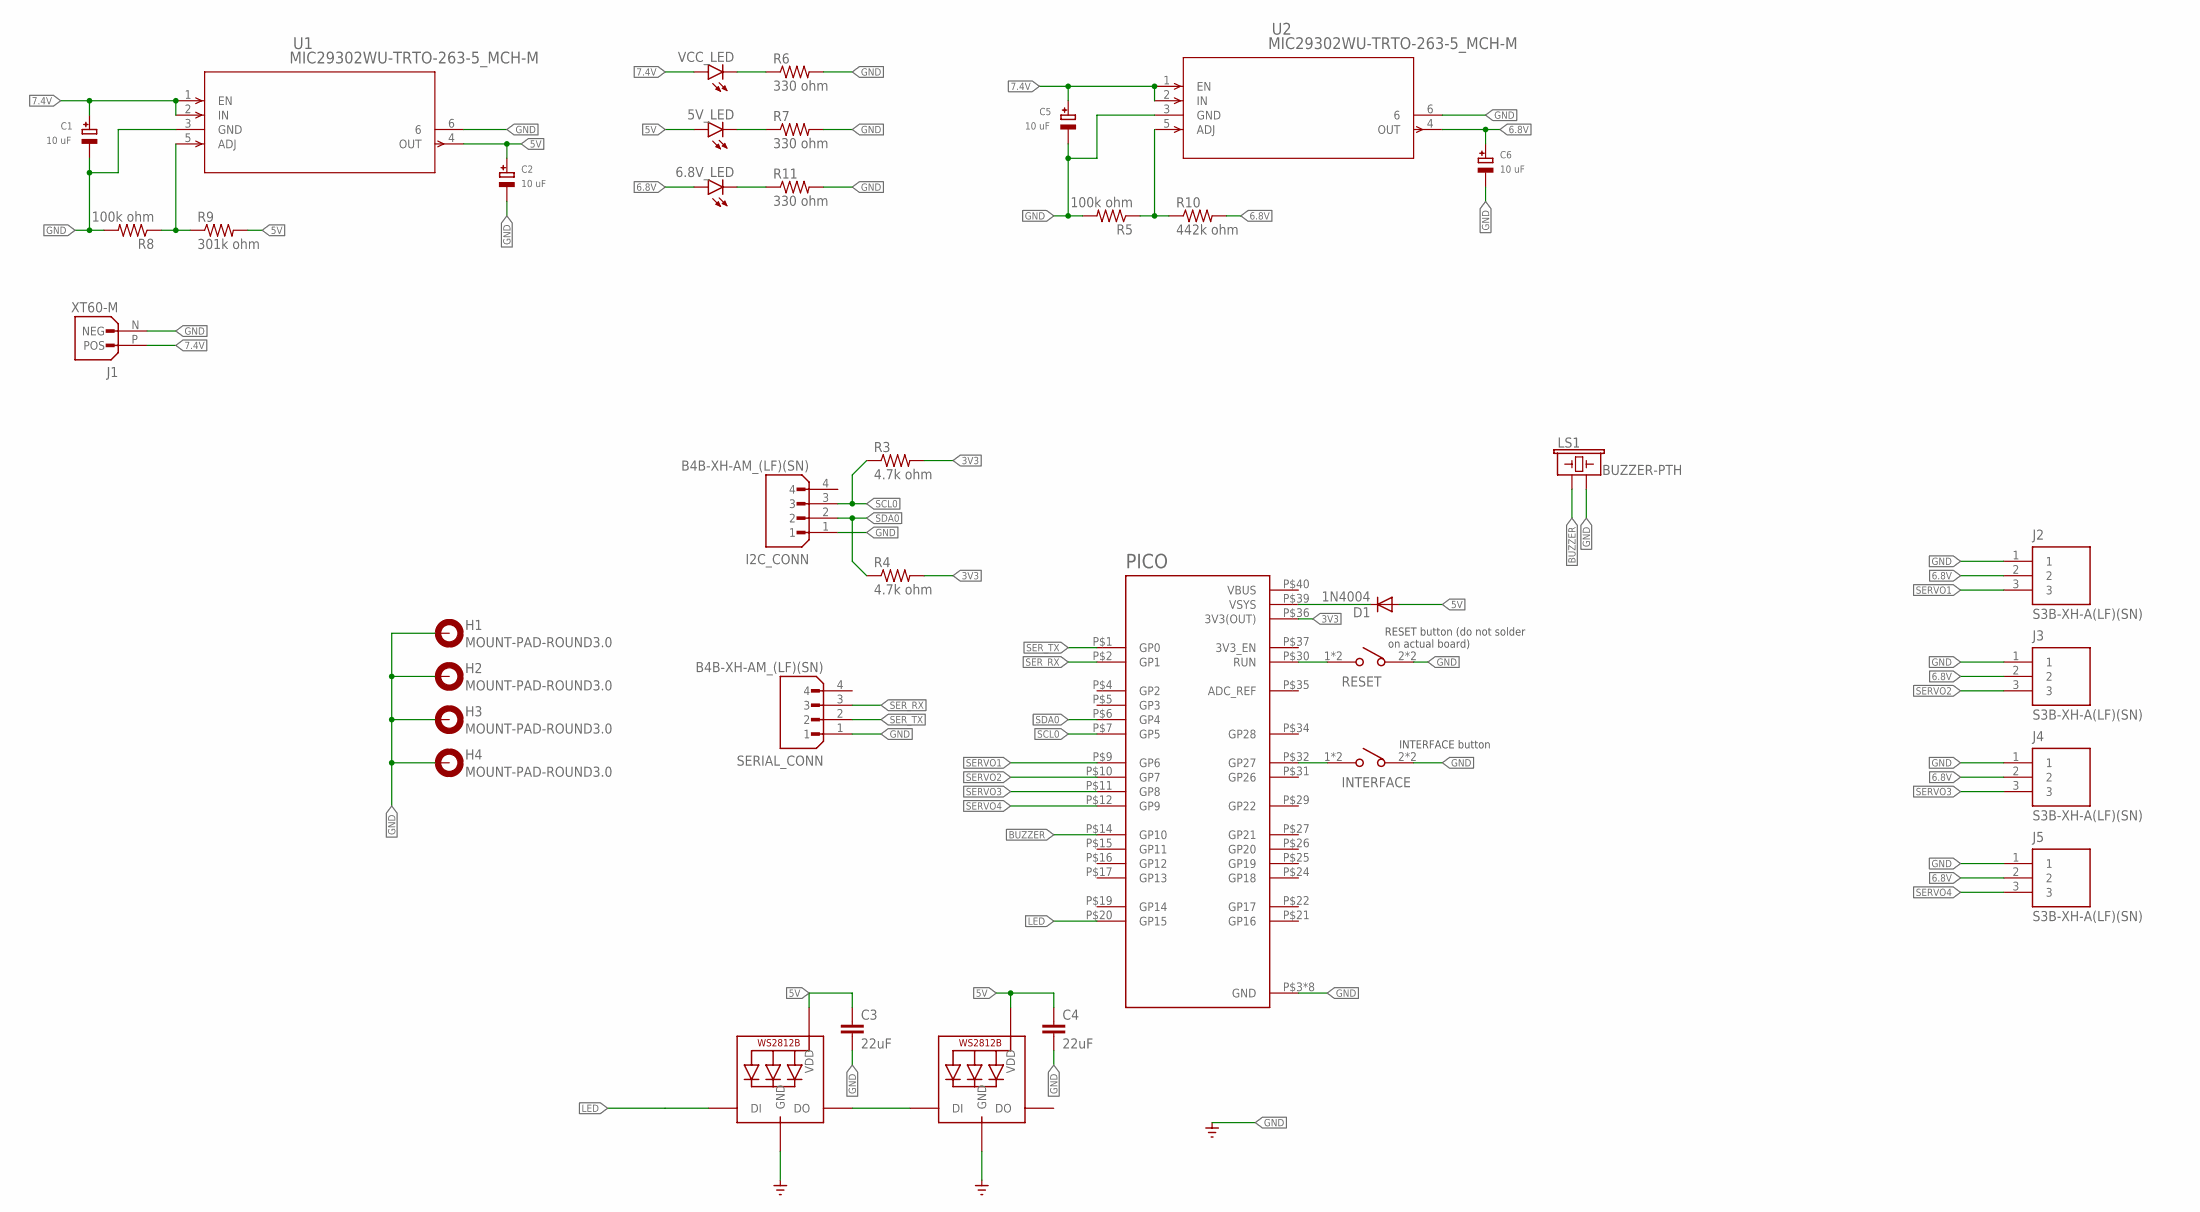
[picture p63: schematic motor_controller_2_1.sch]

Parts:
5V_LED, 6.8V_LED: LEDCHIPLED_1206; CHIPLED_1206
C1, C2, C5, C6: 10 uF; EIA3216-18/A-W
C3, C4: 22uF; 0805
D1: 1N4004; DO41-10
H1, H2, H3, H4: MOUNT-PAD-ROUND3.0; 3,0-PAD
I2C_CONN: B4B-XH-AM_(LF)(SN); JST_B4B-XH-AM_(LF)(SN)
INTERFACE: TS04-66-95-BK-100-SMT; SW_TS04-66-95-BK-100-SMT
J1: XT60-M; AMASS_XT60-M
J2, J3, J4, J5: S3B-XH-A(LF)(SN); JST_S3B-XH-A(LF)(SN)
LED1, LED2: WS2812B3535; LED3535
LS1: BUZZER-PTH; BUZZER-12MM
PICO: RASPBERRY_PICO-NO_DEBUG; PICO-PKG-NO_DEBUG
R3, R4: 4.7k ohm; R0805
R5, R8: 100k ohm; R0805
R6, R7, R11: 330 ohm; R0805
R9: 301k ohm; R0805
R10: 442k ohm; R0805
RESET: TS04-66-95-BK-100-SMT; SW_TS04-66-95-BK-100-SMT
SERIAL_CONN: B4B-XH-AM_(LF)(SN); JST_B4B-XH-AM_(LF)(SN)
U1, U2: MIC29302WU-TRTO-263-5_MCH-M; TO-263-5_MCH-M
VCC_LED: LEDCHIPLED_1206; CHIPLED_1206

Connections:
3V3: PICO.P$36 (3V3(OUT)), R3.2, R4.2
5V: 5V_LED.A, C2.+, C3.1, C4.1, D1.A, LED1.2 (VDD), LED2.2 (VDD), R9.2, U1.4 (OUT)
6.8V: 6.8V_LED.A, C6.+, J2.2, J3.2, J4.2, J5.2, R10.2, U2.4 (OUT)
7.4V: C1.+, C5.+, J1.P (POS), U1.1 (EN), U1.2 (IN), U2.1 (EN), U2.2 (IN), VCC_LED.A
BUZZER: LS1.+ (1), PICO.P$14 (GP10)
GND: C1.-, C2.-, C3.2, C4.2, C5.-, C6.-, H1.B3,0, H2.B3,0, H3.B3,0, H4.B3,0, I2C_CONN.1, INTERFACE.2 (4), INTERFACE.4, J1.N (NEG), J2.1, J3.1, J4.1, J5.1, LED1.4 (GND), LED2.4 (GND), LS1.- (2), PICO.P$3 (GND), PICO.P$8 (GND), PICO.P$13 (GND), PICO.P$18 (GND), PICO.P$23 (GND), PICO.P$28 (GND), PICO.P$33 (GND), PICO.P$38 (GND), R5.2, R6.2, R7.2, R8.2, R11.2, RESET.2 (4), RESET.4, SERIAL_CONN.1, U1.3 (GND), U1.6, U2.3 (GND), U2.6
LED: LED1.1 (DI), PICO.P$20 (GP15)
unnamed: D1.C, PICO.P$39 (VSYS)
unnamed: PICO.P$30 (RUN), RESET.1 (2), RESET.3 (2)
unnamed: INTERFACE.1 (2), INTERFACE.3 (2), PICO.P$32 (GP27)
unnamed: R5.1, R10.1, U2.5 (ADJ)
unnamed: LED1.3 (DO), LED2.1 (DI)
unnamed: 6.8V_LED.C, R11.1
unnamed: R6.1, VCC_LED.C
unnamed: 5V_LED.C, R7.1
unnamed: R8.1, R9.1, U1.5 (ADJ)
SCL0: I2C_CONN.3, PICO.P$7 (GP5), R3.1
SDA0: I2C_CONN.2, PICO.P$6 (GP4), R4.1
SERVO1: J2.3, PICO.P$9 (GP6)
SERVO2: J3.3, PICO.P$10 (GP7)
SERVO3: J4.3, PICO.P$11 (GP8)
SERVO4: J5.3, PICO.P$12 (GP9)
SER_RX: PICO.P$2 (GP1), SERIAL_CONN.3
SER_TX: PICO.P$1 (GP0), SERIAL_CONN.2
VBUS: PICO.P$40 (VBUS)

Notes on the sheet:
RESET button (do not solder on actual board)
INTERFACE button
