IITB-Rocket-Team-Avionics/FLYTE/Eagle files/FLYTE 2.1/motor_controller_2_1.brd

## EAGLE design Eagle files/FLYTE 2.1/motor_controller_2_1.brd (continued)

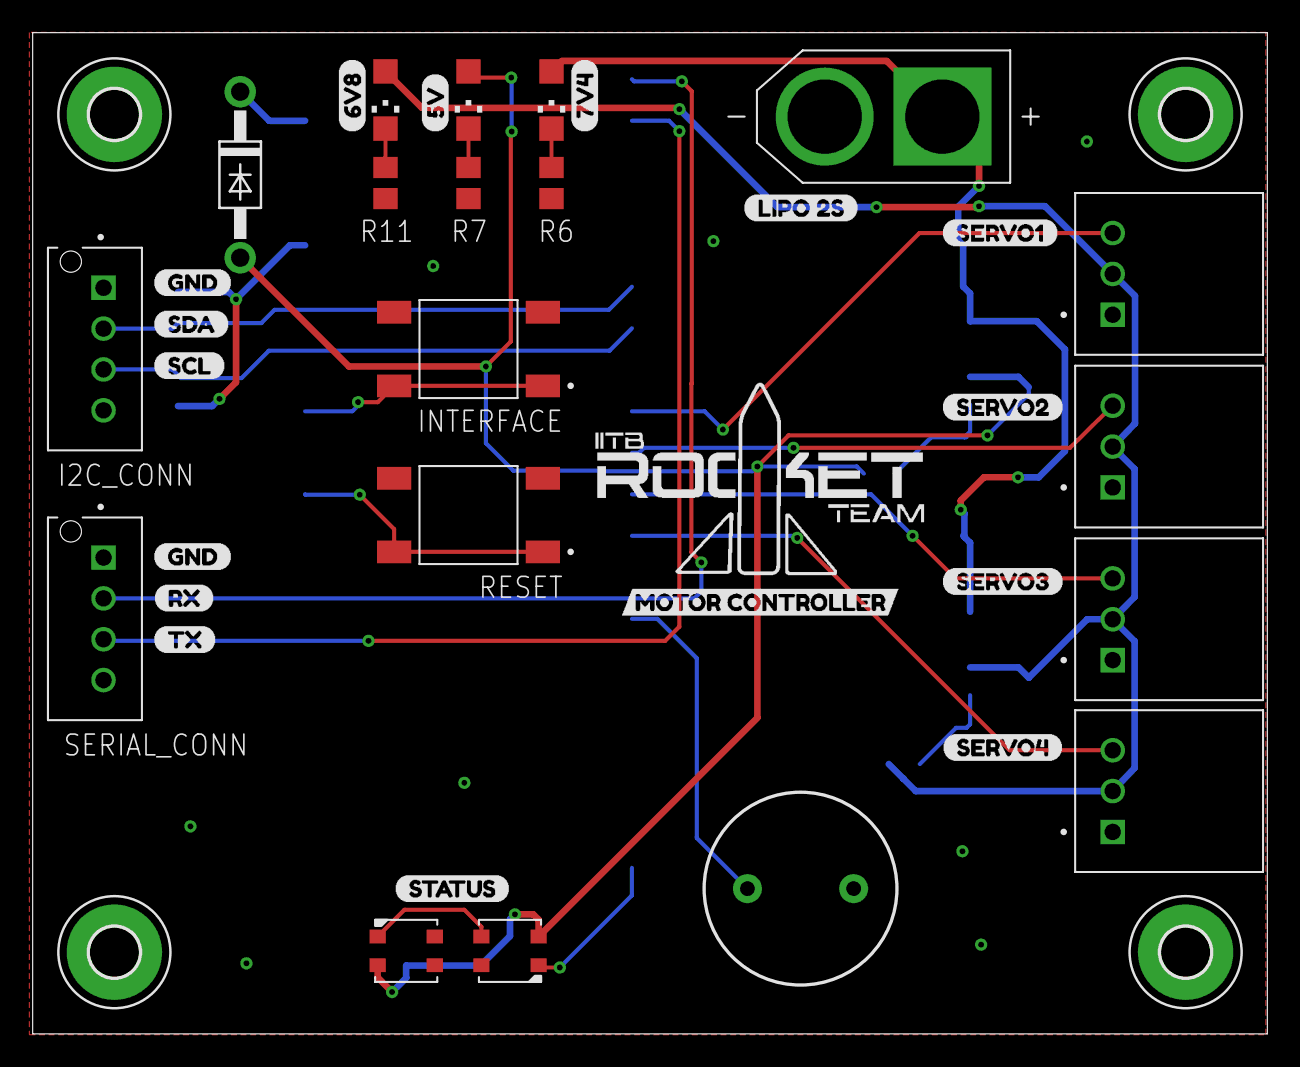
[picture p64: board motor_controller_2_1.brd from above]

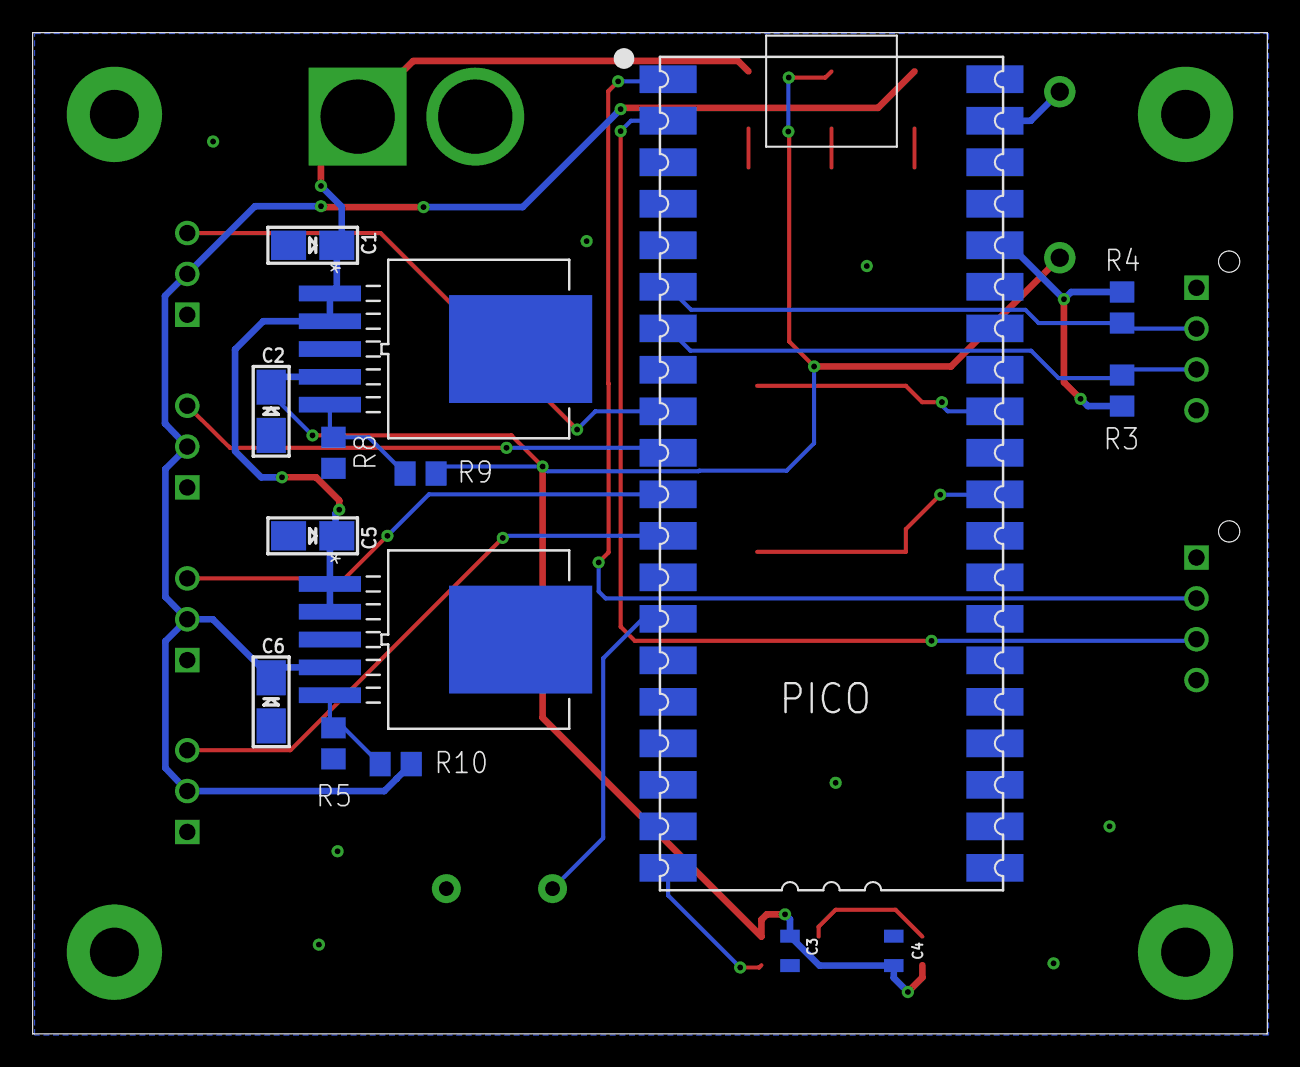
[picture p65: board motor_controller_2_1.brd from below]

Board: 2 copper layers, 75.6 x 61.3 mm, 54 parts (15 on the bottom side), 24 nets.

Other parts of the board:
U$1: SERVO10
U$2: SERVO20
U$3: SERVO30
U$4: SERVO40
U$5: SDA0
U$6: SCL0
U$7, U$8: GND0
U$9: RX0
U$10: TX0
U$11: LIPO_2S0
U$12: 5V0
U$13: 7V40
U$14: 6V80
U$15: STATUS0
U$16: MOTOR_CONTROLLER0
