IITB-Rocket-Team-Avionics/FLYTE/Eagle files/FLYTE 2.1/reefingBrd.brd

## EAGLE design Eagle files/FLYTE 2.1/reefingBrd.brd (2024-05-11)

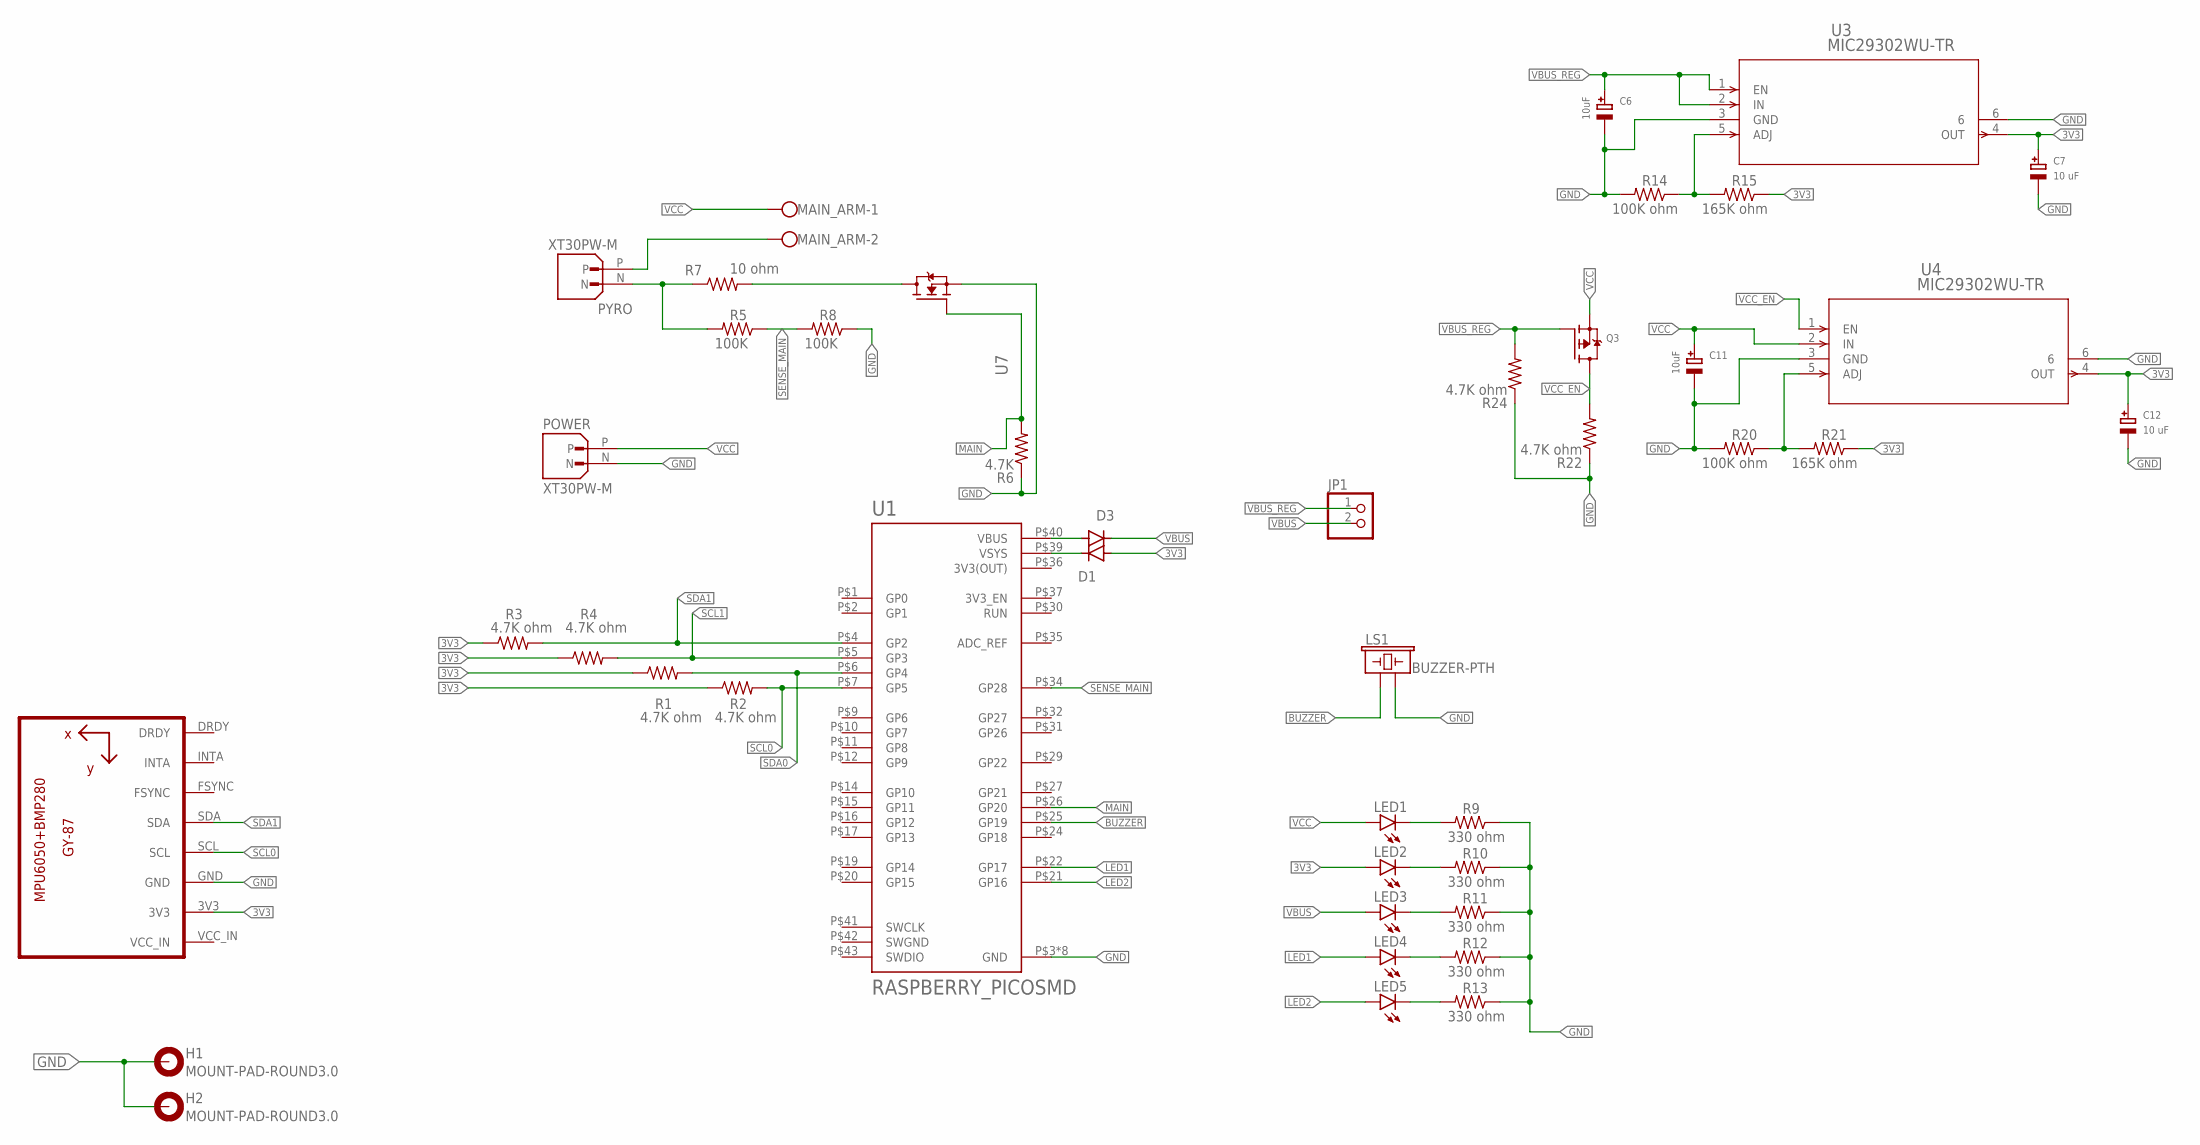
[picture p66: schematic reefingBrd.sch]

Parts:
C6, C11: 10uF; EIA3216-18/A-W
C7, C12: 10 uF; EIA3216-18/A-W
D1, D3: 1N4004; DO41-10
H1, H2: MOUNT-PAD-ROUND3.0; 3,0-PAD
JP1: PINHD-1X2; 1X02
LED1, LED2, LED3, LED4, LED5: LEDCHIPLED_1206; CHIPLED_1206
LS1: BUZZER-PTH; BUZZER-12MM
MAIN_ARM: W237-102
POWER: XT30PW-M; AMASS_XT30PW-M
PYRO: XT30PW-M; AMASS_XT30PW-M
Q3: MOSFET-PWIDE; SOT23-WIDE
R1, R2, R3, R4, R22, R24: 4.7K ohm; R0805
R5, R8: 100K; R0805
R6: 4.7K; R0805
R7: 10 ohm; 0207/10
R9, R10, R11, R12, R13: 330 ohm; R0805
R14, R20: 100K ohm; R0805
R15, R21: 165K ohm; R0805
U1: RASPBERRY_PICOSMD; PICO-PKG-SMD
U2: GY-521MPU6050; GY-521
U3, U4: MIC29302WU-TR; TO-263-5_MCH
U7: IRF540NPBF; TO254P1054X469X1930-3

Connections:
3V3: C7.+, C12.+, D1.A, LED2.A, R1.1, R2.1, R3.1, R4.1, R15.1, R21.1, U2.3V3, U3.4 (OUT), U4.4 (OUT)
3V3(OUT): U1.P$36 (3V3(OUT))
BUZZER: LS1.+ (1), U1.P$25 (GP19)
GND: C6.-, C7.-, C11.-, C12.-, H1.B3,0, H2.B3,0, LS1.- (2), POWER.N, R6.1, R8.1, R9.1, R10.1, R11.1, R12.1, R13.1, R14.2, R20.2, R22.1, R24.1, U1.P$3 (GND), U1.P$8 (GND), U1.P$13 (GND), U1.P$18 (GND), U1.P$23 (GND), U1.P$28 (GND), U1.P$33 (GND), U1.P$38 (GND), U2.GND, U3.3 (GND), U3.6, U4.3 (GND), U4.6, U7.3 (S)
LED1: LED4.A, U1.P$22 (GP17)
LED2: LED5.A, U1.P$21 (GP16)
MAIN: R6.2, U1.P$26 (GP20), U7.1 (G)
unnamed: D1.C, U1.P$39 (VSYS)
unnamed: D3.A, U1.P$40 (VBUS)
unnamed: R20.1, R21.2, U4.5 (ADJ)
unnamed: PYRO.N, R5.2, R7.1
unnamed: R7.2, U7.2 (D)
unnamed: MAIN_ARM.2, PYRO.P
unnamed: R14.1, R15.2, U3.5 (ADJ)
unnamed: LED1.C, R9.2
unnamed: LED2.C, R10.2
unnamed: LED3.C, R11.2
unnamed: LED4.C, R12.2
unnamed: LED5.C, R13.2
SCL0: R2.2, U1.P$7 (GP5), U2.SCL
SCL1: R4.2, U1.P$5 (GP3)
SDA0: R1.2, U1.P$6 (GP4)
SDA1: R3.2, U1.P$4 (GP2), U2.SDA
SENSE_MAIN: R5.1, R8.2, U1.P$34 (GP28)
SWGND: U1.P$42 (SWGND)
VBUS: D3.C, JP1.2, LED3.A
VBUS_REG: C6.+, JP1.1, Q3.1 (G), R24.2, U3.1 (EN), U3.2 (IN)
VCC: C11.+, LED1.A, MAIN_ARM.1, POWER.P, Q3.2 (S), U4.2 (IN)
VCC_EN: Q3.3 (D), R22.2, U4.1 (EN)

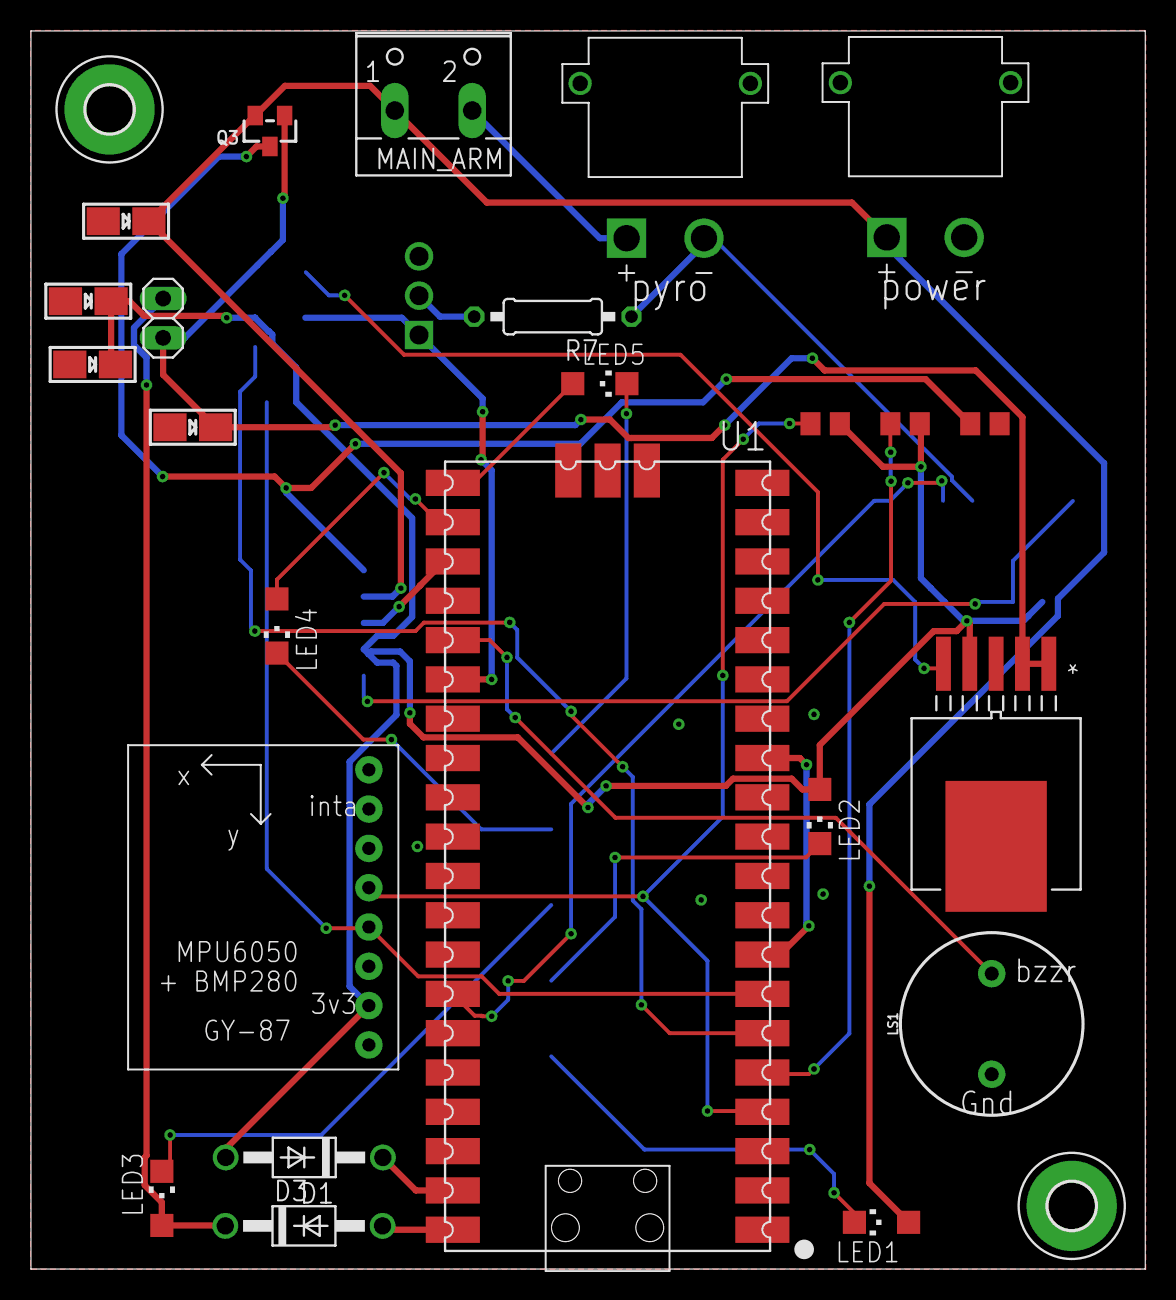
[picture p67: board reefingBrd.brd from above]

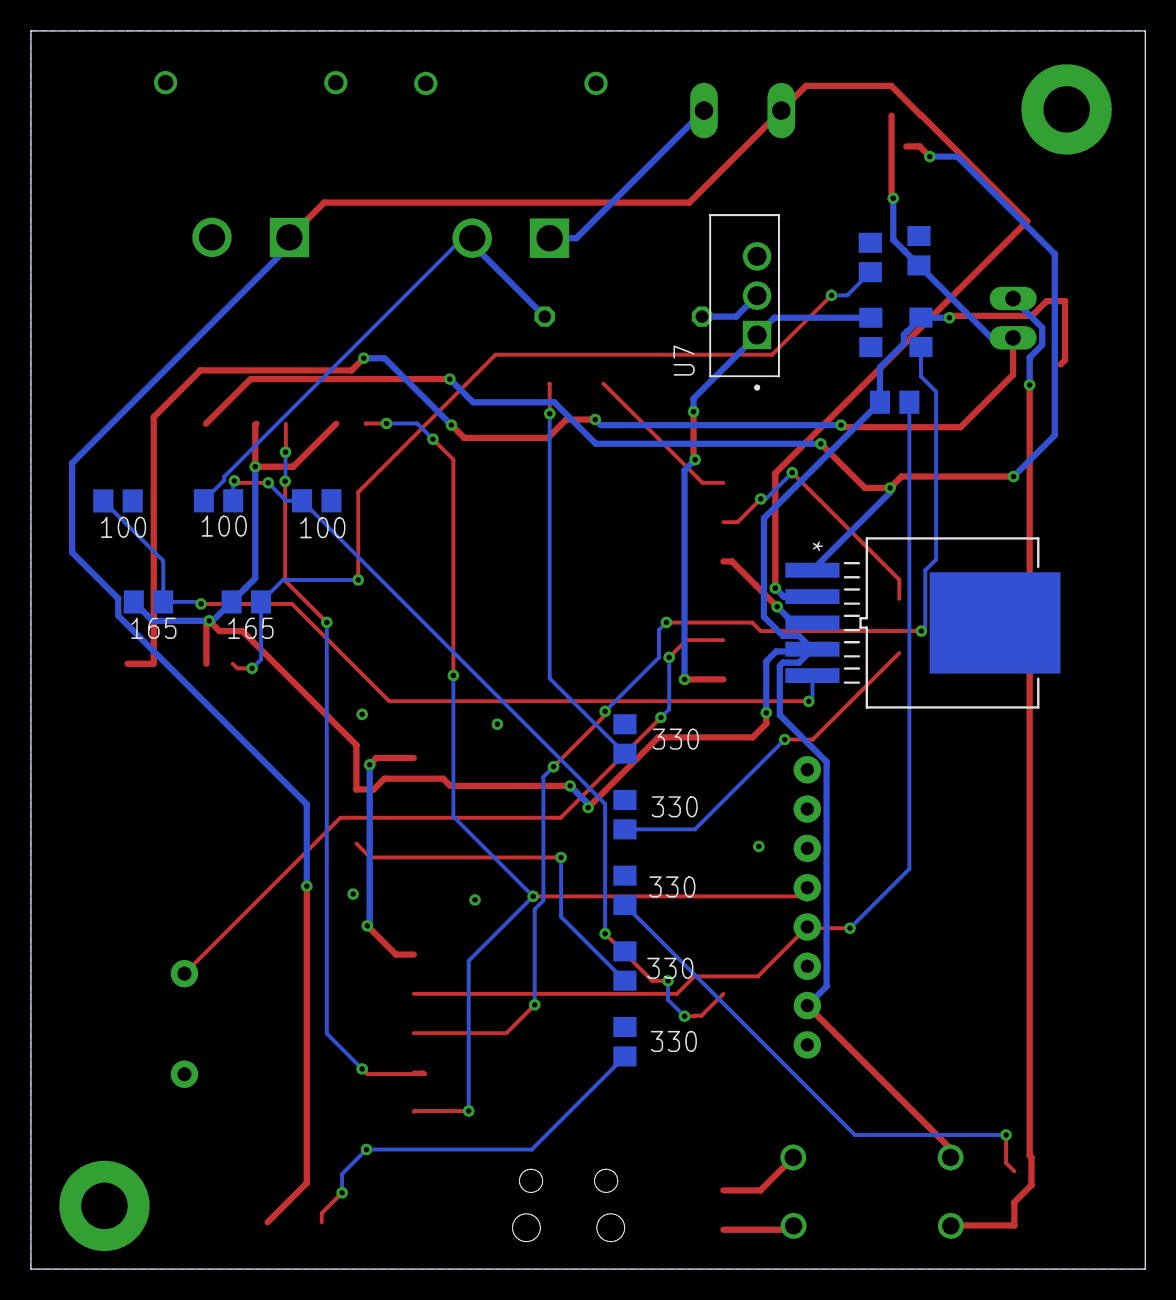
[picture p68: board reefingBrd.brd from below]

Board: 2 copper layers, 72.0 x 80.0 mm, 43 parts (17 on the bottom side), 27 nets.
