IITB-Rocket-Team-Avionics/FLYTE/Eagle files/FLYTE 2.1/Payload.brd

## EAGLE design Eagle files/FLYTE 2.1/Payload.brd (2024-05-04)

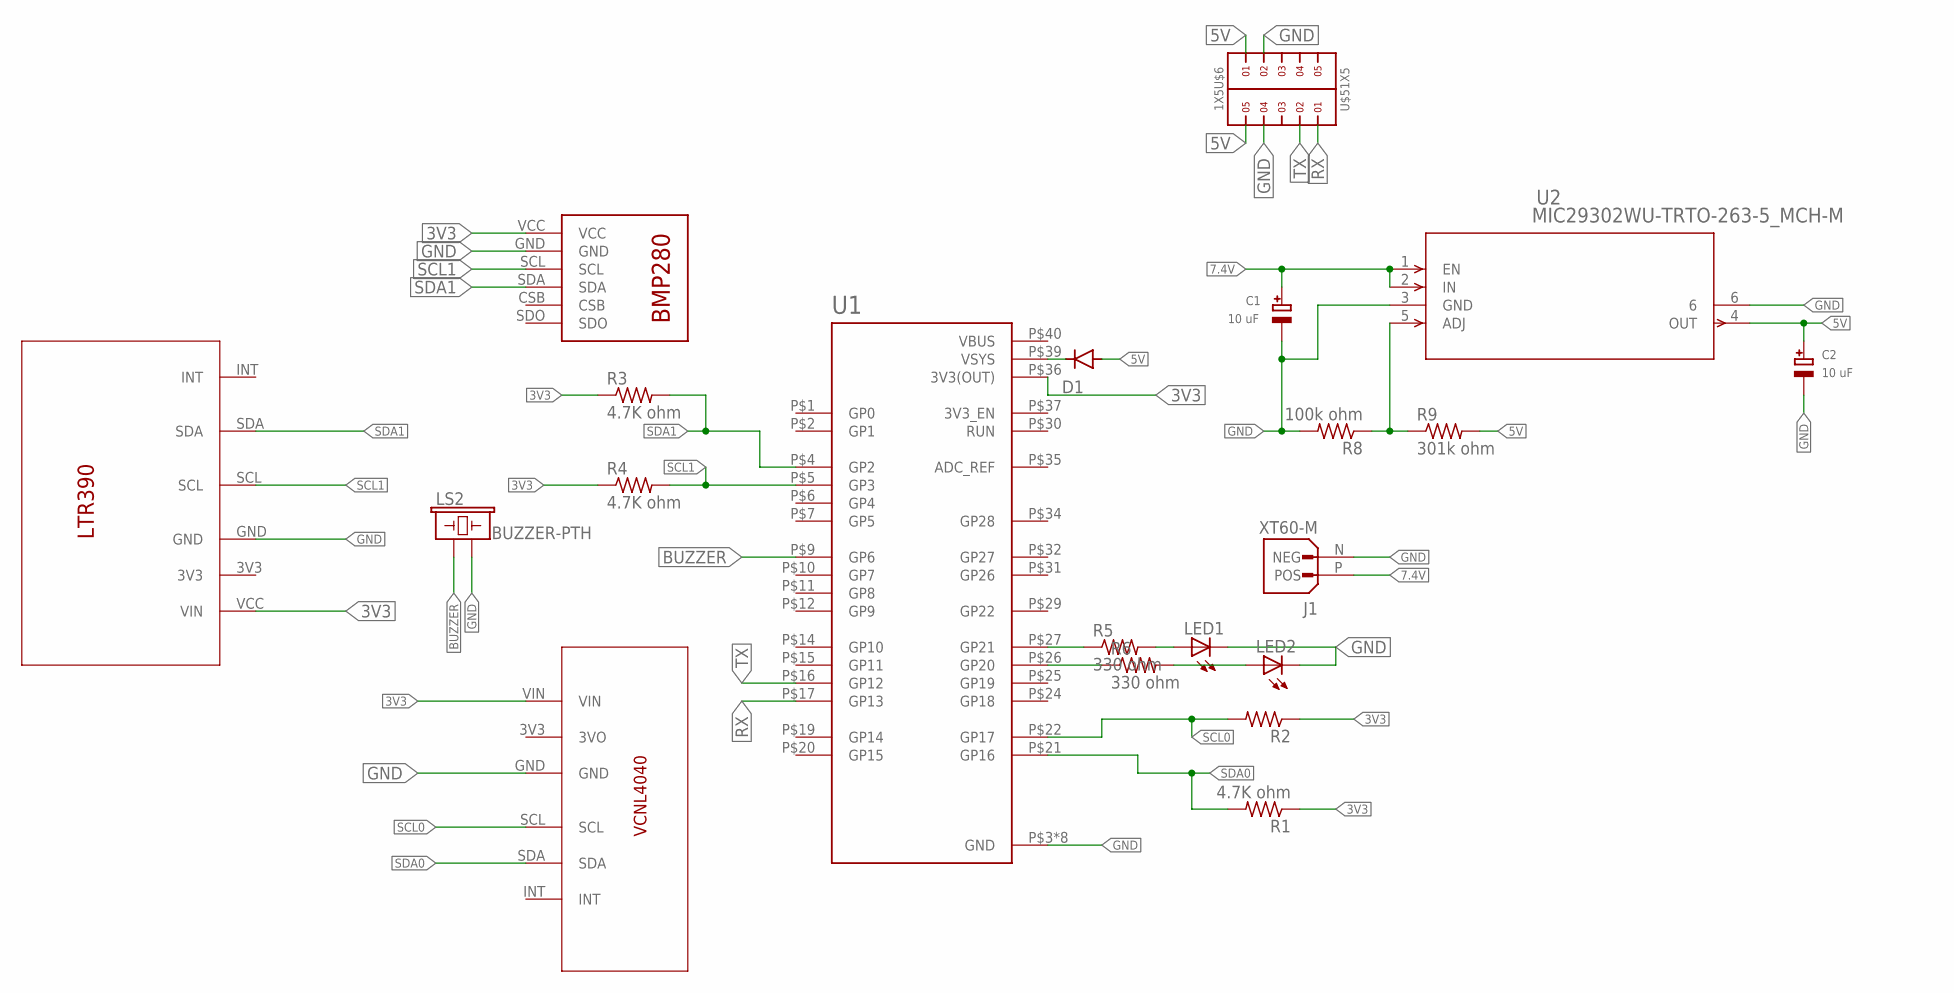
[picture p69: schematic Payload.sch]

Parts:
C1, C2: 10 uF; EIA3216-18/A-W
D1: 1N4004; DO41-10
J1: XT60-M; AMASS_XT60-M
LED1, LED2: LEDCHIPLED_1206; CHIPLED_1206
LS2: BUZZER-PTH; BUZZER-12MM
R1, R2, R3, R4: 4.7K ohm; R0805
R5, R6: 330 ohm; R0805
R8: 100k ohm; R0805
R9: 301k ohm; R0805
U1: RASPBERRY_PICO-NO_DEBUG; PICO-PKG-NO_DEBUG
U2: MIC29302WU-TRTO-263-5_MCH-M; TO-263-5_MCH-M
U$1: VCNL4040
U$3: BMP280
U$4: LTR390
U$5, U$6: 1X5

Connections:
3V3: R1.1, R2.1, R3.1, R4.1, U1.P$36 (3V3(OUT)), U$1.VIN, U$3.VCC, U$4.VCC (VIN)
5V: C2.+, D1.A, R9.2, U2.4 (OUT), U$5.5, U$6.1
7.4V: C1.+, J1.P (POS), U2.1 (EN), U2.2 (IN)
BUZZER: LS2.+ (1), U1.P$9 (GP6)
GND: C1.-, C2.-, J1.N (NEG), LED1.C, LED2.C, LS2.- (2), R8.2, U1.P$3 (GND), U1.P$8 (GND), U1.P$13 (GND), U1.P$18 (GND), U1.P$23 (GND), U1.P$28 (GND), U1.P$33 (GND), U1.P$38 (GND), U2.3 (GND), U2.6, U$1.GND, U$3.GND, U$4.GND, U$5.4, U$6.2
unnamed: D1.C, U1.P$39 (VSYS)
unnamed: R5.1, U1.P$27 (GP21)
unnamed: LED2.A, R6.2
unnamed: LED1.A, R5.2
unnamed: R6.1, U1.P$26 (GP20)
unnamed: R8.1, R9.1, U2.5 (ADJ)
RX: U1.P$17 (GP13), U$5.1
SCL0: R2.2, U1.P$22 (GP17), U$1.SCL
SCL1: R4.2, U1.P$5 (GP3), U$3.SCL, U$4.SCL
SDA0: R1.2, U1.P$21 (GP16), U$1.SDA
SDA1: R3.2, U1.P$4 (GP2), U$3.SDA, U$4.SDA
TX: U1.P$16 (GP12), U$5.2
VBUS: U1.P$40 (VBUS)

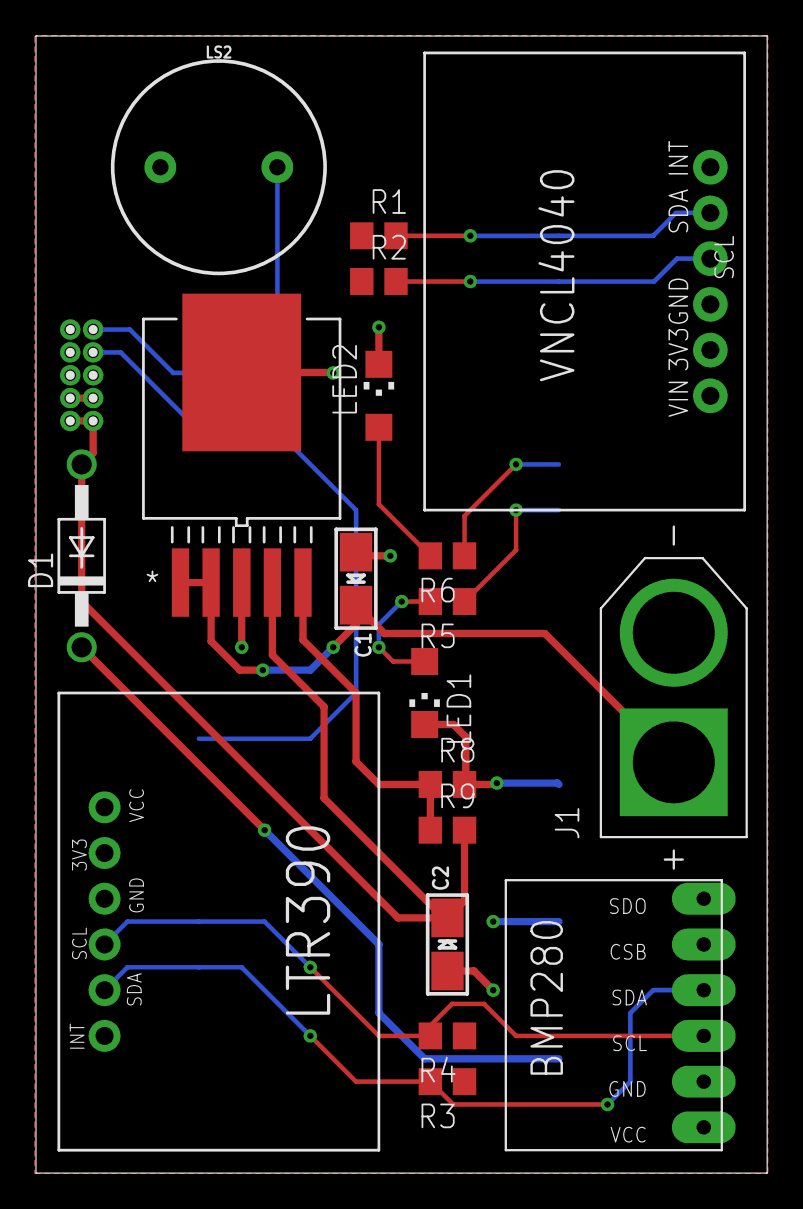
[picture p70: board Payload.brd from above]

Board: 2 copper layers, 40.6 x 63.2 mm, 22 parts (1 on the bottom side), 17 nets.
