IITB-Rocket-Team-Avionics/FLYTE/Eagle files/FLYTE 2.1/FLYTE-v2_1.brd

## EAGLE design Eagle files/FLYTE 2.1/FLYTE-v2_1.brd (2024-05-10)

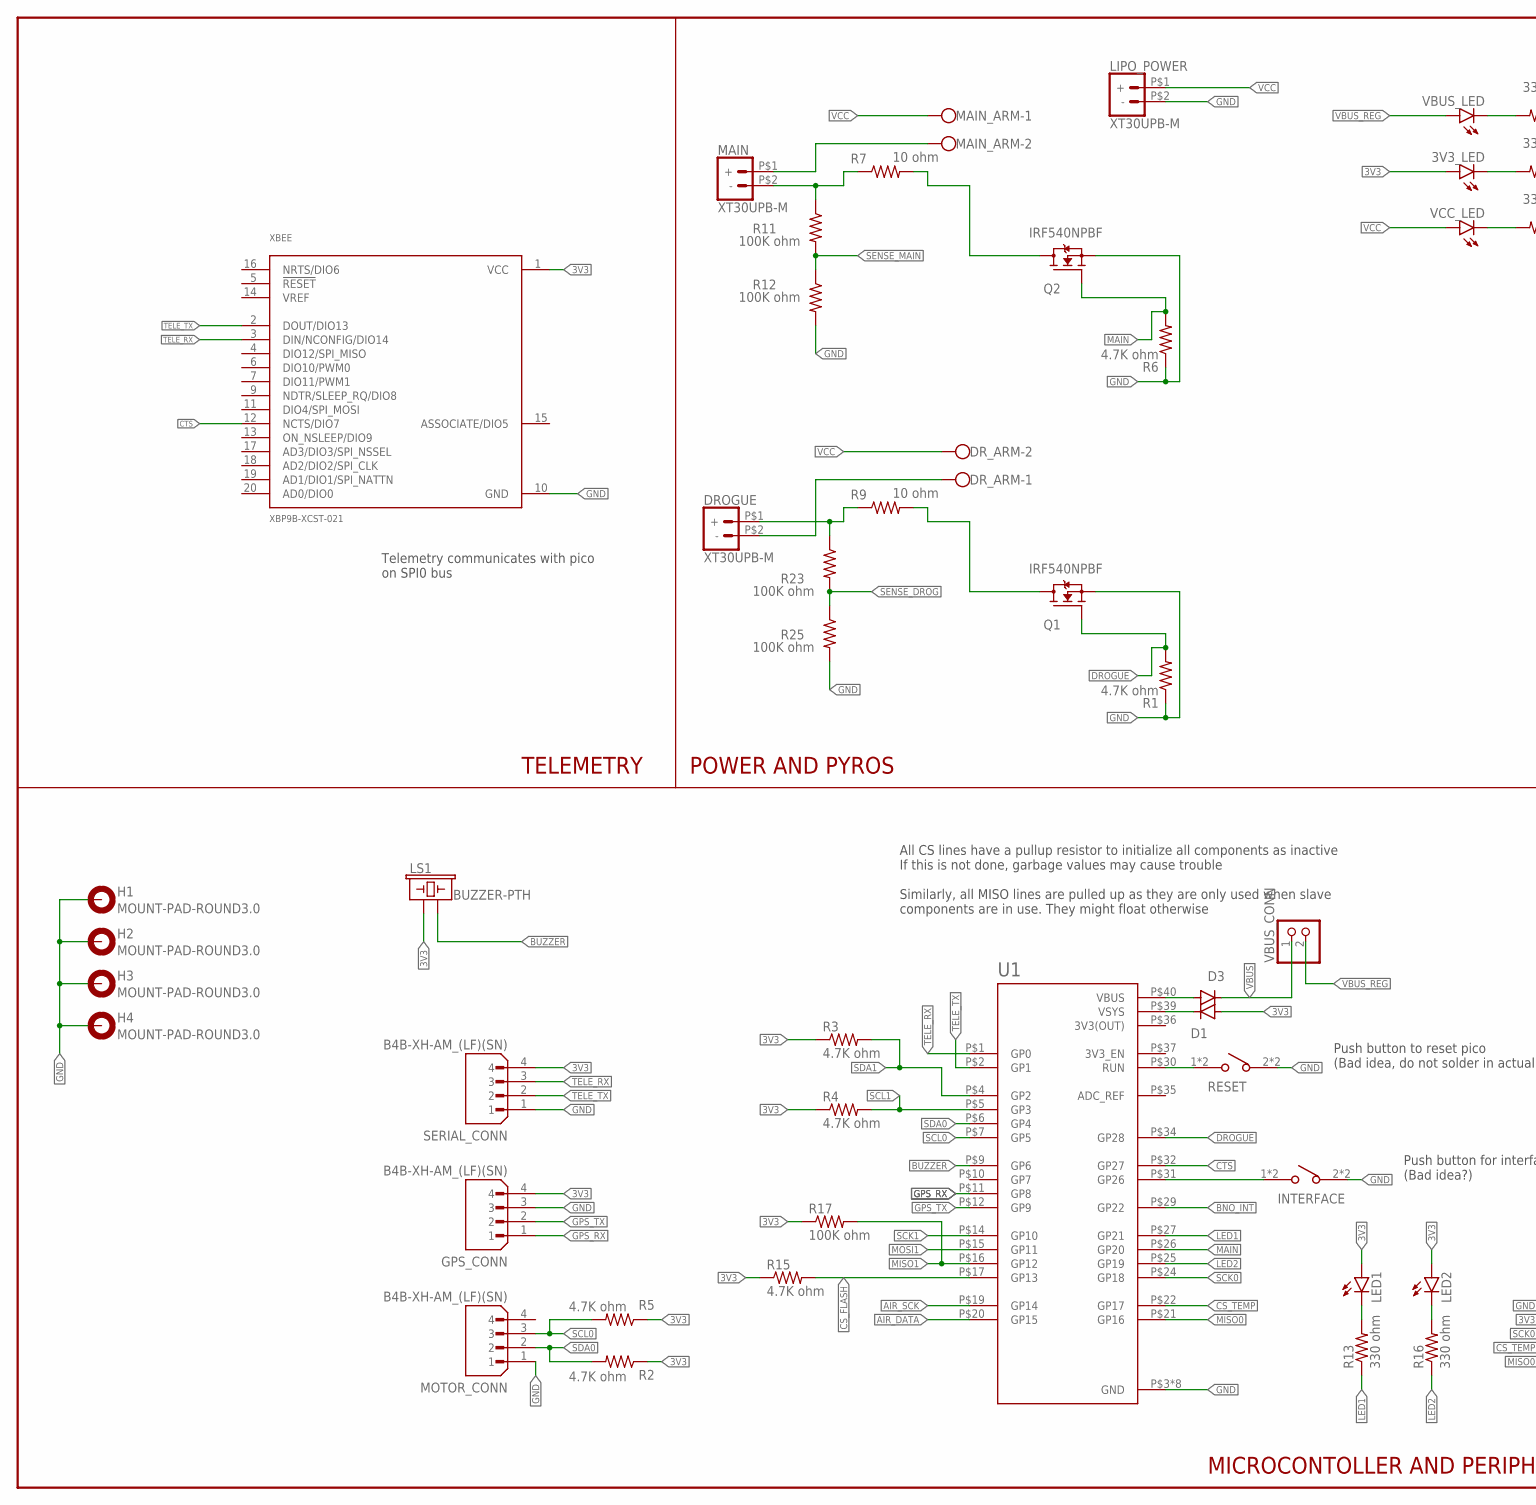
[picture p71: schematic FLYTE-v2_1.sch, part in row 1, column 1]

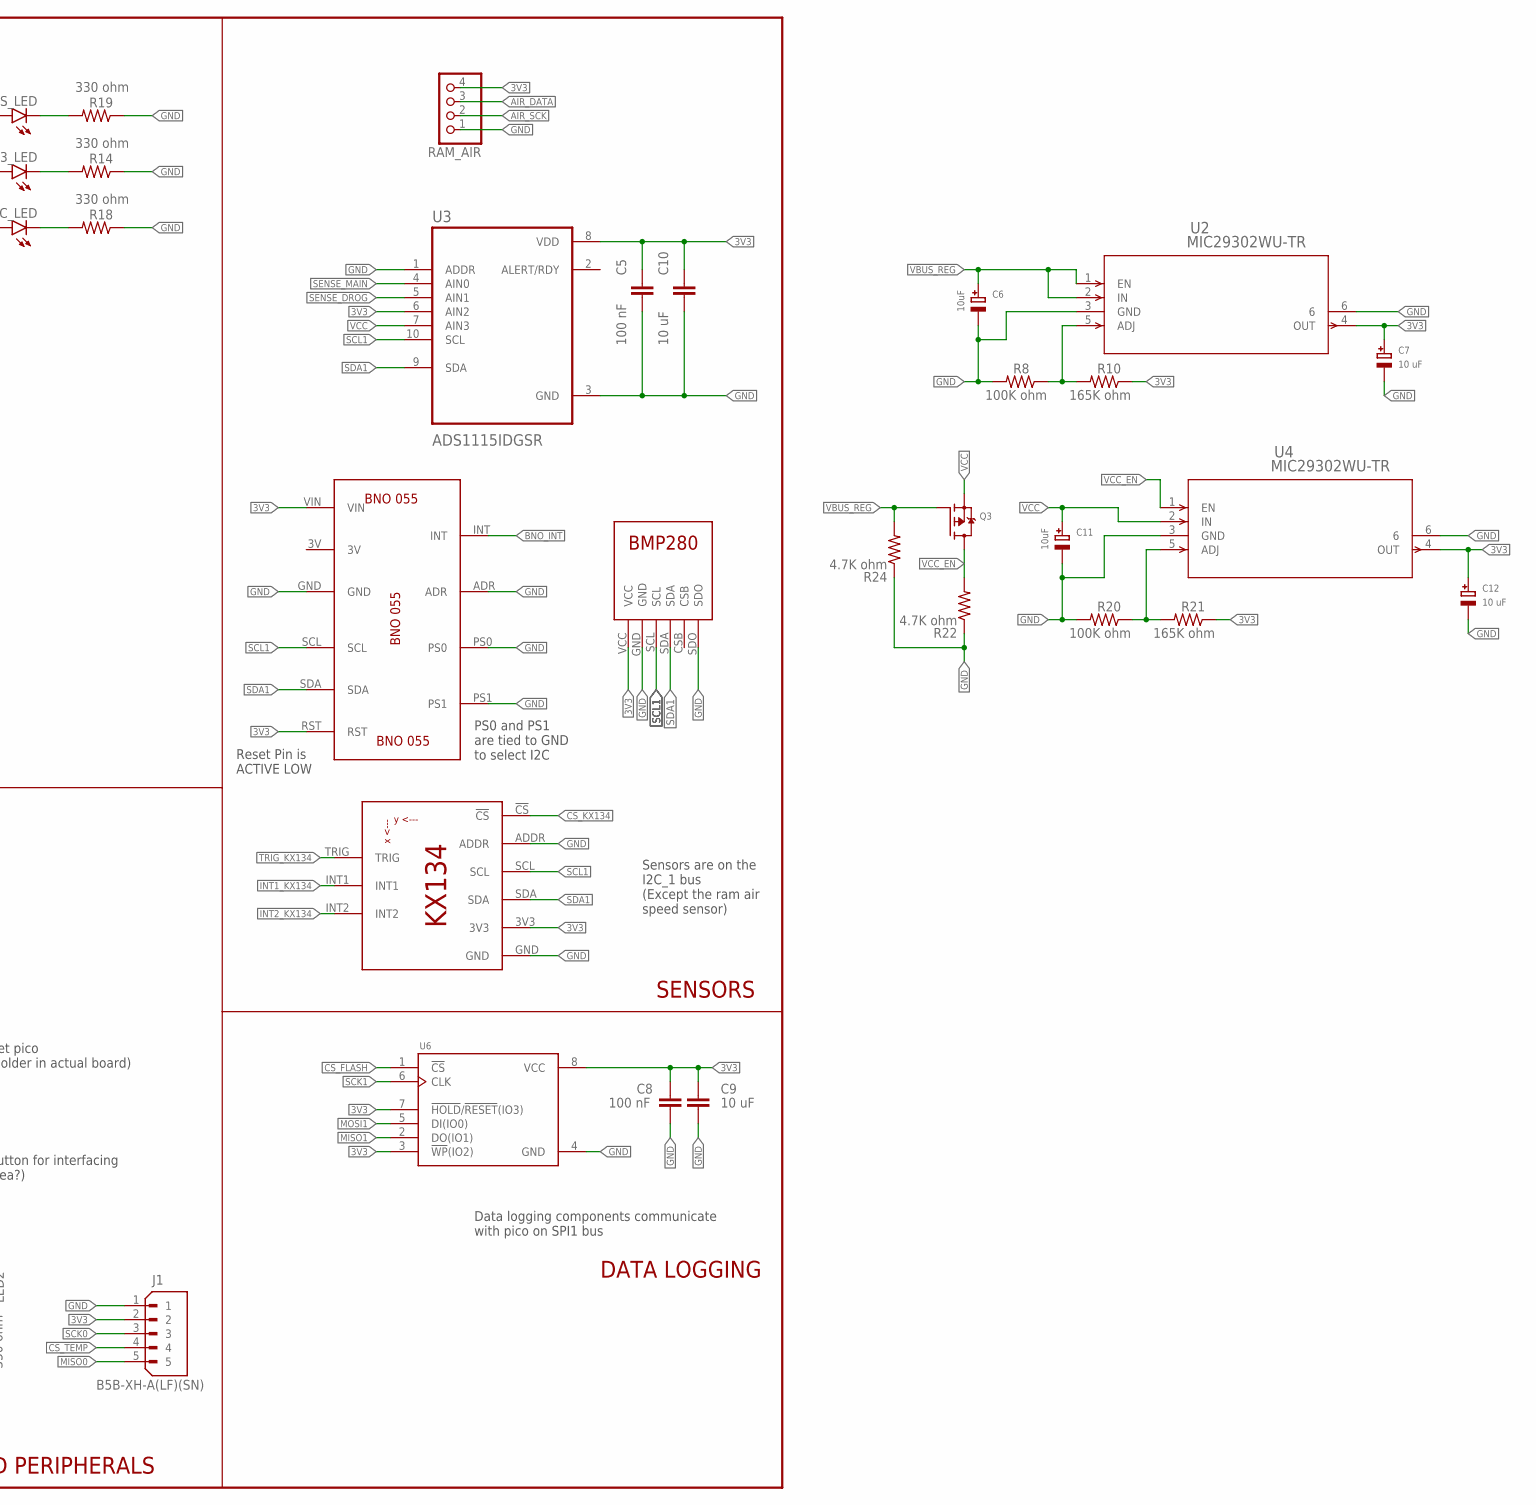
[picture p72: schematic FLYTE-v2_1.sch, part in row 1, column 2]

Parts:
3V3_LED: LEDCHIPLED_1206; CHIPLED_1206
C5, C8: 100 nF; 0805
C6, C11: 10uF; EIA3216-18/A-W
C7, C12: 10 uF; EIA3216-18/A-W
C9, C10: 10 uF; 0805
D1, D3: 1N4004; DO41-10
DROGUE: XT30UPB-M
DR_ARM: W237-102
GPS_CONN: B4B-XH-AM_(LF)(SN); JST_B4B-XH-AM_(LF)(SN)
H1, H2, H3, H4: MOUNT-PAD-ROUND3.0; 3,0-PAD
INTERFACE: TS04-66-95-BK-100-SMT; SW_TS04-66-95-BK-100-SMT
J1: B5B-XH-A(LF)(SN); JST_B5B-XH-A(LF)(SN)
LED1, LED2: LEDCHIPLED_1206; CHIPLED_1206
LIPO_POWER: XT30UPB-M
LS1: BUZZER-PTH; BUZZER-12MM
MAIN: XT30UPB-M
MAIN_ARM: W237-102
MOTOR_CONN: B4B-XH-AM_(LF)(SN); JST_B4B-XH-AM_(LF)(SN)
Q1, Q2: IRF540NPBF; TO254P1054X469X1930-3
Q3: MOSFET-PWIDE; SOT23-WIDE
R1, R2, R3, R4, R5, R6, R15, R22, R24: 4.7K ohm; R0805
R7, R9: 10 ohm; 0207/10
R8, R11, R12, R17, R20, R23, R25: 100K ohm; R0805
R10, R21: 165K ohm; R0805
R13, R14, R16, R18, R19: 330 ohm; R0805
RAM_AIR: PINHD-1X4; 1X04
RESET: TS04-66-95-BK-100-SMT; SW_TS04-66-95-BK-100-SMT
SERIAL_CONN: B4B-XH-AM_(LF)(SN); JST_B4B-XH-AM_(LF)(SN)
U1: RASPBERRY_PICO-NO_DEBUG; PICO-PKG-NO_DEBUG
U2, U4: MIC29302WU-TR; TO-263-5_MCH
U3: ADS1115IDGSR; SOP50P490X110-10N
U6: W25Q32JVSSIQ; SOIC127P790X216-8N
U$1: BMP280
U$2: KX134-BREAKOUT
U$4: BNO055
VBUS_CONN: PINHD-1X2; 1X02
VBUS_LED: LEDCHIPLED_1206; CHIPLED_1206
VCC_LED: LEDCHIPLED_1206; CHIPLED_1206
XBEE: XBP9B-XCST-021; DIP2200W51P200L3294H279Q20P

Connections:
3V3: 3V3_LED.A, C5.1, C7.+, C8.2, C9.2, C10.1, C12.+, D1.A, GPS_CONN.4, J1.2, LED1.A, LED2.A, LS1.+ (1), R2.1, R3.1, R4.1, R5.1, R10.1, R15.1, R17.1, R21.1, RAM_AIR.4, SERIAL_CONN.4, U2.4 (OUT), U3.6 (AIN2), U3.8 (VDD), U4.4 (OUT), U6.3 (!WP!(IO2)), U6.7 (!HOLD!/!RESET!(IO3)), U6.8 (VCC), U$1.VCC, U$2.3V3, U$4.RST, U$4.VIN, XBEE.1 (VCC)
3V3(OUT): U1.P$36 (3V3(OUT))
AIR_DATA: RAM_AIR.3, U1.P$20 (GP15)
AIR_SCK: RAM_AIR.2, U1.P$19 (GP14)
BNO_INT: U1.P$29 (GP22), U$4.INT
BUZZER: LS1.- (2), U1.P$9 (GP6)
CS_FLASH: R15.2, U1.P$17 (GP13), U6.1 (!CS)
CS_KX134: U$2.!CS
CS_TEMP: J1.4, U1.P$22 (GP17)
CTS: U1.P$32 (GP27), XBEE.12 (NCTS/DIO7)
DROGUE: Q1.1 (G), R1.2, U1.P$34 (GP28)
GND: C5.2, C6.-, C7.-, C8.1, C9.1, C10.2, C11.-, C12.-, GPS_CONN.3, H1.B3,0, H2.B3,0, H3.B3,0, H4.B3,0, INTERFACE.2 (4), INTERFACE.4, J1.1, LIPO_POWER.P$2 (-), MOTOR_CONN.1, Q1.3 (S), Q2.3 (S), R1.1, R6.1, R8.2, R12.2, R14.1, R18.1, R19.1, R20.2, R22.1, R24.1, R25.2, RAM_AIR.1, RESET.2 (4), RESET.4, SERIAL_CONN.1, U1.P$3 (GND), U1.P$8 (GND), U1.P$13 (GND), U1.P$18 (GND), U1.P$23 (GND), U1.P$28 (GND), U1.P$33 (GND), U1.P$38 (GND), U2.3 (GND), U2.6, U3.1 (ADDR), U3.3 (GND), U4.3 (GND), U4.6, U6.4 (GND), U$1.GND, U$1.SDO, U$2.ADDR, U$2.GND, U$4.ADR, U$4.GND, U$4.PS0, U$4.PS1, XBEE.10 (GND)
GPS_RX: GPS_CONN.1, U1.P$11 (GP8)
GPS_TX: GPS_CONN.2, U1.P$12 (GP9)
INT1_KX134: U$2.INT1
INT2_KX134: U$2.INT2
LED1: R13.1, U1.P$27 (GP21)
LED2: R16.1, U1.P$25 (GP19)
MAIN: Q2.1 (G), R6.2, U1.P$26 (GP20)
MISO0: J1.5, U1.P$21 (GP16)
MISO1: R17.2, U1.P$16 (GP12), U6.2 (DO(IO1))
MOSI1: U1.P$15 (GP11), U6.5 (DI(IO0))
unnamed: D1.C, U1.P$39 (VSYS)
unnamed: DROGUE.P$2 (-), DR_ARM.1
unnamed: INTERFACE.1 (2), INTERFACE.3 (2), U1.P$31 (GP26)
unnamed: MAIN.P$2 (-), R7.1, R11.1
unnamed: R20.1, R21.2, U4.5 (ADJ)
unnamed: MAIN.P$1 (+), MAIN_ARM.2
unnamed: DROGUE.P$1 (+), R9.1, R23.1
unnamed: RESET.1 (2), RESET.3 (2), U1.P$30 (RUN)
unnamed: R8.1, R10.2, U2.5 (ADJ)
unnamed: Q2.2 (D), R7.2
unnamed: Q1.2 (D), R9.2
unnamed: R19.2, VBUS_LED.C
unnamed: LED1.C, R13.2
unnamed: LED2.C, R16.2
unnamed: 3V3_LED.C, R14.2
unnamed: D3.A, U1.P$40 (VBUS)
unnamed: R18.2, VCC_LED.C
SCK0: J1.3, U1.P$24 (GP18)
SCK1: U1.P$14 (GP10), U6.6 (CLK)
SCL0: MOTOR_CONN.3, R5.2, U1.P$7 (GP5)
SCL1: R4.2, U1.P$5 (GP3), U3.10 (SCL), U$1.SCL, U$2.SCL, U$4.SCL
SDA0: MOTOR_CONN.2, R2.2, U1.P$6 (GP4)
SDA1: R3.2, U1.P$4 (GP2), U3.9 (SDA), U$1.SDA, U$2.SDA, U$4.SDA
SENSE_DROG: R23.2, R25.1, U3.5 (AIN1)
SENSE_MAIN: R11.2, R12.1, U3.4 (AIN0)
TELE_RX: SERIAL_CONN.3, U1.P$1 (GP0), XBEE.3 (DIN/NCONFIG/DIO14)
TELE_TX: SERIAL_CONN.2, U1.P$2 (GP1), XBEE.2 (DOUT/DIO13)
TRIG_KX134: U$2.TRIG
VBUS: D3.C, VBUS_CONN.1
VBUS_REG: C6.+, Q3.1 (G), R24.2, U2.1 (EN), U2.2 (IN), VBUS_CONN.2, VBUS_LED.A
VCC: C11.+, DR_ARM.2, LIPO_POWER.P$1 (+), MAIN_ARM.1, Q3.2 (S), U3.7 (AIN3), U4.2 (IN), VCC_LED.A
VCC_EN: Q3.3 (D), R22.2, U4.1 (EN)

Notes on the sheet:
Telemetry communicates with pico on SPI0 bus
Data logging components communicate with pico on SPI1 bus
All CS lines have a pullup resistor to initialize all components as inactive If this is not done, garbage values may cause trouble Similarly, all MISO lines are pulled up as they are only used when slave components are in use. They might float otherwise
Push button to reset pico (Bad idea, do not solder in actual board)
Push button for interfacing (Bad idea?)
Sensors are on the I2C_1 bus (Except the ram air speed sensor)
MICROCONTOLLER AND PERIPHERALS
TELEMETRY
POWER AND PYROS
SENSORS
DATA LOGGING
Reset Pin is ACTIVE LOW
PS0 and PS1 are tied to GND to select I2C

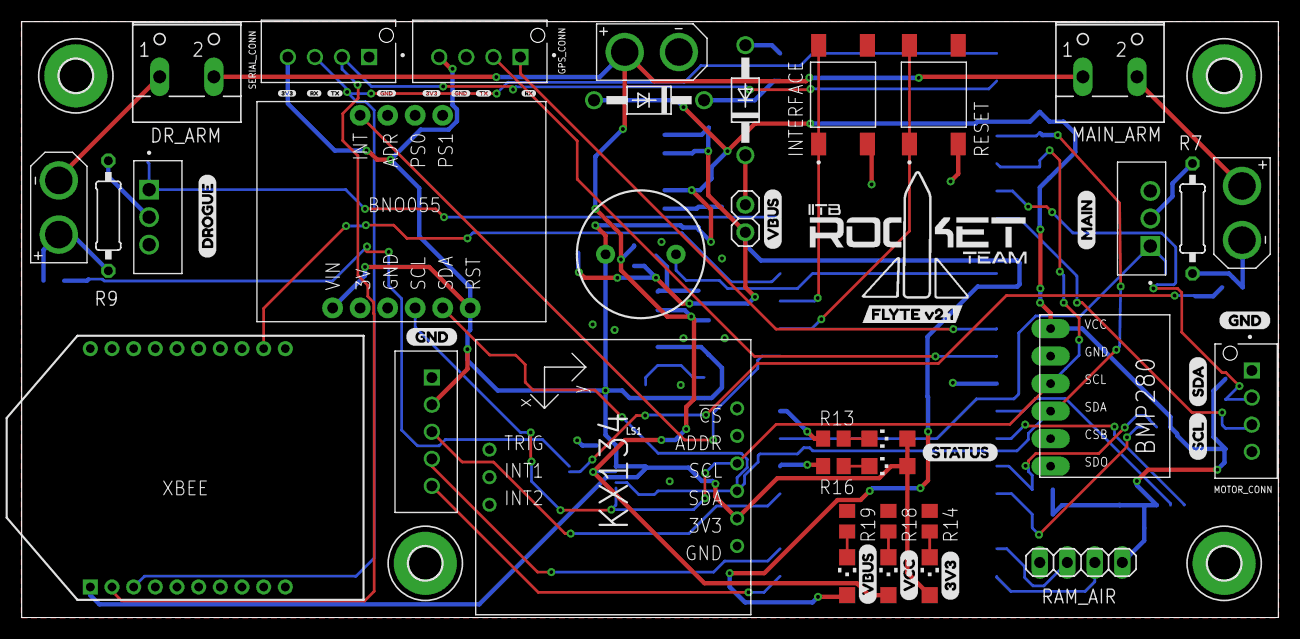
[picture p73: board FLYTE-v2_1.brd from above]

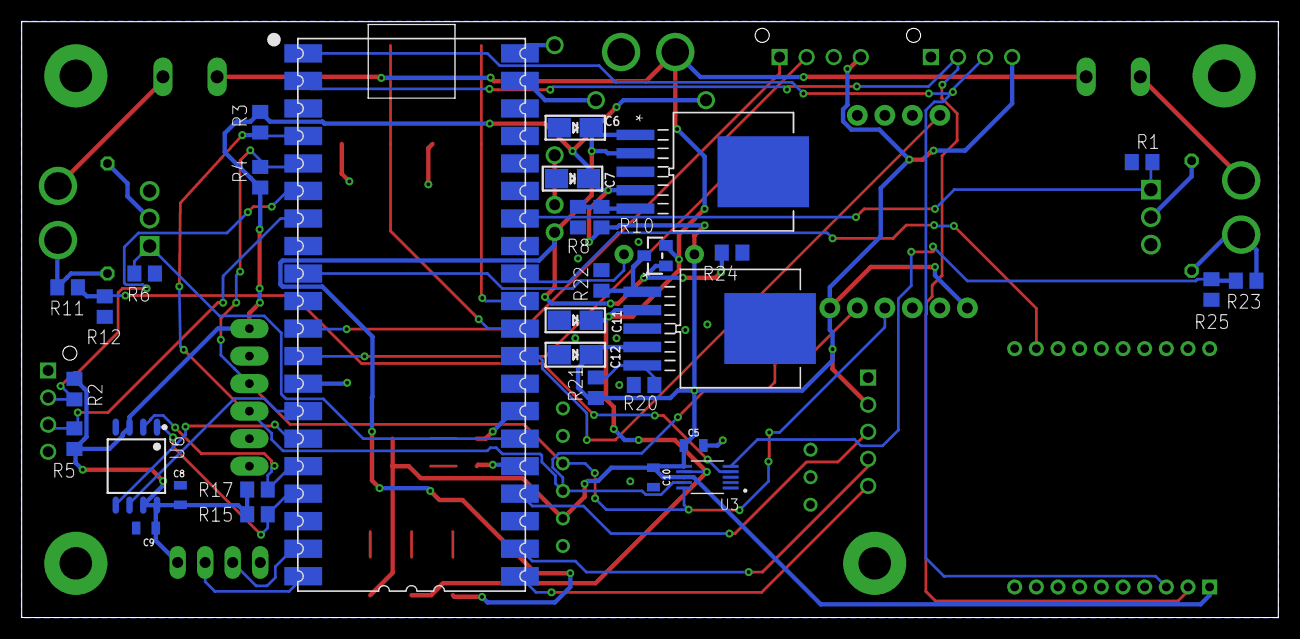
[picture p74: board FLYTE-v2_1.brd from below]

Board: 2 copper layers, 116.0 x 55.0 mm, 90 parts (32 on the bottom side), 49 nets.

Other parts of the board:
U$3, U$15, U$18, U$21: GND0
U$5, U$19, U$20: 3V30
U$9: STATUS0
U$10: VCC0
U$11, U$26: VBUS0
U$12: MAIN0
U$13: DROGUE0
U$16: SCL0
U$17: SDA0
U$22, U$23: RX0
U$24, U$25: TX0
U$27: FLYTE_V2#10
