IITB-Rocket-Team-Avionics/FLYTE/Eagle files/FLYTE 2.0/FLYTE-v2.brd

## EAGLE design Eagle files/FLYTE 2.0/FLYTE-v2.brd (2024-04-15)

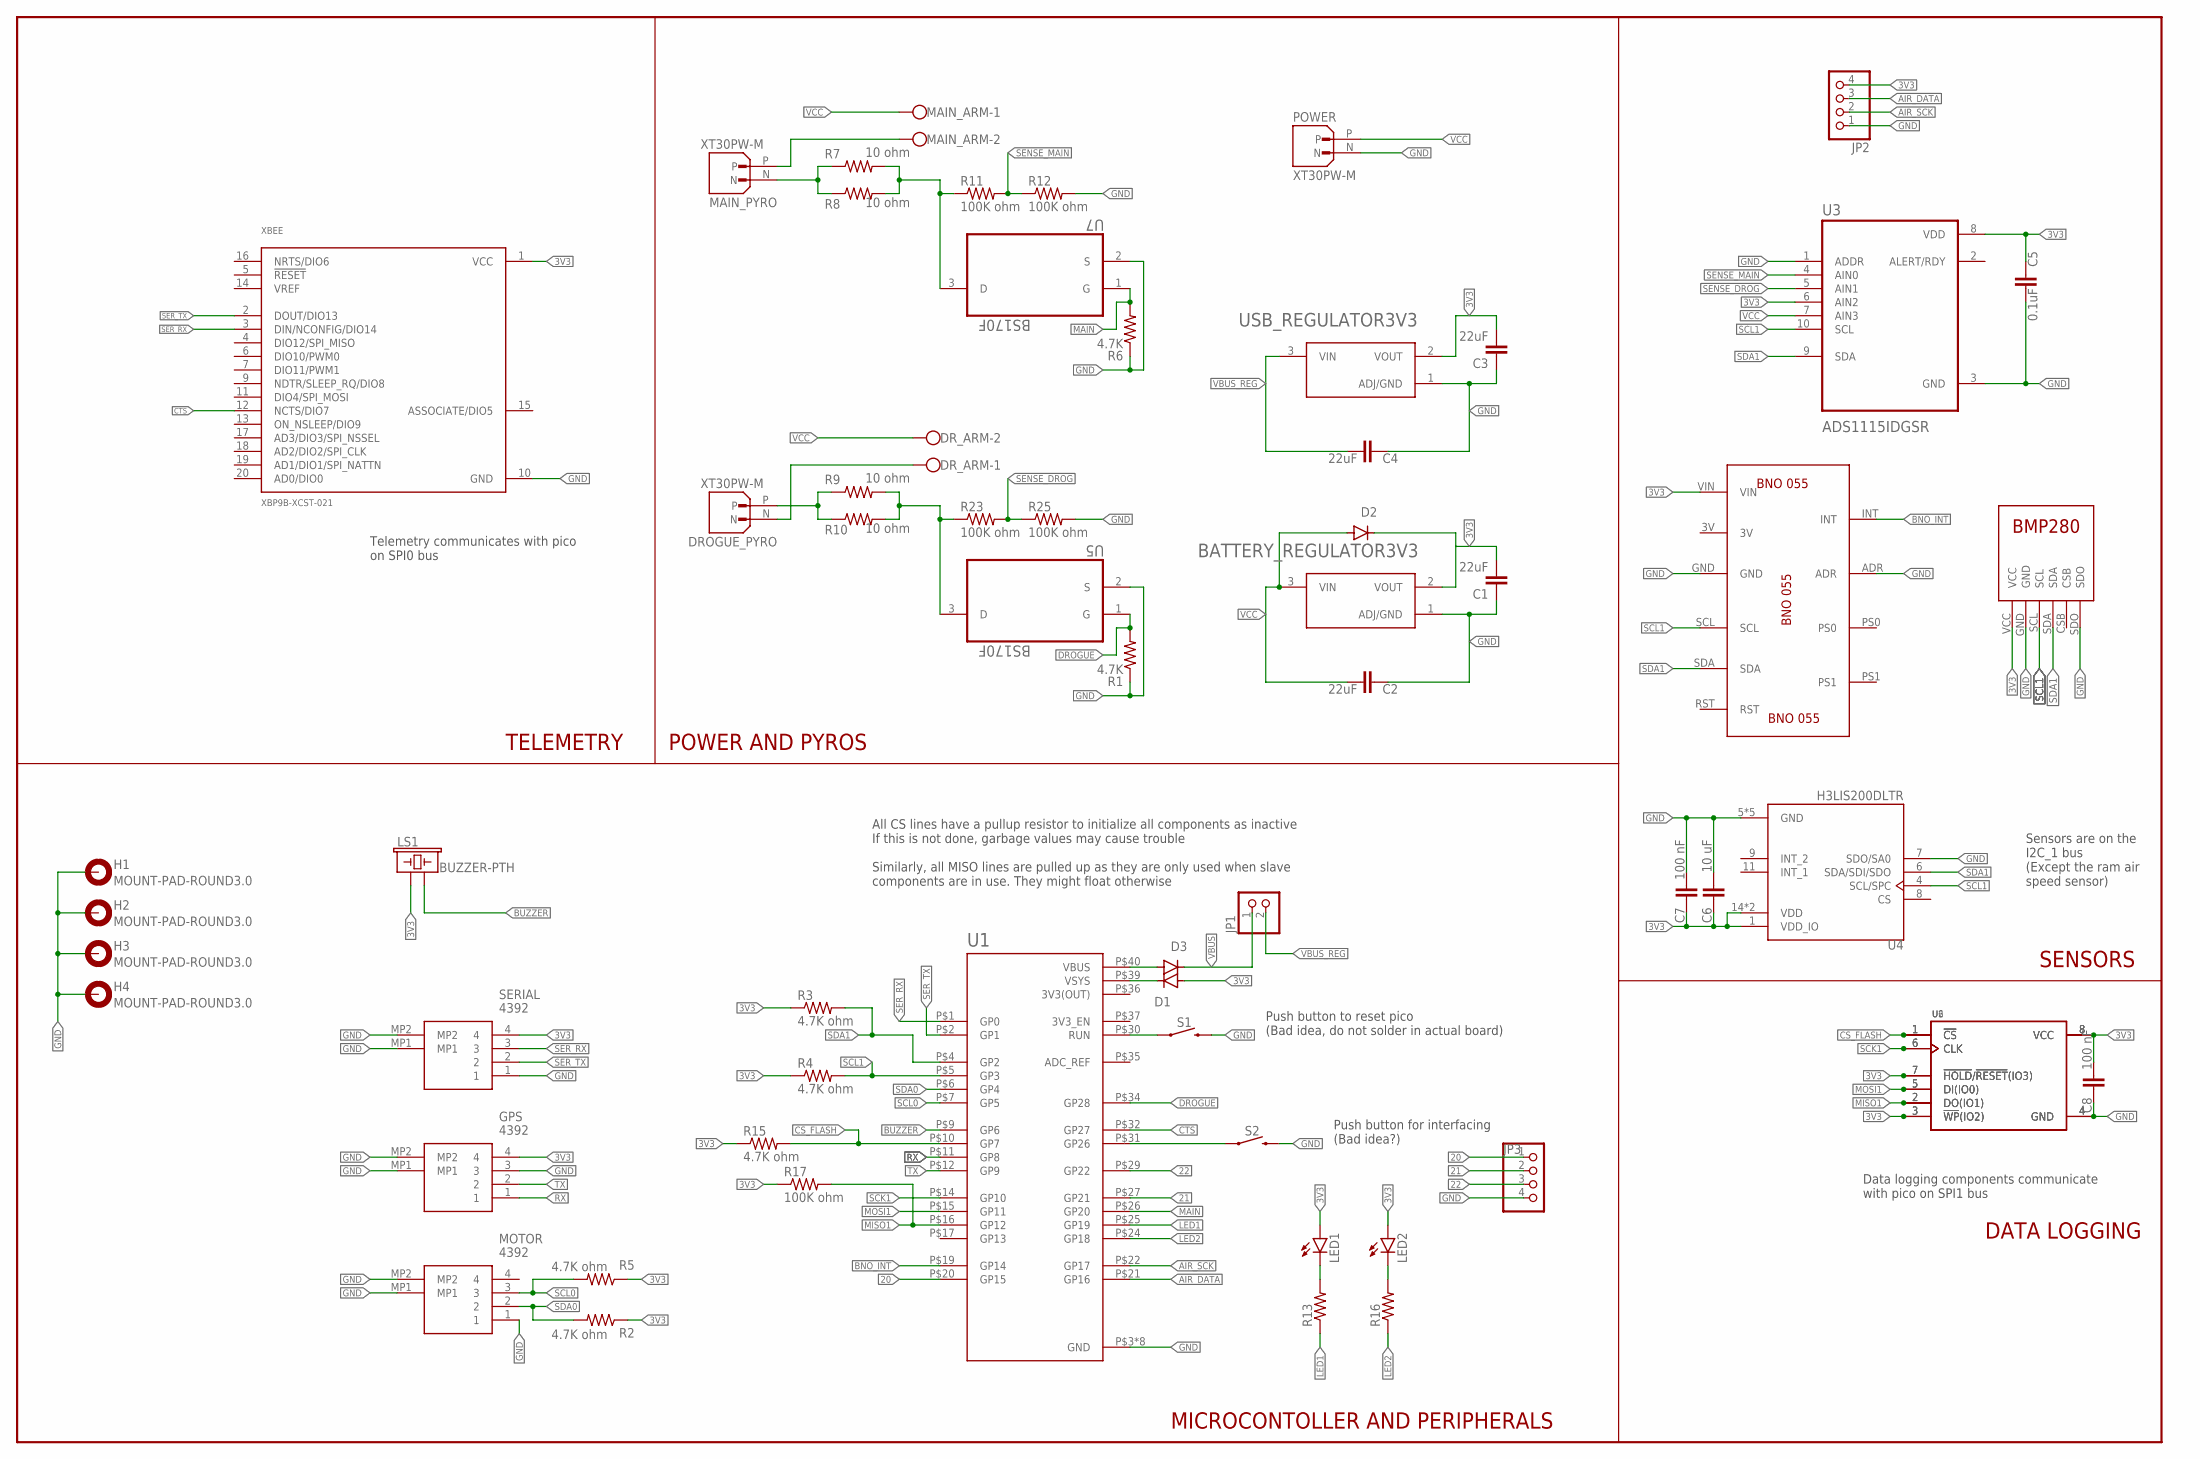
[picture p75: schematic FLYTE-v2.sch]

Parts:
BATTERY_REGULATOR3V3: AMS1117-3.3; SOT229P700X180-4N
C1, C2, C3, C4: 22uF; 0805
C5: 0.1uF; 0805
C6: 10 uF; 0805
C7, C8: 100 nF; 0805
D1, D2, D3: 1N4004; DO41-10
DROGUE_PYRO: XT30PW-M; AMASS_XT30PW-M
DR_ARM: W237-102
GPS: 4392
H1, H2, H3, H4: MOUNT-PAD-ROUND3.0; 3,0-PAD
JP1: PINHD-1X2; 1X02
JP2, JP3: PINHD-1X4; 1X04
LED1, LED2: LEDCHIPLED_1206; CHIPLED_1206
LS1: BUZZER-PTH; BUZZER-12MM
MAIN_ARM: W237-102
MAIN_PYRO: XT30PW-M; AMASS_XT30PW-M
MOTOR: 4392
POWER: XT30PW-M; AMASS_XT30PW-M
R1, R6: 4.7K; R0805
R2, R3, R4, R5, R15: 4.7K ohm; R0805
R7, R8, R9, R10: 10 ohm; 0207/10
R11, R12, R17, R23, R25: 100K ohm; R0805
R13, R16: R-US_R0805; R0805
S1, S2: MOMENTARY-SWITCH-SPST-PTH-6.0MM; TACTILE_SWITCH_PTH_6.0MM
SERIAL: 4392
U1: RASPBERRY_PICO-NO_DEBUG; PICO-PKG-NO_DEBUG
U2, U6: W25Q32JVSSIQ; SOIC127P790X216-8N
U3: ADS1115IDGSR; SOP50P490X110-10N
U4: H3LIS200DLTR; PQFN50P300X300X100-16N
U5, U7: BS170F; SOT91P240X120-3N
U$1: BMP280
U$4: BNO055
USB_REGULATOR3V3: AMS1117-3.3; SOT229P700X180-4N
XBEE: XBP9B-XCST-021; DIP2200W51P200L3294H279Q20P

Connections:
3V3: BATTERY_REGULATOR3V3.2 (VOUT), C1.2, C3.2, C5.1, C6.1, C7.1, C8.2, D1.A, D2.C, GPS.4, JP2.4, LED1.A, LED2.A, LS1.+ (1), R2.1, R3.1, R4.1, R5.1, R15.1, R17.1, SERIAL.4, U2.3 (!WP!(IO2)), U2.7 (!HOLD!/!RESET!(IO3)), U2.8 (VCC), U3.6 (AIN2), U3.8 (VDD), U4.1 (VDD_IO), U4.14 (VDD), U4.15 (VDD), U6.3 (!WP!(IO2)), U6.7 (!HOLD!/!RESET!(IO3)), U6.8 (VCC), U$1.VCC, U$4.VIN, USB_REGULATOR3V3.2 (VOUT), XBEE.1 (VCC)
3V3(OUT): U1.P$36 (3V3(OUT))
20: JP3.1, U1.P$20 (GP15)
21: JP3.2, U1.P$27 (GP21)
22: JP3.3, U1.P$29 (GP22)
AIR_DATA: JP2.3, U1.P$21 (GP16)
AIR_SCK: JP2.2, U1.P$22 (GP17)
BNO_INT: U1.P$19 (GP14), U$4.INT
BUZZER: LS1.- (2), U1.P$9 (GP6)
CS_FLASH: R15.2, U1.P$10 (GP7), U2.1 (!CS), U6.1 (!CS)
CTS: U1.P$32 (GP27), XBEE.12 (NCTS/DIO7)
DROGUE: R1.2, U1.P$34 (GP28), U5.1 (G)
GND: BATTERY_REGULATOR3V3.1 (ADJ/GND), C1.1, C2.1, C3.1, C4.1, C5.2, C6.2, C7.2, C8.1, GPS.3, GPS.MP1, GPS.MP2, H1.B3,0, H2.B3,0, H3.B3,0, H4.B3,0, JP2.1, JP3.4, MOTOR.1, MOTOR.MP1, MOTOR.MP2, POWER.N, R1.1, R6.1, R12.2, R25.2, S1.3 (2), S2.3 (2), SERIAL.1, SERIAL.MP1, SERIAL.MP2, U1.P$3 (GND), U1.P$8 (GND), U1.P$13 (GND), U1.P$18 (GND), U1.P$23 (GND), U1.P$28 (GND), U1.P$33 (GND), U1.P$38 (GND), U2.4 (GND), U3.1 (ADDR), U3.3 (GND), U4.5 (GND), U4.7 (SDO/SA0), U4.10 (GND), U4.12 (GND), U4.13 (GND), U4.16 (GND), U5.2 (S), U6.4 (GND), U7.2 (S), U$1.GND, U$1.SDO, U$4.ADR, U$4.GND, USB_REGULATOR3V3.1 (ADJ/GND), XBEE.10 (GND)
LED1: R13.1, U1.P$25 (GP19)
LED2: R16.1, U1.P$24 (GP18)
MAIN: R6.2, U1.P$26 (GP20), U7.1 (G)
MISO1: R17.2, U1.P$16 (GP12), U2.2 (DO(IO1)), U6.2 (DO(IO1))
MOSI1: U1.P$15 (GP11), U2.5 (DI(IO0)), U6.5 (DI(IO0))
unnamed: D1.C, U1.P$39 (VSYS)
unnamed: DROGUE_PYRO.N, DR_ARM.1
unnamed: S2.1, U1.P$31 (GP26)
unnamed: MAIN_PYRO.N, R7.1, R8.1
unnamed: R7.2, R8.2, R11.1, U7.3 (D)
unnamed: MAIN_ARM.2, MAIN_PYRO.P
unnamed: DROGUE_PYRO.P, R9.1, R10.1
unnamed: S1.1, U1.P$30 (RUN)
unnamed: R9.2, R10.2, R23.1, U5.3 (D)
unnamed: LED1.C, R13.2
unnamed: LED2.C, R16.2
unnamed: D3.A, U1.P$40 (VBUS)
RX: GPS.1, U1.P$11 (GP8)
SCK1: U1.P$14 (GP10), U2.6 (CLK), U6.6 (CLK)
SCL0: MOTOR.3, R5.2, U1.P$7 (GP5)
SCL1: R4.2, U1.P$5 (GP3), U3.10 (SCL), U4.4 (SCL/SPC), U$1.SCL, U$4.SCL
SDA0: MOTOR.2, R2.2, U1.P$6 (GP4)
SDA1: R3.2, U1.P$4 (GP2), U3.9 (SDA), U4.6 (SDA/SDI/SDO), U$1.SDA, U$4.SDA
SENSE_DROG: R23.2, R25.1, U3.5 (AIN1)
SENSE_MAIN: R11.2, R12.1, U3.4 (AIN0)
SER_RX: SERIAL.3, U1.P$1 (GP0), XBEE.3 (DIN/NCONFIG/DIO14)
SER_TX: SERIAL.2, U1.P$2 (GP1), XBEE.2 (DOUT/DIO13)
TX: GPS.2, U1.P$12 (GP9)
VBUS: D3.C, JP1.1
VBUS_REG: C4.2, JP1.2, USB_REGULATOR3V3.3 (VIN)
VCC: BATTERY_REGULATOR3V3.3 (VIN), C2.2, D2.A, DR_ARM.2, MAIN_ARM.1, POWER.P, U3.7 (AIN3)

Notes on the sheet:
Telemetry communicates with pico on SPI0 bus
Data logging components communicate with pico on SPI1 bus
All CS lines have a pullup resistor to initialize all components as inactive If this is not done, garbage values may cause trouble Similarly, all MISO lines are pulled up as they are only used when slave components are in use. They might float otherwise
Push button to reset pico (Bad idea, do not solder in actual board)
Push button for interfacing (Bad idea?)
Sensors are on the I2C_1 bus (Except the ram air speed sensor)
MICROCONTOLLER AND PERIPHERALS
TELEMETRY
POWER AND PYROS
SENSORS
DATA LOGGING

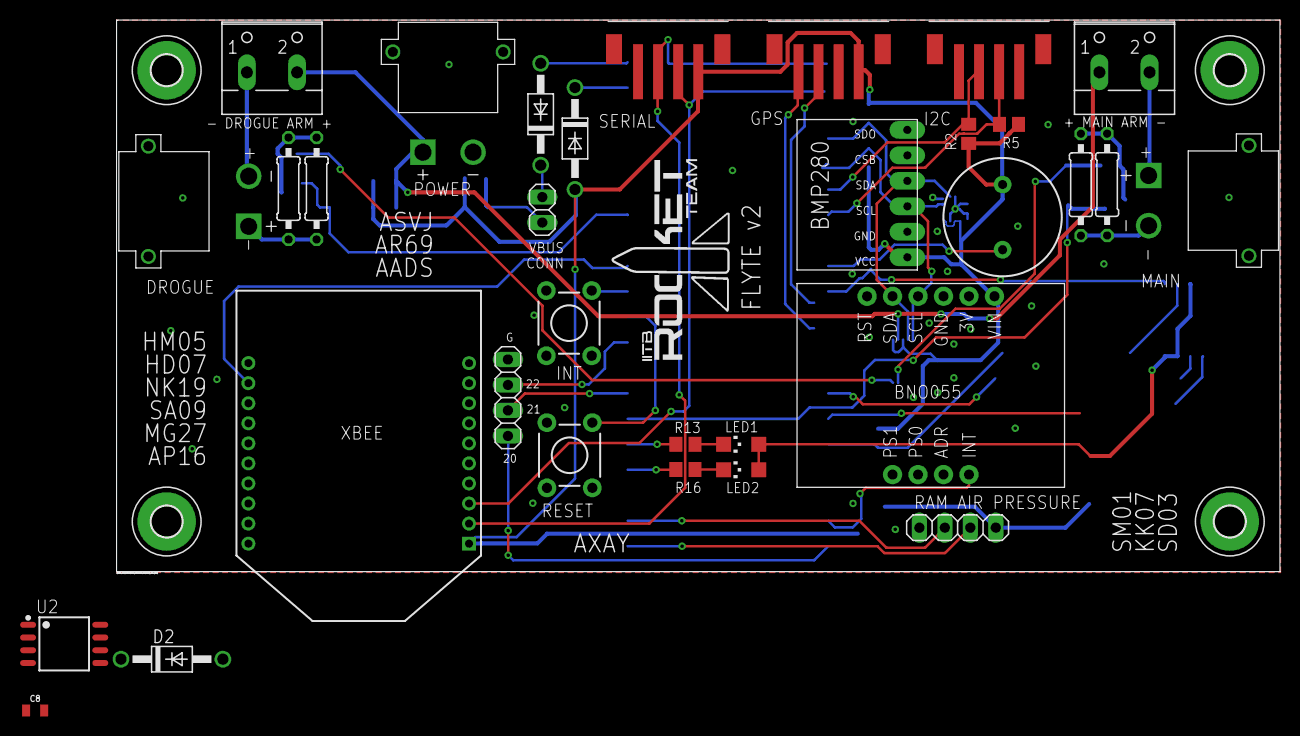
[picture p76: board FLYTE-v2.brd from above]

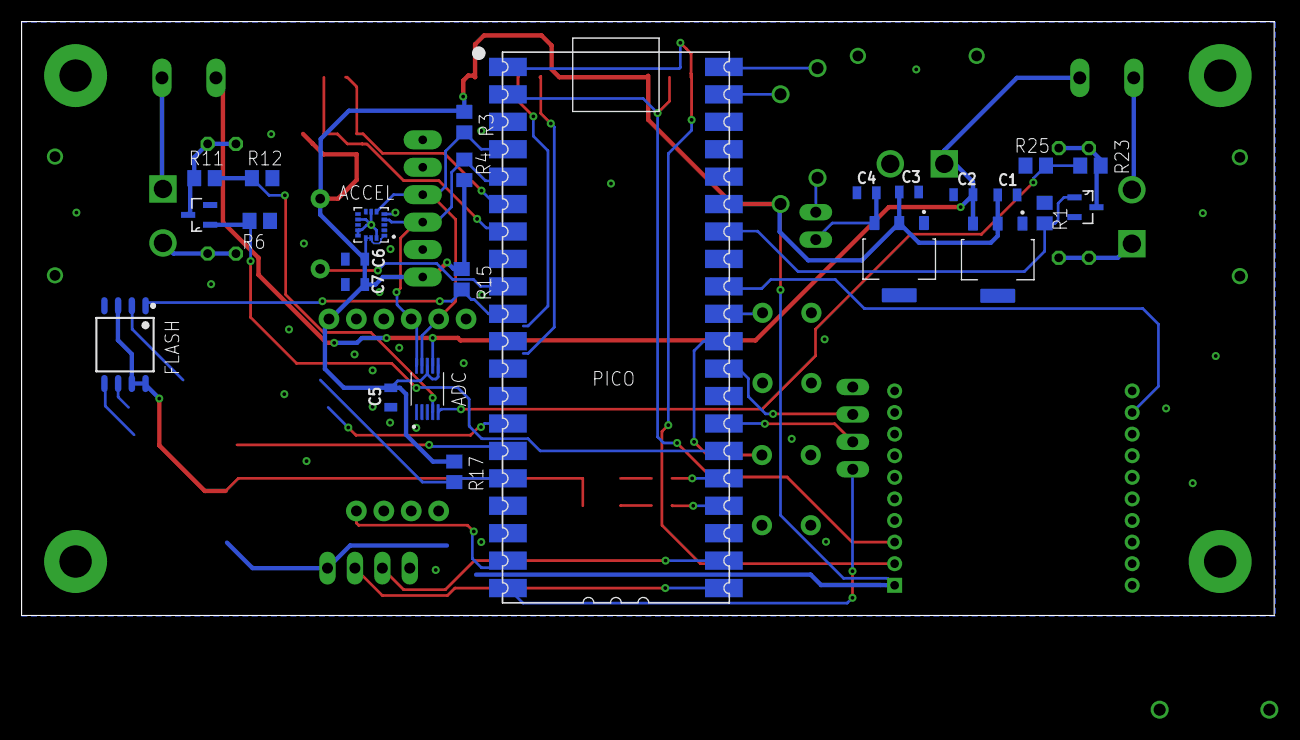
[picture p77: board FLYTE-v2.brd from below]

Board: 2 copper layers, 116.0 x 55.0 mm, 61 parts (25 on the bottom side), 43 nets.
