IITB-Rocket-Team-Avionics/FLYTE/Eagle files/FLYTE 2.0/motor_controller.brd

## EAGLE design Eagle files/FLYTE 2.0/motor_controller.brd (2024-04-15)

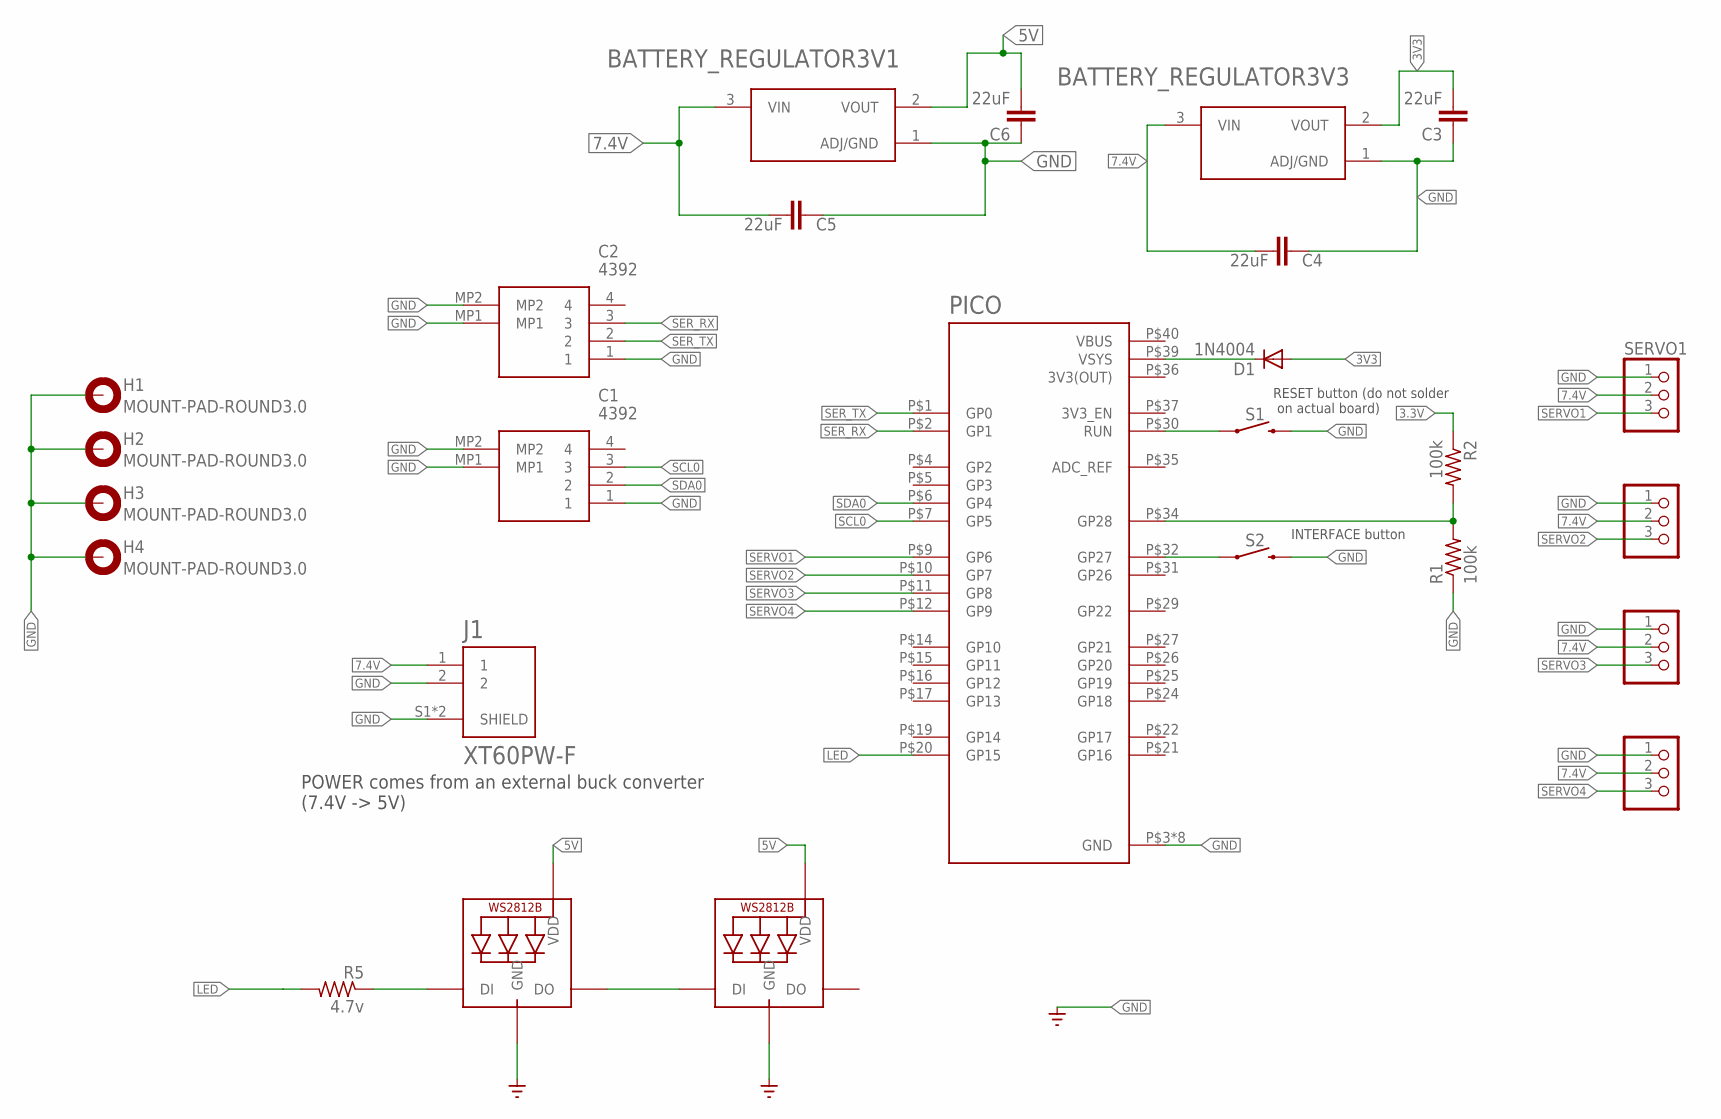
[picture p78: schematic motor_controller.sch]

Parts:
BATTERY_REGULATOR3V1, BATTERY_REGULATOR3V3: AMS1117-3.3; SOT229P700X180-4N
C1, C2: 4392
C3, C4, C5, C6: 22uF; 0805
D1: 1N4004; DO41-10
H1, H2, H3, H4: MOUNT-PAD-ROUND3.0; 3,0-PAD
J1: XT60PW-F; AMASS_XT60PW-F
LED1, LED2: WS2812B3535; LED3535
PICO: RASPBERRY_PICO-NO_DEBUG; PICO-PKG-NO_DEBUG
R1, R2: 100k; R0805
R5: 4.7v; R0805
S1, S2: MOMENTARY-SWITCH-SPST-PTH-6.0MM; TACTILE_SWITCH_PTH_6.0MM
SERVO1, SERVO2, SERVO3, SERVO4: PINHD-1X3; 1X03

Connections:
3.3V: R2.1
3V3: BATTERY_REGULATOR3V3.2 (VOUT), C3.2, D1.A
3V3(OUT): PICO.P$36 (3V3(OUT))
5V: BATTERY_REGULATOR3V1.2 (VOUT), C6.2, LED1.2 (VDD), LED2.2 (VDD)
7.4V: BATTERY_REGULATOR3V1.3 (VIN), BATTERY_REGULATOR3V3.3 (VIN), C4.2, C5.2, J1.1, SERVO1.2, SERVO2.2, SERVO3.2, SERVO4.2
GND: BATTERY_REGULATOR3V1.1 (ADJ/GND), BATTERY_REGULATOR3V3.1 (ADJ/GND), C1.1, C1.MP1, C1.MP2, C2.1, C2.MP1, C2.MP2, C3.1, C4.1, C5.1, C6.1, H1.B3,0, H2.B3,0, H3.B3,0, H4.B3,0, J1.2, J1.S1 (SHIELD), J1.S2 (SHIELD), LED1.4 (GND), LED2.4 (GND), PICO.P$3 (GND), PICO.P$8 (GND), PICO.P$13 (GND), PICO.P$18 (GND), PICO.P$23 (GND), PICO.P$28 (GND), PICO.P$33 (GND), PICO.P$38 (GND), R1.1, S1.3 (2), S2.3 (2), SERVO1.1, SERVO2.1, SERVO3.1, SERVO4.1
LED: PICO.P$20 (GP15), R5.2
unnamed: D1.C, PICO.P$39 (VSYS)
unnamed: PICO.P$30 (RUN), S1.1
unnamed: PICO.P$32 (GP27), S2.1
unnamed: PICO.P$34 (GP28), R1.2, R2.2
unnamed: LED1.3 (DO), LED2.1 (DI)
unnamed: LED1.1 (DI), R5.1
SCL0: C1.3, PICO.P$7 (GP5)
SDA0: C1.2, PICO.P$6 (GP4)
SERVO1: PICO.P$9 (GP6), SERVO1.3
SERVO2: PICO.P$10 (GP7), SERVO2.3
SERVO3: PICO.P$11 (GP8), SERVO3.3
SERVO4: PICO.P$12 (GP9), SERVO4.3
SER_RX: C2.3, PICO.P$2 (GP1)
SER_TX: C2.2, PICO.P$1 (GP0)
VBUS: PICO.P$40 (VBUS)

Notes on the sheet:
RESET button (do not solder on actual board)
INTERFACE button
POWER comes from an external buck converter (7.4V -> 5V)

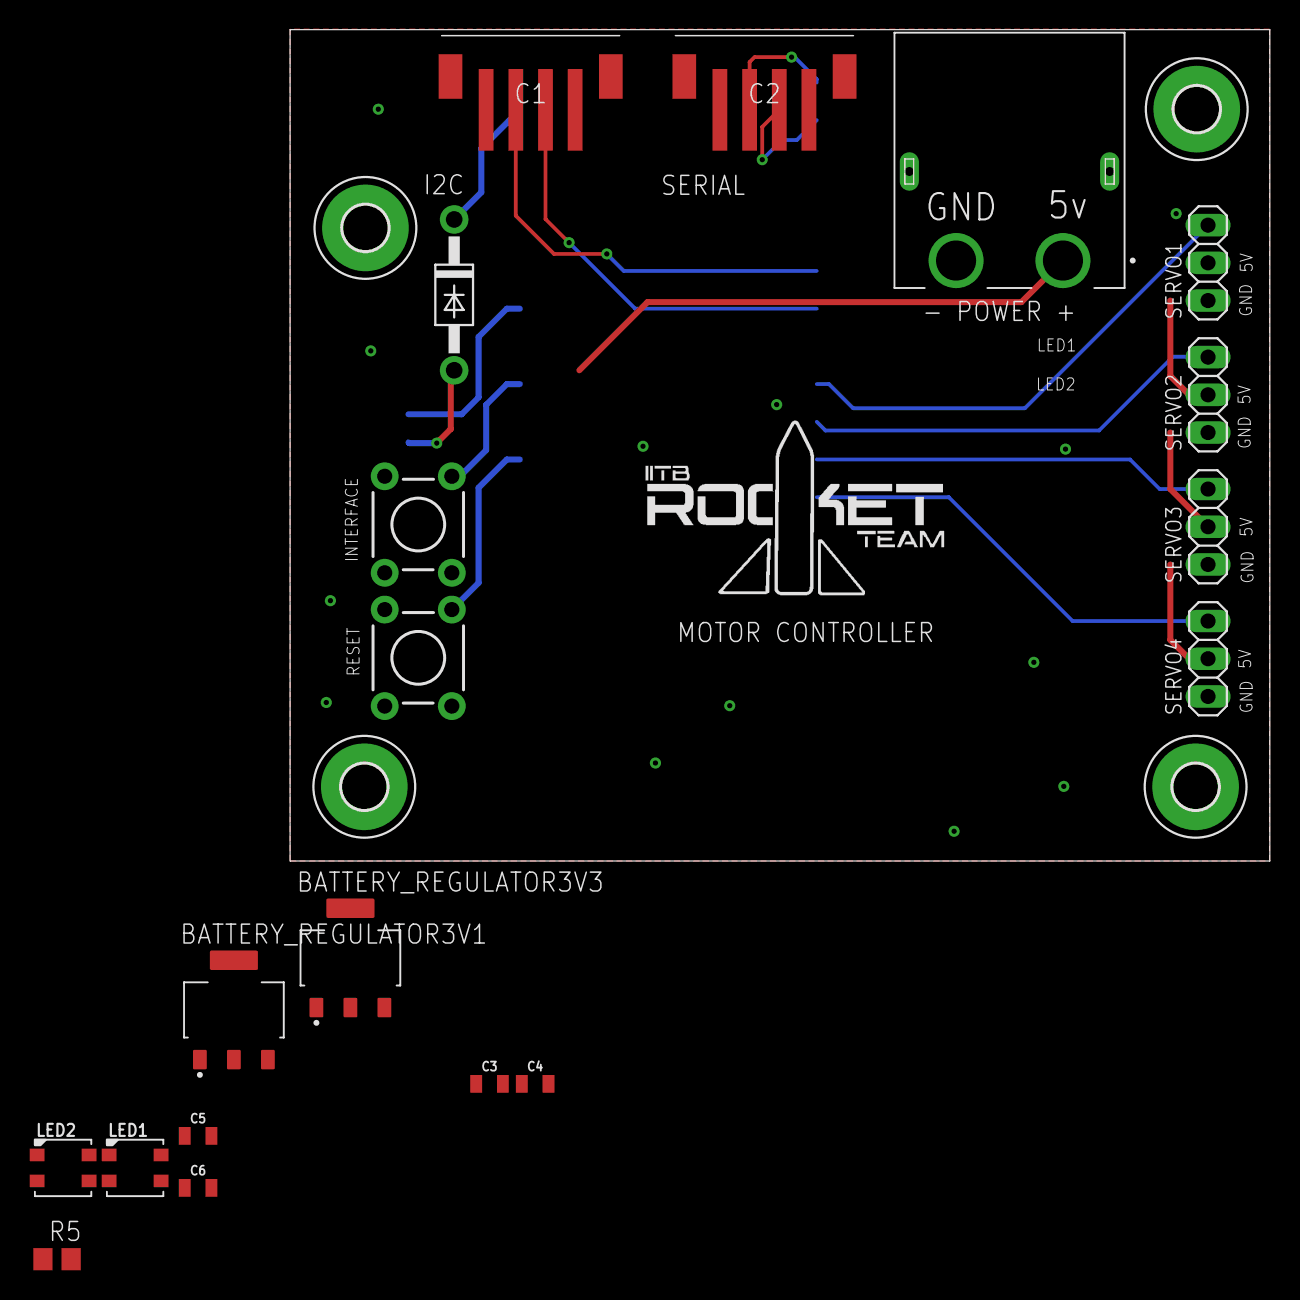
[picture p79: board motor_controller.brd from above]

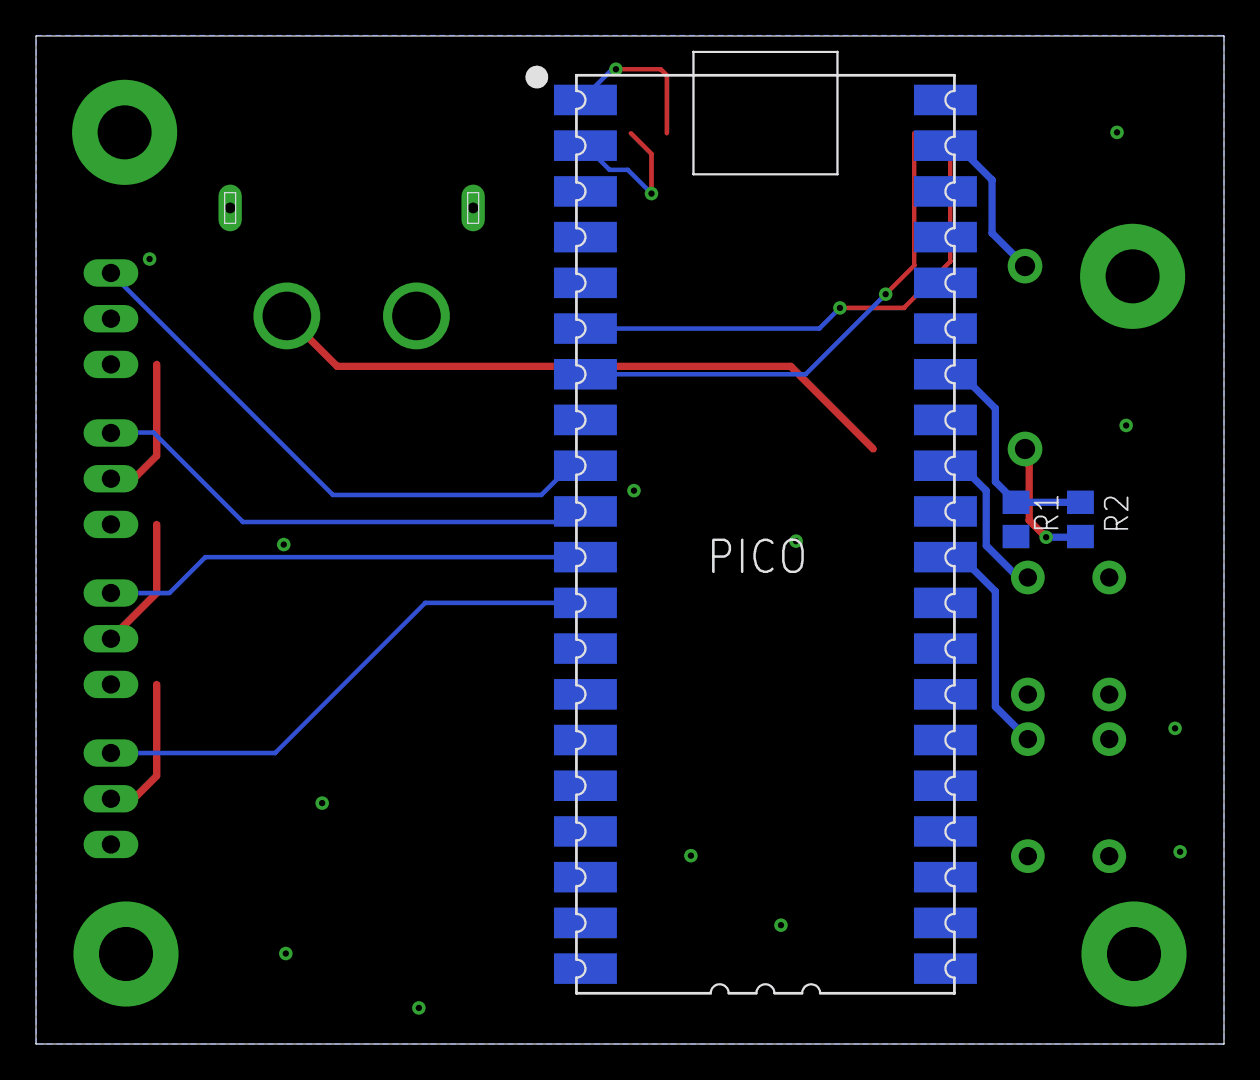
[picture p80: board motor_controller.brd from below]

Board: 2 copper layers, 66.0 x 56.0 mm, 26 parts (3 on the bottom side), 19 nets.
