IITB-Rocket-Team-Avionics/FLYTE/Eagle files/FLYTE 1.0/TERRA-v1/TERRA-v1.brd

## EAGLE design Eagle files/FLYTE 1.0/TERRA-v1/TERRA-v1.brd (2023-05-24)

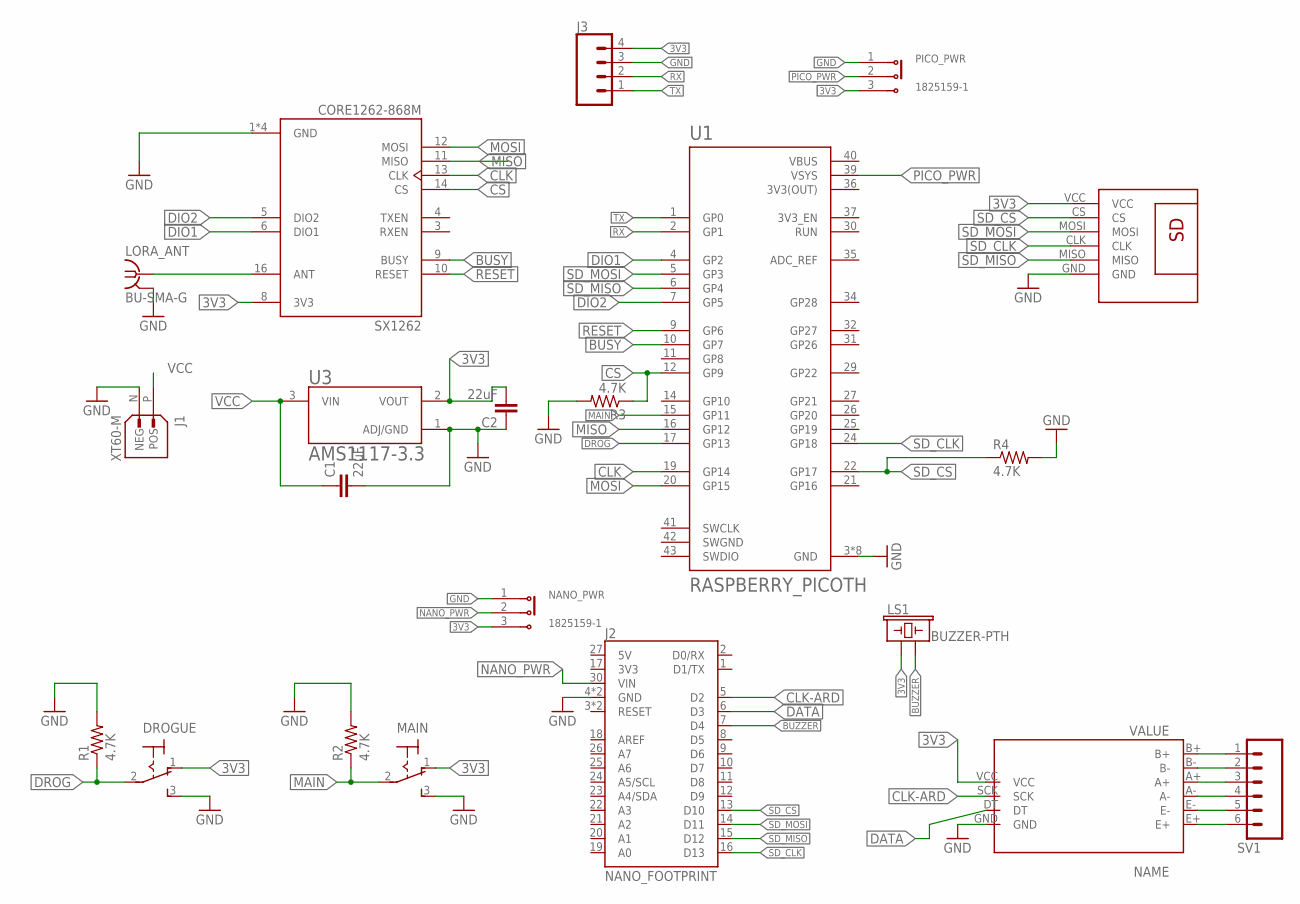
[picture p81: schematic TERRA-v1.sch]

Parts:
C1, C2: 22uF; 0805
DROGUE: M9040P
HX711: HX711
J1: XT60-M; AMASS_XT60-M
J2: NANO_FOOTPRINT; NANO
J3: CONN_04PTH; 1X04
LORA_ANT: BU-SMA-G
LS1: BUZZER-PTH; BUZZER-12MM
MAIN: M9040P
NANO_PWR: 1825159-1; SW_1825159-1
PICO_PWR: 1825159-1; SW_1825159-1
R1, R2, R3, R4: 4.7K; R0805
SV1: CONN_06SILK_FEMALE_PTH; 1X06
SX1262: CORE1262-868M; XCVR_CORE1262-868M
U1: RASPBERRY_PICOTH; PICO-PKG-TH
U3: AMS1117-3.3; SOT229P700X180-4N
U$1: SDREADER

Connections:
3V3: C2.2, DROGUE.1 (O), HX711.VCC, J3.4, LS1.+ (1), MAIN.1 (O), NANO_PWR.3, PICO_PWR.3, SX1262.8 (3V3), U3.2 (VOUT), U$1.VCC
3V3(OUT): U1.36 (3V3(OUT))
BUSY: SX1262.9 (BUSY), U1.10 (GP7)
BUZZER: J2.7 (D4), LS1.- (2)
CLK: SX1262.13 (CLK), U1.19 (GP14)
CLK-ARD: HX711.SCK, J2.5 (D2)
CS: R3.1, SX1262.14 (CS), U1.12 (GP9)
DATA: HX711.DT, J2.6 (D3)
DIO1: SX1262.6 (DIO1), U1.4 (GP2)
DIO2: SX1262.5 (DIO2), U1.7 (GP5)
DROG: DROGUE.2, R1.1, U1.17 (GP13)
GND: C1.2, C2.1, DROGUE.3 (S), HX711.GND, J1.N (NEG), J2.4 (GND), J2.29 (GND), J3.3, LORA_ANT.2, LORA_ANT.3 (2), LORA_ANT.4 (2), LORA_ANT.5 (2), MAIN.3 (S), NANO_PWR.1, PICO_PWR.1, R1.2, R2.2, R3.2, R4.2, SX1262.1 (GND), SX1262.2 (GND), SX1262.7 (GND), SX1262.15 (GND), U1.3 (GND), U1.8 (GND), U1.13 (GND), U1.18 (GND), U1.23 (GND), U1.28 (GND), U1.33 (GND), U1.38 (GND), U3.1 (ADJ/GND), U$1.GND
MAIN: MAIN.2, R2.1, U1.15 (GP11)
MISO: SX1262.11 (MISO), U1.16 (GP12)
MOSI: SX1262.12 (MOSI), U1.20 (GP15)
unnamed: LORA_ANT.1, SX1262.16 (ANT)
unnamed: HX711.B+, SV1.1
unnamed: HX711.B-, SV1.2
unnamed: HX711.A+, SV1.3
unnamed: HX711.A-, SV1.4
unnamed: HX711.E-, SV1.5
unnamed: HX711.E+, SV1.6
NANO_PWR: J2.30 (VIN), NANO_PWR.2
PICO_PWR: PICO_PWR.2, U1.39 (VSYS)
RESET: SX1262.10 (RESET), U1.9 (GP6)
RX: J3.2, U1.2 (GP1)
SD_CLK: J2.16 (D13), U1.24 (GP18), U$1.CLK
SD_CS: J2.13 (D10), R4.1, U1.22 (GP17), U$1.CS
SD_MISO: J2.15 (D12), U1.6 (GP4), U$1.MISO
SD_MOSI: J2.14 (D11), U1.5 (GP3), U$1.MOSI
SWGND: U1.42 (SWGND)
TX: J3.1, U1.1 (GP0)
VBUS: U1.40 (VBUS)
VCC: C1.1, J1.P (POS), U3.3 (VIN)

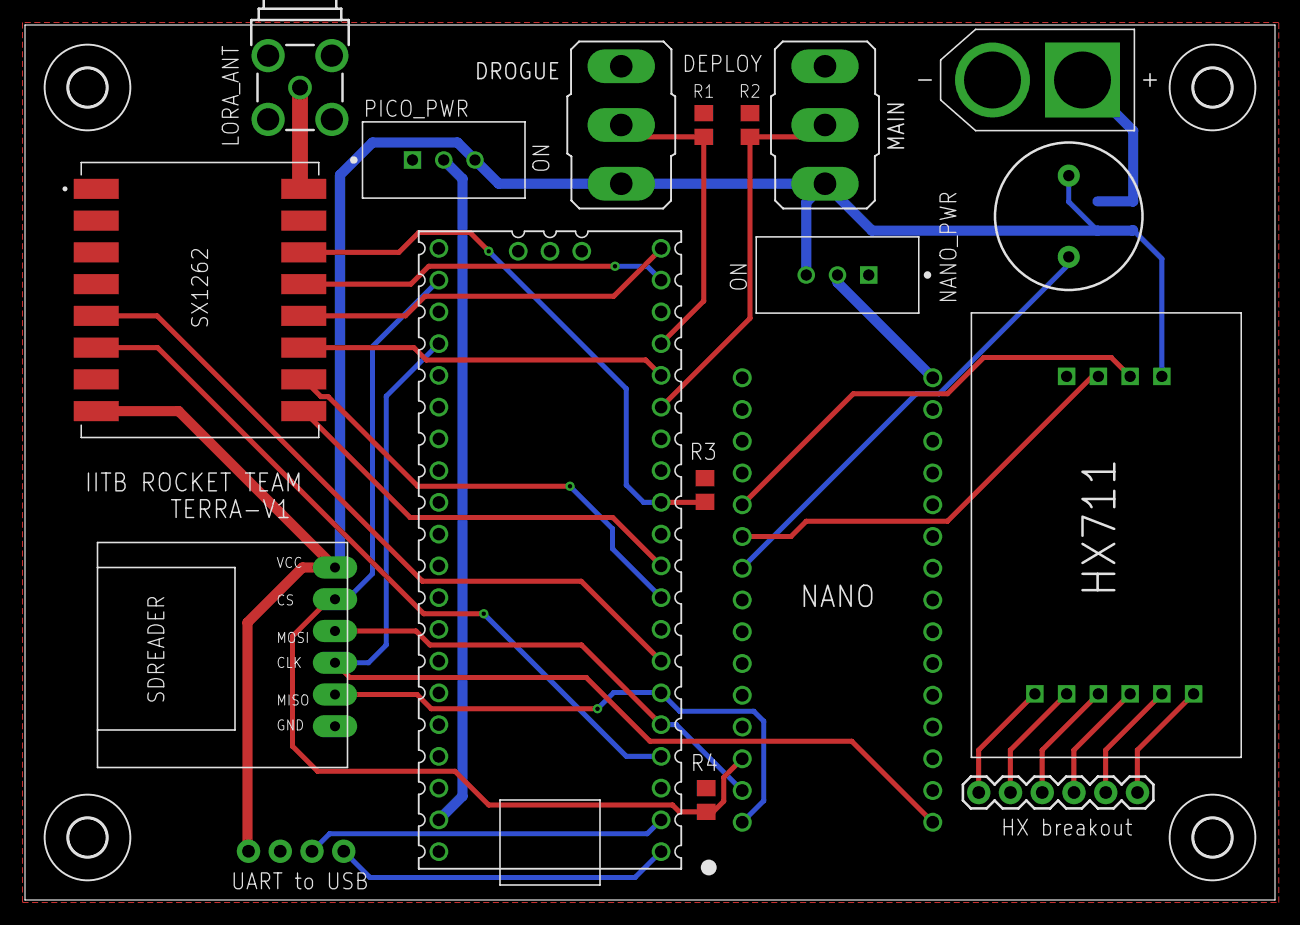
[picture p82: board TERRA-v1.brd from above]

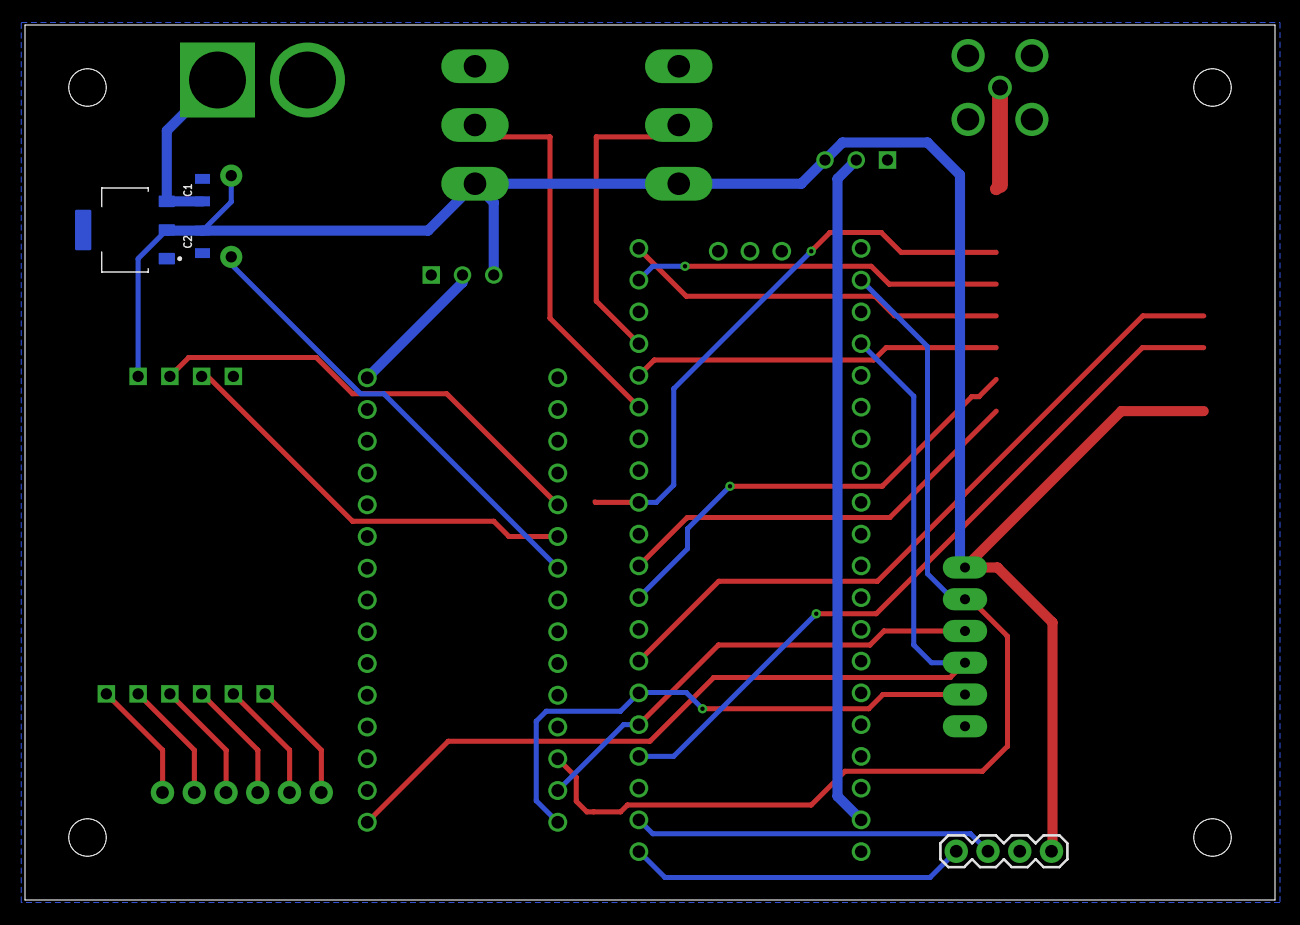
[picture p83: board TERRA-v1.brd from below]

Board: 2 copper layers, 100.0 x 70.0 mm, 25 parts (4 on the bottom side), 31 nets.

Other parts of the board:
U$2, U$3, U$5, U$6: 3,0
