IITB-Rocket-Team-Avionics/FLYTE/Software_v2/main_fc/setup/bno_offsets.py

from machine import Pin,I2C,SPI
from time import ticks_ms,sleep
from bmp280 import *
from bno055 import *

i2c_bus = I2C(1,sda=Pin(2),scl=Pin(3))

print(i2c_bus.scan())

imu = BNO055(i2c_bus)

imu.mode(12)

while True:
    print(imu.euler())
    sleep(0.02)
