IITB-Rocket-Team-Avionics/FLYTE/Software_v2/main_fc/setup/adc_test.py

# Sample code for ESP8266 & ESP32, Micropython.org firmware
from machine import I2C, Pin
import ads1x15
from time import sleep_ms

addr = 72

i2c = I2C(1,scl=Pin(3), sda=Pin(2), freq=400000)

ads = ads1x15.ADS1115(i2c, addr)

while True:
    ads.set_conv(7, 0) # vcc
    a = ads.raw_to_v(ads.read_rev())
    sleep_ms(10)
    ads.set_conv(7, 1) # main
    b = ads.raw_to_v(ads.read_rev())
    sleep_ms(10)
    ads.set_conv(7, 2) # drogue
    c = ads.raw_to_v(ads.read_rev())
    sleep_ms(10)
    ads.set_conv(7, 3) # 3v3
    d = ads.raw_to_v(ads.read_rev())
    sleep_ms(10)
    
    print(a,b,c)
    
#     ads.set_conv(7, 2) # start the first conversion
#     print(ads.raw_to_v(ads.read_rev()))
