IITB-Rocket-Team-Avionics/FLYTE/(commit log)

2023-05-07 Init libraries
    [FLYTE-v1.sch]
2023-05-07 Add 3D model files
    [GPS_ublox_board.SLDPRT, Screw Terminal Block 5mm 2-way.step, ublox NEO-6M.STEP]
2023-05-10 Modify pyro and power section
    [FLYTE-v1.sch, IRF540NPBF.STEP, LD051A121KAB2A.STEP, XT60-M--3DModel-STEP-56544.STEP]
2023-05-13 Finish chematic except gps
    [1825159-1.stp, CONSMA002--3DModel-STEP-1.STEP, FLYTE-v1.brd, FLYTE-v1.sch, SC0915--3DModel-STEP-56544.STEP, TL1105F160Q--3DModel-STEP-56544.STEP, W25Q32JVSSIQ--3DModel-STEP-269445.STEP]
2023-05-13 Finish v1 schematic
    [A_GPS_ant.SLDASM, FLYTE-v1.brd, FLYTE-v1.sch, GPS_18x18_ant.stp]
2023-05-14 Finish layout
    [FLYTE-v1.brd, FLYTE-v1.sch]
2023-05-14 Finish layout with GPS
    [A_GPS_ant.SLDASM, FLYTE-v1.brd, FLYTE-v1.sch, GPS_ublox_board.SLDPRT, MicroSD Card Module - 1.stp, PLS2-3.step, SIP 100-3 v2.f3d, XT30-female.stl]
2023-05-14 move resistors, remove 1 screw sw
    [FLYTE-v1.brd, FLYTE-v1.sch]
2023-05-16 Finish wiring and top layout
    [FLYTE-v1.brd, FLYTE-v1.sch]
2023-05-17 Finish board
    [FLYTE-v1.brd]
2023-05-17 Minor fixes
    [FLYTE-v1.brd]
2023-05-19 Add ground station
    [TERRA-v1.brd, TERRA-v1.sch]
2023-05-19 Add ground vias
    [FLYTE-v1.brd]
2023-05-21 Finish ground station
    [FLYTE-v1.brd, TERRA-v1.brd, TERRA-v1.sch]
2023-05-24 Minor changes
    [FLYTE-v1.brd, FLYTE-v1.sch, HX711.step, TERRA-v1.brd, TERRA-v1.sch, toggle.STEP]
2023-06-12 Add SD mount protection and debug slow core encoding
2023-06-21 Remove prog switch
2023-12-06 Cleanup resistors, add ADC
    [FLYTE-v1.brd, FLYTE-v1.sch]
2023-12-09 a few libraries added and BNO055 lbr changed
    [Adafruit ADXL375.brd, Adafruit ADXL375.sch, Adafruit BNO055 STEMMA QT.brd, Adafruit BNO055 STEMMA QT.sch, Adafruit BNO055.brd, Adafruit BNO055.sch]
2023-12-10 bno added
    [FLYTE-v1.brd, FLYTE-v1.sch, TERRA-v1.brd, TERRA-v1.sch, efuse.sch, short_detec.sch]
2023-12-11 Add JST, MOSFET, and high g accel
    [FLYTE-v2.brd, FLYTE-v2.sch]
2023-12-19 sensor data from car rides
2023-12-20 Improve pyros
    [FLYTE-v2.brd, FLYTE-v2.sch, SMBJ40CA-HR.stp]
2023-12-21 ins/gnss coupling analyzer added
    [earth.csv]
2023-12-25 added gnss aided acceleromter bias estimation
2023-12-26 improved gnss aided accelerometer bias estimation
2024-01-02 Cleanup main board and add motor controller
    [FLYTE-v2.brd, FLYTE-v2.sch, motor_controller.sch]
2024-01-04 Start layout
    [FLYTE-v2.brd, FLYTE-v2.sch]
2024-01-09 routing done
    [FLYTE-v2 - unedit.brd, motor_controller.sch]
2024-01-10 new layout
    [FLYTE-v2 - Copy.brd, FLYTE-v2.brd]
2024-01-17 Resolve clearance issue:
    [FLYTE-v2.brd]
2024-01-17 errors destroyed
    [FLYTE-v2.brd]
2024-01-17 uart xbee
    [FLYTE-v2.brd, FLYTE-v2.sch]
2024-01-18 layout done. drc left to clear
    [FLYTE-v2.brd]
2024-01-18 updated layout
    [FLYTE-v2.brd]
2024-01-18 layout done
    [FLYTE-v2.brd]
2024-01-18 Start motor conroller layout
    [motor_controller.brd, motor_controller.sch]
2024-01-19 Finish layout for v2
    [FLYTE-v2.brd, FLYTE-v2.sch]
2024-01-19 Finish schematic for motor controller
    [motor_controller.brd, motor_controller.sch]
2024-01-19 Thoda aur
    [FLYTE-v2.brd]
2024-01-19 Aur thoda
    [motor_controller.sch]
2024-01-19 Finish flyte v2
    [ADS1115IDGSR.STEP, Adafruit_BNO055_AP214.STEP, FLYTE-v2.brd, FLYTE-v2.sch, H3LIS200DLTR.STEP, S4B-PH-SM4-TB.stp, XBP24BZ7SIT-004-radio.STEP, XT30PW-M--3DModel-STEP-1.STEP]
2024-01-20 mc done
    [motor_controller_1.0.brd]
2024-01-20 Finish motor controller
    [XT60PW-F--3DModel-STEP-510211.STEP, motor_controller.brd, motor_controller.sch, motor_controller_1.0.brd]
2024-01-25 Reefing board model
    [ITG-MPU.STEP, reefingBrd.brd, reefingBrd.sch]
2024-02-15 Add motor controller i2c slave code
2024-03-12 Created a folder for libraries of payload sensors
2024-03-12 library for UV sensor
2024-03-12 Library for Lux sensor
2024-03-12 library for Temp, pressure, humidity
2024-04-22 Add FLYTE v2.1 files
    [FLYTE-v2_1.brd, FLYTE-v2_1.sch]
2024-04-25 motor controller re design
    [FLYTE-v2_1.brd, FLYTE-v2_1.sch, motor_controller_2_1.brd, motor_controller_2_1.sch]
2024-04-26 current code
    [1km launch.csv, earth.csv]
2024-04-30 Schematics of FC and motor controller
    [FLYTE-v2_1.brd, motor_controller_2_1.brd, motor_controller_2_1.sch]
2024-05-01 Schem of fc and mc
    [FLYTE-v2_1.brd, FLYTE-v2_1.sch]
2024-05-03 payload added
    [Payload.sch]
2024-05-04 payload sch 408 mc board
    [Payload.sch, motor_controller_2_1.brd]
2024-05-04 payload. yet to be verified
    [Payload.brd, Payload.sch]
2024-05-04 payload pushed
    [FLYTE-v2_1.brd, Payload.brd]
2024-05-04 Added libs for payload and moved payload under eagle files
    [Payload.brd, Payload.sch]
2024-05-05 mc 1.0
    [FLYTE-v2_1.brd]
2024-05-08 motor controller v2.1
    [S3B-XH-A-LF--SN---3DModel-STEP-56544.STEP, motor_controller_2_1.brd, motor_controller_2_1.sch]
2024-05-08 flyte done
    [B4B-XH-AM -LF--SN---3DModel-STEP-56544.STEP, FLYTE-v2_1.brd, FLYTE-v2_1.sch, TS04-66-95-BK-100-SMT--3DModel-STEP-56544.STEP, WS2812B--3DModel-STEP-510211.STEP, motor_controller_2_1.brd, motor_controller_2_1.sch]
2024-05-20 new reef
    [reefingBrd.brd, reefingBrd.sch]
2024-07-26 RP2040 Minimal
    [RP2040_Minimal.brd, RP2040_Minimal.sch]
2024-08-08 RF Test Board Documentation
    [RF_Test.brd, RF_Test.sch, RP2040_Minimal.brd, RP2040_Minimal.sch]
2024-09-10 FLYTE 3.0
    [FLYTE_3.0.brd, FLYTE_3.0.sch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]
2025-02-02 FLYTE 3.02
    [FLYTE 3.01.brd, FLYTE 3.01.sch, FLYTE-v1.brd, FLYTE_3.02.brd, FLYTE_3.02.sch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]
2025-02-11 Added the Ground Station Eagle files
    [GND_STN.sch]
2025-02-12 Added the crystel oscillator to the board
    [GND_STN.sch]
2025-02-12 Create sensors and sd card v1.sch
    [sensors and sd card v1.sch]
2025-02-13 Create GND STATION PBC 1.01.fsch
2025-02-15 Added USB-C and RESET button and corrections in Crystal Oscillator
    [GND SATION PCB 1.01.sch, GND_STN.sch]
2025-02-16 Refined power design with Schottky diode multiplexer and Buck converter
    [GND SATION PCB 1.01.sch]
2025-02-17 Finalized power regulation
    [GND_SATION_PCB_1.01_.sch]
2025-03-03 Refined power supply design for 5V and added the XT60 M connector
    [GND_SATION_PCB_1.01_.sch, GND_SATION_PCB_1.02.sch]
2025-03-05 Added buttons
    [GND_SATION_PCB_1.02.sch]
2025-03-08 revision 1
    [GND_SATION_PCB_1.02.sch]
2025-03-08 Revision 1.01
    [GND_SATION_PCB_1.02.sch]
2025-03-09 Update GND_SATION_PCB_1.02.sch
    NJIIUHHJ IH
    [GND_SATION_PCB_1.02.sch]
2025-03-09 Refined the connections for peripherals
    [GND_SATION_PCB_1.02.sch]
2025-03-10 gs 1.0 update
    [GND_SATION_PCB_1.02.sch]
2025-03-24 gs updates
    [FLYTE_3.02.sch, GND_SATION_PCB_1.02.sch]
2025-03-29 H
    H
    [nuclear breifcase v3.dxf, nuclear breifcase v4.dxf]
2025-05-15 Added the GND_STN.brd file
    [GND_STN.brd, GND_STN.sch]
2025-05-17 Updated the traces
    [GND_STN.brd, GND_STN.sch]
2025-09-28 Added the RP2354 library for eagle
    [FLYTE_3.02.csv]
